vbartusevicius/weather-station/hardware/releases/v1/README.md

# AeroMet V1 Hardware Release Package (6 Boards on 1 Breakaway Panel + 13-Part Enclosure)

Generated by `python3 hardware/scripts/build.py` (`release.py`) from `hardware/layout/v1/` and `mechanical/`: per-board
KiCad DRC reports (`<board>/drc.json`), ODB++ (AISLER; also PCBWay / Eurocircuits), Gerber X2 + drills + IPC-D-356
netlist, a generic MPN BOM and placement file (PCBWay, Eurocircuits), JLCPCB BOM / CPL, hand-fit lists,
STEP models and renders; every JLCPCB SMT part verified pin-for-pin against its EasyEDA footprint. Which file goes to
which fab house: [`docs/building.md`](../../../docs/building.md#3-ordering-the-pcbs-and-assembly). Design status and open prototype checks:
[`REVIEW_CHECKLIST.md`](../../../REVIEW_CHECKLIST.md); commissioning: [`CALIBRATION.md`](../../../CALIBRATION.md).

| Board | Size | Layers | Thickness | Role in the Station | Folder |
| :--- | :---: | :---: | :---: | :--- | :---: |
| **Breakaway Panel (`panel`)** | **`140.6 × 63.2 mm`** | **4** | **`1.6 mm`** | **All six boards on one PCB (column packing, tabs clear of parts; order with "edge rails / fiducials added by JLCPCB"), double-sided assembly** | **`panel/`** |
| **1. `main`** | `32.0 × 52.0 mm` | 4 | `1.6 mm` | Right half of the base bay: 4-pole terminal `J1` (`12–32 V` + `RS-485 A/B`), `1.1 A` / `60 V` PTC, `SMAJ36A` TVS, `SS16` reverse-polarity diode, socketed `XIAO ESP32-C6` behind an `LM66100`, `SP3485EN` RS-485 (separate TX / RX / DE, `390 Ω` fail-safe bias, `PSM712` TVS, optional `120 Ω` `R26`), `LSM6DS3TR-C` IMU, `ADS1115` heater monitor, `AO3400A` reflector heater switch, crown control lines. Power nets `0.4 mm`. | `main/` |
| **2. `crown`** | `60 × 60 mm` (notched) | 4 | `1.6 mm` | `STM32G431RBT6` (I²C peripheral `0x2A`): 4× `UCC27524` H-bridge transducer drivers on `+12V_HEAT` with `BAV99` T/R isolation, `74HC4052` + `TLV9062` receive chain into the OPAMP1 PGA biased at VREF (PA3), piezo charge amplifier (22k / 1 nF anti-alias), `AS3935` + `MA5532-AE` on SPI1, `MMC5603NJ` compass, `XC6206` LDO, dome socket `J10`, spare `+12V_HEAT` `J11`, SWD footprint `J12`. | `crown/` |
| **3. `reflector`** | `24.0 × 24.0 mm` | 4 | `1.6 mm` | De-icing heater under the reflector cone: 4× `120 Ω` `2512` `2 W` in parallel on `+12V_HEAT` (`30 Ω`, `4.5 W` regulated), `10k` NTC `TH1`, 4-pin SMD male header `J1` to probe `J2`. | `reflector/` |
| **4. `dome`** | `Ø 15.6 mm` round | 4 | `1.6 mm` | UV / visible / NIR micro-PCB under the default flanged PTFE dome diffuser (lathe or CNC version; backup: the `Ø 20 × 2 mm` `JGS1` window in `crown_window`): `GUVB-C21SD` UV-B + `GUVA-C22SD` UV-A photodiodes, `TLV9062`, `ADS1115` (0x49), `TSL25911FN`, 4-pin B2B header `J1`. | `dome/` |
| `dome_legacy` | `Ø 13.6 mm` round | 4 | `1.6 mm` | Backup dome, same riser: `LTR-390UV-01` (discontinued), `TSL25911FN`, `GUVB-C31SM` (obsolete). Released separately (not on the panel, not in the order files). | `dome_legacy/` |
| **5. `probe`** | `14.0 × 56.0 mm` | 4 | `1.6 mm` | Vertical pagoda stem, bottom to top: `J1`, slot, `SHT40-AD1F-R2`, slot (no ground plane in its bridges), `SGP41-D-R4` + `BMP585`, `SCD41-D-R2` with the backside `0.42 W` heater and `LM2903` `−7.6 °C` thermostat, right-angle socket `J2` to the reflector. | `probe/` |
| **6. `power`** | `28.5 × 21.5 mm` | 4 | `1.6 mm` | Flat under `main`: 2× `TPS54360` (`743 kHz`) → `+5V` electronics and `+12V_HEAT` (heaters, transducer drive), `AP2112K-3.3` → `+3V3_PROBE`, 10-pin JST-SH `J1` to main `J5`. | `power/` |

Enclosure (`enclosure/`): assembled-position STL / STEP per part, `print/<plate>.stl` (8 print plates, the only files to
print), renders, and purchase drawings in `drawings/`: `ptfe_dome_lathe.svg` / `ptfe_dome_cnc.svg` (default UV / light cover:
flanged PTFE dome, lathe version from round rod or CNC hemisphere version; matching `ptfe_dome_<kind>.step` in the lathe frame for
the CNC quote) and `jgs1_window.svg` (backup window, `crown_window`
top).

Hand assembly: every board folder has `<board>_assembly.pdf`: one page per populated side (bottom mirrored, as seen
from below), every part with reference + value, a red dot on pin 1 (ICs, connectors, diodes), `[H]` on hand-fitted
parts, same value = same colour, large parts dashed (fit them last), and a value list with quantities and references.

Print process: the enclosure is designed for MJF / SLS PA12 (powder nylon, ~±0.3 mm), but **no part of it has been
printed yet** (no tested process). Design rules it follows (`mechanical/tests/test_print_rules.py`): snap beams ≤ 2.5 %
strain, hook undersides ≥ 0.3 mm above the board with a lead-in ramp, printed threads 0.30 mm flank clearance per side,
separate bodies on one plate ≥ 0.3 mm apart (reset button 0.40 mm), engraved marks ≥ 0.6 mm deep and ≥ 3 mm. Check on the
first print: clip snap force, thread fit (strut M12 + locknuts, probe sleeve M22, dome / window nuts M22), the three
bayonet joints locking, the reset button and umbrella moving freely, and the lock marks being readable.

## Parts orders for self-assembly (one complete station)

Generated by `hardware/scripts/order_parts.py` with every release (`release.py`); `hardware/tests/test_order_files.py`
fails when they differ from a fresh export. Live stock check: `python3 hardware/scripts/order_parts.py --check`.

| File | Upload to | Column mapping |
| :--- | :--- | :--- |
| `order_lcsc.csv` | lcsc.com → **BOM Tool** → Upload BOM | `LCSC Part Number` → *LCSC Part #*, `Quantity` → *Quantity*; optional `Manufacturer Part Number` → *MPN*, `Designators` → *Designator*, `Value` / `Footprint` → *Comment* / *Footprint*. Set the multiplier to 1 (one station); LCSC rounds each line up to its minimum order. |
| `order_elsewhere.csv` | by hand, per shop | electronics the LCSC store does not sell: `Mouser` / `Digi-Key` / `TME` columns (several numbers per shop separated by ` / `, the first preferred) + `Other sources`. General hardware (fasteners, O-rings, cable gland, thermal filler, coating, UV cover) and printed parts are only in `assembly_parts.csv` (column `Category`) |

`order_lcsc.csv` merges all boards (the legacy dome as `dome_legacy:ref`) into one line per LCSC number (designators `board:ref`) and adds the off-board
parts whose `Part` names an LCSC number. JLCPCB numbers the LCSC store does not stock are swapped for verified store
numbers in `hardware/product/lcsc_store.yaml` (the board BOMs keep the JLCPCB numbers). Parts the LCSC store does not sell (Sensirion SCD41 / SGP41 / SHT40, AS3935) are listed in
`order_elsewhere.csv` with a verified distributor (TME / Farnell / RS) from the `elsewhere:` section of that file. Run `--check` before ordering:
store stock changes daily, and the check lists every line that cannot be ordered as it stands.
