vbartusevicius/weather-station/REVIEW_CHECKLIST.md

# AeroMet V1 — Manufacturing-Readiness Fix Checklist

Source: design review of 2026-10-20 (commit `22ec981`). Phase 1 fixes applied 2026-10-21 (independent electrical / mechanical / docs items).
Status of the design: **NOT ready to order** (open: prototype checks Q1–Q4, Q6, S1–S5, N9–N10; sourcing decision B2; budget B5 re-quote; deferred N4). Review of 2026-10-23 (commit `6bfb492`) added N1–N13 (section 4c). Phase 2 (crown STM32 wind / rain / lightning, 12 V heater rail, RS-485 RX) is in source and the
release regenerates cleanly, but it is unprototyped: the bench / prototype checks listed per item are still required.
Commissioning / calibration steps for every built station: `CALIBRATION.md`.
Tick an item only when the fix is in the source (`hardware/circuits`, `hardware/circuits/variants/v1`, `mechanical/scripts`,
`station/src`), the release is regenerated (`python3 hardware/scripts/build.py`), and the listed acceptance check passes.

Severity: **B** = blocker (board/part will not work or cannot be assembled) · **H** = high (works badly / out of spec)
· **M** = medium (accuracy, robustness) · **D** = documentation/BOM.

---

## 1. Electronics (schematic)

- [x] **E1 (B) RS-485 receive path is impossible on one GPIO.** `blocks/mcu_xiao.py`, `firmware/main.cpp` (`uart_set_pin(UART_NUM_1, 18, 18, …)`).
  - **Status:** DONE in source (Phase 2): SP3485 DI / RO / DE+RE on GPIO16 / 17 / 19 (UART1 TX / RX / RTS, `UART_MODE_RS485_HALF_DUPLEX`), 390R fail-safe bias (≈ 0.25 V across a 120 R terminator), optional hand-fit 120 R terminator R26. OPEN: bench test with a USB-RS485 adapter.
  - TX push-pull fights RO (via 1 kΩ); in open-drain mode a received LOW enables DE → echo/oscillation.
  - Fix: separate TX and RX GPIOs (free a pin, e.g. move `US_SEL_A/B` to an I²C GPIO expander or use a TX-gated DE with RO on its own pin), or use a transceiver with true auto-direction.
  - Fail-safe bias 4k7/4k7 gives ≈ 41 mV with a 120 Ω terminator (needs ≥ 200 mV): use ≈ 560–680 Ω bias or document "no termination".
  - Accept: bench test with a USB-RS485 adapter (terminated) — PING/PONG + telemetry both ways at 115 200 bps.
- [x] **E2 (B) Probe heater thermostat LM393 outside common-mode range.** `blocks/probe_sensors.py` U4 on +3V3, inputs ≈ 2.27 V (CMR ≤ VCC−1.5 V = 1.8 V, ≤ 1.3 V over temp).
  - **Status:** DONE (Phase 1): U4 = LM2903 on +5V_HEAT (CMR 0..3.0 V over temp covers the 2.27 V node); hysteresis comment corrected to ~1.4 K.
  - Fix: swap NTC/resistor positions so the node sits ≈ 1.0 V (recompute setpoint + hysteresis), or power U4 from +5V_HEAT, or use a rail-to-rail comparator (e.g. TLV7031/TLV3201).
  - Accept: hand calc / SPICE shows both inputs within CMR from −40 °C to +60 °C; recompute hysteresis (current R7 gives ≈ 1.4 K, not 0.4 K).
- [x] **E3 (H) LM393DR2G is 0…+70 °C only** (crown U4, probe U4). Replace with LM2903 (−40…+125 °C) or automotive LM393.
  - **Status:** DONE (Phase 1): probe U4 is LM2903DR2G (C57474, -40..+105 C per onsemi / JLC data).
- [x] **E4 (B) 3.3 V logic into 5 V CMOS on the crown.** `blocks/crown_sensors.py`: SN74LVC2G04 U1 (VIH = 0.7·VCC = 3.5 V) and CD4052 select A/B (VIH 3.5 V) driven by 3.3 V GPIO over a 260 mm cable.
  - **Status:** DONE (Phase 2): no logic crosses the cable any more; the crown runs everything at 3.3 V (STM32, 74HC4052 at 3.3 V, UCC27524 TTL-threshold inputs).
  - Fix: 74AHCT1G04 / 74HCT-family driver, 74HCT4052 (or level shifter), or run the mux at 3.3 V.
- [x] **E5 (H) Ultrasonic TX AC-coupled below the mux VEE.** `US_TX_AC` swings ± around 0 V into CD4052 with VEE = GND → clamps into body diodes.
  - **Status:** DONE (Phase 2): TX no longer passes the mux; UCC27524 H-bridge per transducer with BAV99 T/R isolation; RX AC-coupled and biased at VREF inside the mux rails (ngspice: 0.25 mA peak mux-diode current).
  - Fix: bias the TX node at mid-supply or drive the mux with VEE negative / use a dedicated TX switch.
- [x] **E6 (H) Ultrasonic link budget unverified (likely 20+ dB short).** ≈ 3 Vpp through 1 kΩ into closed-face transducers; RX gain 529; threshold 230 mV.
  - **Status:** DONE in design (Phase 2): 21.8 Vpp H-bridge drive from +12V_HEAT (ngspice `hardware/sim/crown_us_link.py`), receive chain G 7.8 x PGA 2..32 sized for a 3..170 mV echo. OPEN: the echo amplitude is an estimate until measured on the real transducers + reflector.
  - Fix: higher-voltage TX (H-bridge/transformer, 20–100 Vpp per transducer datasheet), reconsider 1 kΩ RX load, re-derive gain.
  - Accept: breadboard with the actual transducers + printed reflector geometry shows ≥ 10× margin over threshold at −20 °C and in rain.
- [x] **E7 (H) Zero-cross + envelope comparators are wired-AND to one pin** → output is just "amp > VTH" (amplitude-dependent timing, cycle-slip = 25 µs ≈ 29 m/s).
  - **Status:** DONE (Phase 2): echoes digitised at 2 MSPS; 50 % envelope fit for the mean ToF + reciprocal cross-correlation (coarse lobe from the envelope, so no cycle slips at > 1 period); host tests on simulated echoes (`pio test -d crown -e native`).
  - Fix: envelope gate latches/enables a true zero-cross edge (separate outputs or logic), firmware measures several zero-crossings / phase.
- [x] **E8 (B) AS3935 antenna is a shielded power inductor.** `blocks/main_sensors.py` L2 SWPA6045S221MT (closed core, ±20 %, f0 = 495 kHz < 500 kHz).
  - **Status:** DONE (Phase 1): L2 = Coilcraft MA5532-AE (hand-fit) + 2x 470 pF C0G (AN04 953 pF target), 10k Q damping, In1/In2 plane keepout under the antenna. Verify tuning (TUN_CAP near 73 pF) on the prototype.
  - Fix: Coilcraft MA5532-AE (or datasheet-approved ferrite rod) + matching C0G tank cap; keep 500 kHz ± 3.5 % tunable.
- [x] **E9 (B) Both SCT2430 bucks switch at 500 kHz = AS3935 receive band**, ~10 mm away. `blocks/power_supply.py` RT = 200k.
  - **Status:** DONE (Phase 1): bucks at 743 kHz. Phase 2: move the AS3935 + MA5532 to the crown board on the STM32 SPI bus (away from the bucks / ESP32, fixes E10 too).
  - Fix: move fsw to 1.5–2.2 MHz (re-design L/C/compensation per datasheet) and/or relocate AS3935 away from the power board and ESP32.
- [x] **E10 (H) AS3935 over I²C is known-unreliable** (vendor/breakout notes). Consider SPI (needs pins — see E1) or verify on prototype.
  - **Status:** DONE (Phase 2): AS3935 on the crown STM32 SPI1 (SI = GND), automatic TUN_CAP tuning by counting LCO/16; AS3935 + MA5532 removed from main.
- [x] **E11 (B) Input surge protection cannot protect SCT2430 (40 V max).** SMAJ33A clamps at 53.3 V; PTC rated 33 V.
  - **Status:** DONE (Phase 1): 12-32 V kept; power board = 2x TPS54360 (60 V), SMAJ36A (58.1 V clamp), 2920L110/60V PTC, 100 V input MLCCs on main and power.
  - Fix: 60 V-class regulators (e.g. LMR36015/TPS54560 class) or lower the input spec (e.g. 12–24 V) with a matching TVS; consider SMBJ/SMCJ size for a roof cable.
- [x] **E12 (H) No surge/ESD protection on RS485_A/B** (outdoor cable, lightning region). Add SM712-type TVS + optional series PTC/resistors.
  - **Status:** DONE (Phase 1): D4 = PSM712 (C32677, basic part) at J1.
- [x] **E13 (H) Piezo rain AFE.** `blocks/crown_sensors.py` U5A: non-inverting input at 0 V on single supply, 100k‖18p (corner 88 kHz → not a charge amp), hail drives input below GND through only 1 kΩ.
  - **Status:** DONE (Phase 2): true charge amplifier (22 nF ‖ 4.7 MΩ at VREF), 1 k series + BAV99 clamp, digitised by STM32 ADC2 at 50 kSPS (`RainDetector`, host-tested). OPEN: rain calibration (S2).
  - Fix: bias at VREF, true charge amp (e.g. 1–10 nF ‖ 10 MΩ), ≥ 10 kΩ series + clamp diodes (BAV99) to rails; add a real peak detector if an envelope is wanted.
- [x] **E14 (M) I²C rise time.** 4k7 pull-ups on ≈ 200 pF (12 devices + 260 mm + 60 mm + 100 mm cables) → ≈ 0.8 µs > 300 ns (400 kHz).
  - **Status:** DONE (Phase 1): I2C pull-ups 2.2k (C4190, basic). 2026-10-23 (N11): ~180 pF with 2.2k still rises in ~335 ns (> 300 ns fast-mode), so every device now runs at 100 kHz.
  - Fix: 2.2 kΩ (check all sink currents) and/or 100 kHz bus; keep US_TX away from SDA/SCL in the 12-pin cable pin order.
- [x] **E15 (M) Reflector heater resistors at 93 % of rating** (4× 27 Ω 2512 1 W at 5 V) touching the plastic deck (0.08 mm). Use 2 W parts or more resistors; add firmware over-temperature cut-off on TH1.
  - **Status:** DONE (Phase 1): reflector resistors 27R 2512 2 W HP12 (C2791259) = 46 % of rating; firmware open-NTC SensorFault lockout (unit-tested).
- [x] **E16 (M) 3V3 budget from the XIAO LDO** (≈ 550 mA peaks: ESP32-C6 TX + SCD41 + sensors; Seeed rates 600–700 mA). Measure on prototype or add a dedicated 3V3 regulator.
  - **Status:** DONE: dedicated `+3V3_PROBE` rail: AP2112K-3.3 (C51118, 600 mA, -40..+85 C) on the power board from +5V, through power J1 / main J5 (now 10-pin, 3 GND contacts) straight to probe J3 pin 7. The XIAO 3V3 regulator now carries only the ESP32-C6 (354 mA TX peak) + main-board sensors / pull-ups / RS-485 bias (≈ 25 mA) ≈ 380 mA vs its 700 mA rating; the probe rail peaks ≈ 215 mA (SCD41 205 mA) vs 600 mA. OPEN: confirm on the prototype (CALIBRATION.md step 1).

## 2. PCB layout / fab

- [x] **P1 (H) Power board is auto-routed with 0.3 mm tracks** for VIN / SW / VOUT, GND plane only on In1, no pours, few vias.
  - **Status:** DONE: TPS54360 stages per SLVSBB4G; SW nodes, VIN and VOUT are F.Cu pours (SW ~14 mm2, 3.5 mm residual track + 1 via to the bottom boot cap), J1 along the top edge, board 28.5 x 21.5 mm; 0 DRC / 0 unrouted.
  - Fix: hand layout per SCT2430 datasheet (tight hot loop, pours on F.Cu, thermal vias under EP, SW node minimal area).
- [x] **P2 (M) Probe: reflector heater current (now ≈ 0.4 A at 12 V, was 0.74 A) routed past SHT40**, and the In1 GND plane connects SHT40 to J1 (which sits in the warm base bay).
  - **Status:** DONE: second milled slot (y 9.0-10.2, copper keep-out on all layers) between J1 and the SHT40, so heat from the base bay and the heater pair reaches the SHT40 only over the two 2 mm side bridges; probe re-routed 0 DRC. The heater-side coupling was still large: see N2.
  - Fix: route heater pair on the far edge, add copper keep-out / second slot between J1 and SHT40.
- [x] **P3 (M) Panel has no fiducials, tooling holes or edge rails** (5-board panel 146.6 × 52.1 mm; the crown ships as its own board). Add rails + fiducials or order "added by JLCPCB" for both orders.
  - **Status:** DONE (owner decision: no own rails): compact 140.6 x 63.2 mm panel (column packing search over rotations / orders, tabs placed >= 1 mm from part pads, every board on >= 2 tabs); order with "Edge rails / fiducials: added by JLCPCB".
- [x] **P4 (D) Double-sided assembly** on the panel (main, power, probe, dome, reflector bottom parts) and on the crown — budget for it.
  - **Status:** DONE (costed): the panel has parts on both sides (97 top / 109 bottom placements): Standard PCBA double-sided adds $25.56 setup and $8.21 stencil over single-sided (included in B5); no part forces a single side.

## 3. Mechanical (verify on released STEP, not only on the parametric model)

- [x] **M17 (B) Main J1 pin labels were mirrored** ("+V GND A+ B-" over a 180-deg rotated terminal whose pins run B-, A+, GND, +V).
  - **Status:** DONE: per-pin labels at each pad; every connector now carries a silk label with the board/port it connects to (`connector_labels`).

- [x] **M1 (B) Bayonet O-rings have zero compression.** Gland 1.70 mm (up to 1.90 mm with lug play) vs 1.5 mm CS, on base↔pagoda, pagoda↔wind_tunnel, crown_base↔crown.
  - **Status:** DONE (Phase 1): 88 x 2.0 mm O-rings; glands 1.5 mm modelled / 1.7 mm at rest (15 %) / 1.23 mm pushed (38 %, 77 % fill); `test_bayonet_o_rings_are_squeezed_15_to_40_percent`.
  - Fix: design the gland for 15–25 % squeeze of a real O-ring (e.g. depth ≈ 1.15–1.25 mm with CS 1.5 at the locked position, or CS 2.0 mm ring); make lug shelf hold the compressed state.
  - Accept: new test computing gland height at the locked lug position vs purchasable O-ring CS.
- [x] **M2 (B) Printed M12 strut nuts: thread groove (r 6.22) cuts through the 12 mm flats** — nut section splits into pieces. Pockets Ø15.2/Ø16.4 cannot take real M12 nuts (18 AF).
  - **Status:** DONE (Phase 1): printed nuts 15 mm AF (1.28 mm wall at the flats), pockets r 9.0; README no longer claims metal-nut compatibility; `test_printed_strut_nuts_keep_a_wall_at_the_flats`.
  - Fix: either real ISO M12 nuts (pocket ≥ 18.6 AF/round 21) or a non-standard printed thread with ≥ 1.5 mm wall at the flats.
- [x] **M3 (B) ISO 4762 M6 socket heads (Ø10 × 6 mm) collide with all 4 reflector board corners** (2.4 mm³ each). Tests model a 2.4 mm head.
  - **Status:** DONE (Phase 1): DIN 7984 low-head M6x55 (head 10 x 3.5) in BOM/CAD, head wells Ø 10.6; test models real head + ISO 4032 nut + bolt tip vs pagoda, wind_tunnel, struts, reflector board, base.
  - Fix: DIN 7984 low head / button head, or chamfer reflector corners, or move bolts; head wells Ø10.0 → Ø10.6.
- [x] **M4 (B) Crown cable path.** Ø4.2 mm cable vs 3.35 mm sleeve conduit (73 mm³ overlap); 4.38 mm gap under wind_tunnel deck with the NE M6 head on the radial path; 90° bend into the strut within ≈ 3 mm; plug must pass the M12 nut bore.
  - **Status:** DONE: rear conduit 4.1 mm deep with >= 0.8 mm walls (probe_sleeve_back widened/deepened inside the r 10.35 hub-bore circle), `test_crown_cable_and_probe_jumper_sweep_clear`: Ø 3.2 mm cable (+0.3) on a 10 mm bend radius from main J2 through the umbrella window, conduit, pagoda gap, NE strut and past the crown NE chamfer to crown J1 clears every part and PCB; path 202 mm + slack fits the 260 mm BOM cable. OPEN: thread-and-crimp assembly step on the first build.
  - Fix: widen conduit ≥ 5 mm, dedicated radial groove in the wind_tunnel underside clear of bolts, larger bend space, or use a flat FFC/ribbon + inline connector.
  - Accept: test sweeping a Ø(cable + 0.5) tube along the full routed path from main J2 to crown J1 with zero intersection.
- [x] **M5 (B) Transducer barrels Ø10.5 mm vs listed Ø14+ mm parts.** Pick ONE purchasable waterproof 40 kHz transceiver, then size barrel, aperture and retaining ring to its drawing.
  - **Status:** DONE: default transducer = Same Sky CUSA-TR65-065-2200-TH68 (Ø 14 x 9 mm aluminium, IP68, 150 Vp-p rated, 2200 pF, 65 deg, -40..+80 C, ~$3-6 at Digi-Key / Mouser) straight in the Ø 14.6 mm barrels (0.3 mm radial clearance), locked by the printed rings; tested in CAD (can, ring, Ø 12 mm aperture, crown PCB). Alternatives with a rated drive: PUI UTR-1440K-TT-R (Ø 14.4, 140 Vp-p), Multicomp MCUSD14A40S09RS (Ø 14, 160 Vp-p). Ø 10 mm parts (EU10AIF40H07T/R) still fit the printed sleeves but publish no drive rating. OPEN: check the can tolerance on the delivered parts.
- [x] **M6 (B) Captive printed-in-place parts.** base.stl: umbrella (0.40 mm gap) and reset button (0.30 mm) inside the base; struts.stl: nuts threaded on with 0.2 mm, rings 0.098 mm from the dome nut. MJF/SLS fuse < ~0.5 mm; FDM cannot print the floating umbrella.
  - **Status:** DONE (Phase 1): `enclosure/print/<part>_<nn>.stl` one body per file (base 3, pagoda 5, struts 21, orings 5, mast_shims 4); README/BOM point to it; `test_every_print_body_is_exported_separately_and_printable`.
  - Fix: export every separate body as its own STL (`umbrella.stl`, `reset_button.stl`, `strut_half_*.stl`, `m12_nut.stl`, …); use ≥ 0.5 mm clearance where parts must print captive.
- [x] **M7 (H) Mast clamp only clamps Ø33.5–34 mm** (split gap 0.5 mm), 19 mm pole engagement. Fix: ≥ 2–3 mm clamp travel + shims for 25–34 mm, ≥ 40 mm engagement, consider U-bolts / hose clamps.
  - **Status:** DONE: 40 mm tall clamp (owner decision; socket from y = -12, 31 mm pole engagement), 6x M6 bolts in 3 rows (13 mm pitch, ISO 7089 washers), 2.0 mm clamp travel, 4 shim sizes 31 mm tall (Ø 24-34 mm poles). Keep bolt torque moderate on PA12.
- [x] **M8 (H) Pagoda louvers ≈ 0.71 mm thick** (measured) on ≈ 24 mm spans. Fix: ≥ 1.5–2 mm normal thickness.
  - **Status:** DONE (Phase 1): louver blades 1.6 mm normal thickness (lower surface moved down).
- [x] **M9 (H) Radiation shield leaks:** 64/256 horizontal and 124/204 upward (−10°) rays reach the probe core. Fix: overlapping louvers that block lines of sight both from sky and from roof (classic double-louver Stevenson profile).
  - **Status:** DONE: labyrinth = upturned rim on each blade's inner edge (r 24.2–25.8, +7.0 mm) + down-skirt under the blade / top deck above (r 30.0–31.4, to +5.0 mm). `test_radiation_labyrinth_blocks_every_line_of_sight_to_the_probe`: 0 of 2 × 2 480 rays aimed at the shielded zone (y 76–115.5) (−75…+75°) reach the probe core (92 per section without it). Cost: the narrowest air passage drops from ≈ 9.4 mm to ≈ 3.3 mm (rim-to-skirt channel), so expect more self-heating error in still air — check against an aspirated reference (S3).
- [x] **M10 (M) Reflector deck "thermal contact" relies on a 0.08 mm gap** with stack-up tolerance ±0.3 mm. Add a compliant thermal pad or define a hard stop.
  - **Status:** DONE (BOM + README): silicone-free thermal gap filler between the heater resistors and the deck covers the 0.08 mm (+/-0.3) gap; silicone excluded because it poisons the SGP41.
- [x] **M11 (M) No U.FL antenna cradle in CAD** (claimed in README/BOM). Add it or remove the claim.
  - **Status:** DONE (Phase 1, docs): no cradle in V1; BOM/README say adhesive-mount the dipole on the inner wall.
- [x] **M12 (M) Reset-button bore is an open hole** (no O-ring in CAD, README says waterproofed). Add gland or membrane.
  - **Status:** WON'T FIX (owner decision): an O-ring's friction would stop the button's spring from returning it. The bore opens downward on the base underside (drip side, no standing water) and the README no longer claims a waterproof button.
- [x] **M13 (M) JGS1 dome stack-up.** Flange must be ≤ 1.2 mm thick (194.2 − 193.0); dome PCB clears the inner hemisphere by only ≈ 0.3 mm; no desiccant/vent → internal dew. Get a real dome drawing and add an ePTFE vent or desiccant.
  - **Status:** DONE (stock part + option; superseded by N3: the default is now the PTFE dome in `crown`, the window top is `crown_window`): two crown tops. Window top: stock uncoated Ø 20 x 2 mm JGS1 disc in a raised boss, thin 17 x 1.0 mm O-ring between the window top and the 1.2 mm lip (seal lid <-> glass, the nut thread is outside the wet side), printed nut pushes the window from below; sensors 0.5 mm under the window; drains through the lip above the seal plane. Sky view from ~19-32 deg elevation (S4 corrects). `crown_dome`: Ø 20 mm hollow JGS1 hemisphere (made to order), lid flush at y 198.0 under the sensor tops (horizon view, no raised border), 19 x 1.0 mm O-ring in the bore / lip-underside corner gland squeezed ~21 % by the sphere, shorter nut. Both nuts on the struts plate. Tests: `test_uv_window_stack_fits_the_crown_lid`, `test_uv_dome_crown_top_fits`. Drawing `enclosure/drawings/jgs1_window.svg`.
- [x] **M14 (M) Cable gland needs a hollow mast** (gland dome nut extends below the y = 19 mm pole stop). Document the required mast ID.
  - **Status:** DONE (docs): README section 4 and the gland BOM line require a hollow mast with ID >= 18 mm (e.g. 33.7 x 3.2 mm pipe) with the cable inside.
- [x] **M15 (M) Probe sleeve final angle is set by thread run-out + O-ring squeeze** (uncontrolled). Add a key/index or a non-threaded keyed bayonet.
  - **Status:** WON'T FIX (owner decision): a key would stop the thread before the bottom O-ring reaches full squeeze. The probe works at any sleeve angle (the sleeve is round; the probe board's orientation comes from its own slot).
- [x] **M16 (D) "No supports needed" FDM claim** is not true for base clips/hooks, barrels at 29°, umbrella. Re-check print orientation per part.
  - **Status:** DONE (docs): README FDM orientation / support table per print plate (MJF/SLS need none).

## 4. Firmware

- [x] **F1 (B)** UART single-pin config (see E1).
  - **Status:** DONE in source (Phase 2): separate RX pin, RS-485 half-duplex mode with RTS-driven DE (see E1).
- [x] **F2 (H)** Ultrasonic: 300 µs settle is short for ringing closed-face transducers + 48 mm cavity reverberation; first-edge capture has cycle-slip risk. Implement multi-zero-crossing / phase measurement, longer settle, and cross-check N→S vs S→N cycle index.
  - **Status:** DONE (Phase 2): crown firmware (`crown/`) with sampled-echo DSP (see E7); the station receives CRC-checked times of flight over I²C and rejects quads with any bad path.
- [x] **F3 (M)** RS-485 streams telemetry unconditionally every cycle → collides with a polling master. Respond only when polled or use a time slot.
  - **Status:** DONE in source: `task_rs485` answers `STATE?` with the latest frame (plus `PING`, `RESET_RAIN`, `HEAT_CHECK`) and never transmits unsolicited. OPEN: bench test with a polling master.
- [x] **F4 (M)** I²C at 400 kHz for every device (see E14); PMSA003I 100 kHz max.
  - **Status:** DONE: the whole bus runs at 100 kHz (`board::i2c_speed_hz`, N11); per-device speeds stay possible via `I2cBus::add(addr, hz)`.
- [x] **F5 (M)** Heater over-temperature cut-off and NTC plausibility (open/short) before enabling PWM.
  - **Status:** DONE (Phase 1): `HeaterState::SensorFault` for an open reflector NTC (> 3270 mV), unit test added. 25 C over-temperature cut-off already existed.

## 4b. Phase 2 items still open (crown v2 / 12 V rail)

- [ ] **Q1 (H)** Crown firmware HAL glue (`crown/src/main.cpp`) compiles but has never run: bring up on the first board with SWD (`J12`, Tag-Connect TC2030-NL): clock, TIM8 burst + dead time on a scope, ADC/TIM6 sample timing, I²C peripheral, AS3935 SPI + tuning.
- [ ] **Q2 (H)** STM32G431 ROM I²C bootloader address: firmware tries 0x52 and 0x56; confirm against AN2606 / the first board (CALIBRATION.md step 2). `kCmdEnterBootloader` relies on a `.noinit` RAM flag the default linker script may zero; the BOOT0 line is the primary path. BOOT0 pin: RM0440 factory option bytes (`FLASH_OPTR` = 0xFFEF F8AA: nSWBOOT0 = 1, nBOOT0 = 1) take BOOT0 from PB8, so a factory-fresh chip honours CROWN_BOOT0 — confirm on the first board.
- [ ] **Q3 (H)** Echo amplitude: ngspice uses an estimated ~50 mVpp EMF; measure with the real transducers + printed reflector, then trim the preamp gain (R21) if needed. Wind-tunnel calibration (S1) still required.
- [ ] **Q4 (M)** AS3935 vs ultrasonic bursts: log disturber / noise events with bursts on and off on the prototype (actions `crown_bursts_off` / `crown_bursts_on`, counters in `/api/config` → `crown.disturbers`; CALIBRATION.md step 9).
- [x] **Q5 (M)** Transducer adapters (M5): barrels now Ø 14.6 mm (Ø 12 mm aperture, 8.8 mm shroud clipped below the crown PCB), crown notches 16 mm wide; printed `transducer_adapters` = 4 Ø 10 mm sleeves (installed by default) + 4 rings for Ø 14 mm cans. Tested: both can sizes, rings and apertures clear barrels, sleeves and the crown PCB. OPEN: confirm against the real transducer drawings (can height, pigtail exit) before printing.
- [ ] **Q6 (M)** +12V_HEAT pass-through below ~13.5 V input: verify the TPS54360 near-100 % duty behaviour and heater power on a 12 V supply.
- [x] **Q7 (H) UCC27524 enable pull-up.** ENA/ENB are pulled up to VDD = 12 V through 200 kΩ (SLUSFA9 `RENx`, typ.); the 10k pull-down left an undriven EN at 0.57 V against a 0.8 V minimum low threshold.
  - **Status:** DONE: R13–R16 = 4.7k → 0.28 V undriven (drivers off in reset / bootloader); the STM32 drives 3.3 V (> 2.3 V max high threshold) and sinks ≤ 60 µA from the internal pull-up when low.
- [x] **Q8 (H) Rain wetness flag stuck on.** Crown impacts carried a fixed 206 mV "baseline" ≥ the 140 mV wet threshold.
  - **Status:** DONE: crown impacts carry baseline 0 (no capacitive channel); `HapticRainProcessor` then reports wet while a rain event runs and keeps rejecting only long (> 850 µs) pulses during mast shake. New `rain_impact_scale` maps charge-amp mV to the drop / hail thresholds (CALIBRATION.md step 6). Unit-tested. OPEN: the thresholds themselves need the field calibration.
- [x] **Q9 (H) Wind wrong until calibrated.** The crown times the 50 % envelope point (~58 µs after the first arrival); `us_delay_us` defaulted to 0 → speed of sound and wind magnitude off by ~35 %.
  - **Status:** DONE: default 58 µs, plus the `wind_calibrate` action (60 s still air, delay + zero-wind offsets from the SHT40 temperature, refuses moving air; unit-tested) and `wind_speed_gain` for the reference comparison (CALIBRATION.md steps 4–5).
- [x] **Q10 (M) RS-485 multi-drop.** Every station answered `STATE?`; `PONG` carried a fake `*0000` checksum.
  - **Status:** DONE: `rs485_address` (0 = single station, 1–247 = `<addr>:CMD`, talker `$AM<addr>`), real CRC-16/MODBUS on `PONG`; unit-tested. OPEN: bench test (CALIBRATION.md step 3).
- [x] **Q11 (M) Crown status read unprotected.** The 2-byte status shared the 260 mm cable with the 50 mA drive bursts without a CRC.
  - **Status:** DONE: protocol v2, `kStatus` = status + CRC-8, the station drops bad reads (crown + station tests). OPEN: measure crosstalk on the first board (scope on SDA/SCL during bursts).
- [x] **Q12 (H) Crown production programming.** PARTIAL: no SWD fixture is needed — a factory-blank STM32 enters its ROM I²C bootloader when the station raises BOOT0 (RM0440 default option bytes), so the station flashes it (`POST /api/crown/firmware`, CALIBRATION.md step 2); SWD is a Tag-Connect TC2030-NL footprint (`J12`) for debug / recovery. OPEN: release the crown image with each station release and add a station-side version check / auto-update (not implemented).
  - **Status:** DONE: the station embeds the crown image (`CrownImage.hpp`, `station/scripts/pack_crown_image.py`, crown fw 0.2.0) and at boot reflashes a crown with another version or a blank one (one attempt per boot, result in `/api/config` → `crown.auto_update`); decision host-tested. SWD via the TC2030-NL footprint `J12` for debug only. OPEN: confirm on the first board (Q2).
- [x] **Q13 (M) Transducer drive rating.** ~22 Vpp differential bursts (8 cycles, 16 / s): confirm the chosen transducer's maximum drive voltage from its datasheet before ordering (EU10AIF40H07T/R or the Ø 14 mm alternative).
  - **Status:** DONE: CUSA-TR65-065-2200-TH68 is rated 150 Vp-p; the ~22 Vp-p bursts are 15 % of that.
- [x] **Q14 (M) Power-board hot loop after the Phase 2 re-route.** Re-measure SW-node copper on the final released `power.kicad_pcb`.
  - **Status:** DONE (measured on the release): LOGIC_SW / HEAT_SW pours 13.7 mm² each on F.Cu, 3.8 / 3.4 mm of residual 0.4 mm track, 1 via each (boot cap); VIN_PROT 22.4 mm², +5V 17.6 mm², +12V_HEAT 18.2 mm² pours — same as the Phase 1 hand layout.
- [x] **Q15 (D) Crown is a separate PCBA order.** 60 × 60 mm non-rectangular 4-layer board, double-sided assembly, 0.5 mm-pitch LQFP-64 on the bottom: quote it separately (see B5).
  - **Status:** DONE: the crown is on the panel (right end, 3 rail tabs; both facing edges near the power board are too crowded for side tabs).
- [x] **Q16 (M) Config migration.** New `StationConfig` fields used to reset the whole NVS config (Wi-Fi, location) on every firmware update (`len == sizeof`).
  - **Status:** DONE: fields are only appended; a shorter stored blob fills the prefix and new fields keep their defaults.

## 4c. Review of 2026-10-23 (N-items)

- [x] **N1 (B) Crown PGA amplified the 1.65 V bias.** OPAMP1 ran in the plain PGA mode (`PGA_CONNECT_INVERTINGINPUT_NO`): Vout = G × 1.65 V pinned the ADC at the 3.3 V rail for every gain, so no echo could be measured (E6 / E7 / F2 / Q3 were blocked by it).
  - **Status:** DONE in source: U1 pin 17 (PA3 = OPAMP1_VINM0) on `US_VREF`, firmware `OPAMP_PGA_CONNECT_INVERTINGINPUT_IO0_BIAS` (Vout = G (Vin − VREF) + VREF), the gain writes keep the bias bits; ngspice + test `test_pga_is_biased_at_vref_not_ground` (preamp at its real DC level into the PGA in both modes; checks circuit + firmware). Crown fw 0.3.0. OPEN: scope check on the first board (CALIBRATION.md step 2.5).
- [x] **N2 (H) Probe heater warmed the SHT40.** 1-D model of the released probe: SHT40 +9.8 / +4.3 / +1.9 K at h = 10 / 25 / 50 W/m²K with the 0.42 W heater on (the In1 plane crossed the heater-side slot bridges); the heater ran at every temperature below +8 °C.
  - **Status:** DONE in source: SCD41 + heater moved to the top of the probe (next to J2), SGP41 / BMP585 to the middle, thermostat setpoint +8 → −7.6 °C (R5 22k → 51k, ~2.3 K hysteresis; the SCD41 is rated −10 °C), In1 ground plane removed from the heater-side slot bridges. Model: +5.6 / +1.7 / +0.5 K, and only below −8 °C. OPEN: cold-chamber check (CALIBRATION.md step 7).
- [x] **N3 (H) UV / light sensors blind below 19–34° solar elevation** (window 3.25 mm under the 1.2 mm lip; Vilnius winter noon sun 11.8°).
  - **Status:** DONE in source (revised 2026-10-23, owner decision): default top = `crown` with a low flush collar (0.9 mm lip, lid apex trimmed to y 197.8, 1.0 mm under the sensor tops) around a turned PTFE dome with a flat-faced Ø 20.4 x 1.5 mm flange (`UV_PTFE`): the 18 x 1.0 O-ring is squeezed 25 % flat between flange top and lip, the dome nut pushes the flat flange bottom. Two shapes from one profile function (`ptfe_dome_profile`): lathe version (default, Ø 17.8 cylinder + flat top, 2 mm edge radius, from round rod; `enclosure/ptfe_dome_lathe.step` + `drawings/ptfe_dome_lathe.svg`) and CNC version (Ø 17.8 hemisphere; `ptfe_dome_cnc.*`), 0.8 mm wall. Backup top = `crown_window` with the stock Ø 20 x 2 mm JGS1 disc. Test `test_uv_dome_crown_top_fits`: both shapes fit, flange faces flat, O-ring squeeze / lip backing, no lid material above −3° from the dome sensors (sunrise / sunset visible). No stock PTFE dome: PCBWay CNC turning (PTFE) / custom turning shop / lathe. Firmware `optics_transmission` default 0.11. OPEN: calibrate the transmission and the low-sun over-response (CALIBRATION.md step 8); total height 235 mm (lathe version; 238 mm with the CNC hemisphere).
- [ ] **N4 (H) No transducer de-icing.** Rime / wet snow on the Ø 14 mm transducer faces stops the wind measurement in freezing fog; only the reflector is heated.
  - **Status:** DEFERRED to crown v2.1 (owner decision): low-side MOSFET on J11 (+12V_HEAT) driven by a spare STM32 pin, 4 × ~1 W polyimide heater strips wrapped round the aluminium cans (barrel bore + ~0.3 mm radius), switched below +2 °C at high RH; +12V_HEAT budget ~9 W (reflector 4.5 + probe 0.4 + 4). V1 documents winter wind outages.
- [x] **N5 (M) Rain channel aliasing / burst pickup.** 50 kSPS behind 1k / 1 nF (160 kHz) aliases 40 kHz burst pickup to 10 kHz; no blanking.
  - **Status:** DONE in source: R24 1k → 22k (7.2 kHz with C22 1 nF, no new BOM line), crown firmware blanks the detector from each burst start to 1 ms after the capture (`RainDetector::add(..., blanked)`, host test `test_rain_detector_ignores_burst_window`). OPEN: dry-weather check (CALIBRATION.md step 9.5).
- [x] **N6 (M) TIM8 left OUTA high after the burst** (one-pulse mode rests at CNT = 0 < CCR1).
  - **Status:** DONE in source: TIM8 update IRQ (URS) clears MOE at the end of the burst; dead time 118 → 353 ns so CH1 cannot rise before MOE drops. OPEN: scope (CALIBRATION.md step 2.5).
- [x] **N7 (M) Main input power tracks 0.3 mm, partly on 0.5 oz In2** (VIN_FUSED 11 mm, up to ~0.9 A).
  - **Status:** DONE in source: main `power_track_width` 0.4 mm (fits the 1.0 mm JST-SH pitch).
- [x] **N8 (M) RS-485 fail-safe bias on every node** (4 stations → 97 Ω per rail + termination → below the driver VOD spec).
  - **Status:** DONE (docs): CALIBRATION.md step 3 — on buses with > 2 stations remove R9 / R10 on all but one station.
- [ ] **N9 (M) Bayonet O-ring squeeze tolerance.** 15 % at rest is the bottom of the face-seal range; +0.25 mm print / stack error leaves ~3 %.
  - **Status:** OPEN (prototype): measure glands + hose test (CALIBRATION.md step 10a).
- [ ] **N10 (M) AS3935 vs the reflector heater PWM** (0.4 A, 1 kHz, loop up the probe to under the crown); AS3935 VDD had 100 nF (datasheet 1 µF).
  - **Status:** C25 → 1 µF done in source. OPEN: disturber test with the heater on (CALIBRATION.md step 9.4).
- [x] **N11 (M) I²C rise time at 400 kHz** ≈ 335 ns > 300 ns.
  - **Status:** DONE: all devices at 100 kHz (bus load ~35 %: IMU 200 Hz, BMP585 FIFO 100 Hz, crown, slow sensors).
- [x] **N12 (M) Crown cable sourcing / crimping.** Pre-crimped 28 AWG SH leads (OD 0.8–1.0 mm) bundle to ~4 mm and do not fit the conduit.
  - **Status:** DONE (BOM / README): 30 AWG, insulation OD ≤ 0.6 mm (UL10064 / UL1571), SSH-003T-P0.2 contacts + SH-capable crimper.
- [x] **N13 (M) STM32 ROM bootloader pin noise** (USART1 RX PA10 / SPI2 NSS PB12 floating).
  - **Status:** DONE in source: R28 / R29 10k pull-ups on PA10 / PB12 (PA3 now carries VREF). OPEN: confirm with Q2.

## 5. Sensor accuracy (needs prototype + calibration, not just a fix)

- [ ] **S1** Wind: wind-tunnel calibration table per direction (strut wakes along 45°/135°/225°/315° cross the centre).
- [ ] **S2** Rain: calibrate drop count / energy vs a tipping-bucket gauge; remove "0.01 mm" claim until done.
- [ ] **S3** T/RH: compare with a reference aspirated sensor in sun / low wind; quantify base-bay and roof-radiation bias.
- [ ] **S4** UV/light: TSL25911 saturates ≈ 88 klx and is rated −30…+70 °C under a sealed dome; derive UVI/irradiance calibration.
- [ ] **S5** Temperature ratings below −10 °C: SGP41, PMSA003I, SCD41 (heater covers SCD41 only), JST-SH (−25 °C).

## 6. Chemistry / assembly

- [x] **C1 (B) README tells to use Molykote 111 / RTV silicone in the probe sleeve groove next to SGP41.** Siloxanes poison MOX sensors. Replace with a non-silicone sealant (e.g. PU / PTFE grease) and align README with `assembly_parts.yaml`.
  - **Status:** DONE (Phase 1): README now forbids silicone anywhere in the station; PTFE grease or PU resin in the sleeve groove; non-silicone coatings.
- [x] **C2 (D)** Conformal-coat keep-out list names `VEML7700` (part is TSL25911).
  - **Status:** DONE (Phase 1).

## 7. BOM / sourcing

- [x] **B1 (B)** Crown cable listed as 10-core + SHR-10V; main J2 / crown J1 are **12-pin** (BM12B). Fix BOM: 12-core, SHR-12V, pin-1↔pin-1, real routed length (spec says 160 mm, BOM 260 mm).
  - **Status:** DONE (Phase 1): BOM = 12-conductor, OD <= 3.2 mm, SHR-12V both ends pin 1 <-> pin 1, 260 mm (+ note about threading through the strut nut).
- [ ] **B2 (H)** LTR-390UV-01 and AS3935 show 0 stock at JLC → order from Digi-Key/Mouser and hand-fit (the AS3935 QFN-16 now sits on the crown, the MA5532-AE antenna too); plan hot-air rework for 2×2 mm / QFN-16.
  - **Status:** PARTIAL (sourcing checked): AS3935-BQFT Digi-Key 1,279 in stock, $13.61 (brokers ~$6); MA5532-AE(B) Mouser 994-MA5532-AE ~831, $1.93 (Coilcraft direct ~1.18 EUR); LTR-390UV-01 0 at LCSC/JLC, ~3,400 at brokers ~$0.9-1.6 (one Chinese distributor lists it as discontinued: confirm with Lite-On / Mouser before buying); GUVB-C31SM ~2,300 at brokers ~$10.5 (-30..+85 C). Instead of hand rework, these can be bought into JLC by Global Sourcing or consigned, so JLC places them. OPEN: choose consign / global sourcing vs hand-fit; LTR-390 lifecycle.
- [x] **B3 (H)** JGS1 Ø18 dome with Ø20.5 flange is custom — get a quote + drawing before freezing crown CAD.
  - **Status:** DONE: stock part — AliExpress "Various Sizes JGS1 UV Grade Fused Silica Window Quartz Glass Polished Disk" in 20 x 2 mm (~€6-10), uncoated (do not use 1064 nm AR-coated laser protective windows: the coating cuts UV-B). OPEN: check the delivered diameter (19.8-20.1) and thickness (1.8-2.2) on arrival.
- [x] **B4 (M)** PMSA003I needs a custom 6-pin ZH → 2×5 1.27 mm harness; transducers need JST-SH pigtails. Define both with drawings.
  - **Status:** DONE (docs): README section 4 harness table with pin-by-pin conductors for the crown cable, probe and power jumpers, PM harness, transducer and piezo pigtails.
- [ ] **B5 (M)** Budget: one JLC PCBA panel + hand-fit parts + prints — re-quote at order time.
  - **Status:** ESTIMATE (JLC price list Oct 2026 + supplier snapshot; re-quote at order time), 5 panels = 5 stations, Standard PCBA double-sided: parts ≈ $302 (minimum order quantities included), extended-part feeder loading 65 x $1.53 ≈ $99, setup $51.12 + stencil $16.42 + fixtures ≈ $16 + handling ≈ $15, joints (695 SMD + 42 THT per panel) ≈ $13 -> ≈ $510 assembly + parts (≈ $102 / station), + 4-layer ENIG 140.6 x 63.2 mm PCB fab (online quote). Hand / off-board parts per station ≈ $105-125: PMSA003I $40, 4x CUSA transducers ≈ $24, AS3935 ≈ $6-14, GUVB-C31SM ≈ $10.5, XIAO ESP32-C6 ≈ $5, dome ≈ $6-27, MA5532 ≈ $2, LTR-390 ≈ $1-2, cables / O-rings / fasteners / gland / gap filler ≈ $25; + MJF prints (8 plates, quote at JLC3DP).

## 8. Documentation consistency (single source = `hardware/product/spec.yaml`)

- [x] **D1** AGENTS.md: main 41×56 → 32×52; BMP581 on main → BMP585 on probe; SCT2400 → 2× SCT2430 on `power`; reflector 4×100 Ω → 4×27 Ω; 5 boards / 126×56.1 → 6 boards / 124.5×55.7.
  - **Status:** DONE (rewritten for Phase 2: 12 V heater rail, crown v2, 5-board panel + separate crown). Re-check at each release.
- [x] **D2** README (PARTIAL: Phase 2 hardware, panel and ordering text updated; re-check the mechanical claims below): bolts r = 23 vs 20.5; strut bore Ø6.4 vs Ø6.0; O-ring count 6 vs 5 in `orings.stl`; antenna cradle; waterproof button; "M12 standard nut compatible"; "Ø25–34 mm poles"; "5-Board Breakaway Panel".
  - **Status:** DONE: no antenna-cradle / waterproof-button / 5-board-panel claims left; O-ring count 5, mast clamp 6x M6 in 3 rows, strut bore Ø 5.8-6.0 mm, pagoda bolts M6 DIN 7984 at r 20.5 (build docstring), poles Ø 24-34 mm.
- [x] **D3** `assembly_parts.yaml`: dome retainer M22×1.0 vs M22×1.5; mast bolts M6×25 vs M6×35; transducer options.
  - **Status:** DONE: dome retainer M22x1.5 everywhere, M6x35 clamp bolts, transducer options (Ø 10 / Ø 14 mm) in the BOM.
- [x] **D4** `spec.yaml` stale comments/fields: M3/M4 fasteners, `terminals.power_in` (KF142R 2-pole), crown cable 160 mm.
  - **Status:** DONE: M6 clamp bolts, `terminals.power_in` = KF250-3.5-4P (4 poles incl. RS-485), crown cable 260 mm.
- [x] **D5** Circuit docstrings: "SHT45" vs SHT40-AD1F, "LIS2MDL" vs MMC5603NJ, "10-pin crown", "41×56 crown/reflector".
  - **Status:** DONE: SHT40-AD1F (shares the SHT45 DFN-4 footprint), MMC5603NJ, 12-pin crown cable, current board sizes; library symbol / footprint names kept as identifiers.

## 9. Test-suite gaps to close (so these cannot regress)

- [x] **T1** Fasteners modelled at real ISO sizes (M6 head Ø10×6, nut 10 AF×5.2, M12 nut 18 AF) against all parts and boards.
  - **Status:** DONE (Phase 1): DIN 7984 head + ISO 4032 nut + bolt tip in `test_boards_clear_enclosure_and_threads_truly_mesh`; printed M12 nut walls tested separately.
- [x] **T2** O-ring gland squeeze check at the locked bayonet position for every seal.
  - **Status:** DONE (Phase 1): `test_bayonet_o_rings_are_squeezed_15_to_40_percent`.
- [x] **T3** Swept-cable clearance test for every harness (diameter + bend radius).
  - **Status:** DONE: `test_crown_cable_and_probe_jumper_sweep_clear` (see M4).
- [x] **T4** Released STEP/STL body count + min inter-body gap ≥ 0.5 mm (or split into separate files).
  - **Status:** DONE: print plates with every body ≥ 6 mm apart, `test_every_print_body_is_exported_separately_and_printable`.
- [x] **T5** Min wall thickness check (louvers, nuts, shelves) ≥ process minimum.
  - **Status:** DONE: `test_printed_walls_are_at_least_the_process_minimum` (ray-cast median thickness of every planar / cylindrical / conical face on every print plate >= 0.75 mm). Fixed on the way: grille bars 0.4 -> 0.8 mm (base, crown_base), strut tongue / groove walls 0.48 -> 0.8 mm (mid tube r 5.65), louver inner knife edge trimmed, piezo locating rims 0.8 mm, probe-sleeve conduit / PCB-seat film wall and 0.54 mm tongue, M22 bore lead-in chamfer.
- [x] **T6** Electrical rule checks: comparator CMR, logic VIH/VIL across supply domains, part temperature ratings vs −40…+60 °C.
  - **Status:** DONE: `hardware/tests/test_electrical_rules.py`: every part rated to -40 C (JLC data, MLCC class, datasheet table) or justified in `ACCEPTED_COLD` (JST SH/ZH -25 C, B3U -25 C, TSL25911 -30 C, SCD41 heated, SGP41, XIAO and GUVB ratings to confirm); cross-domain logic levels and comparator / op-amp input ranges with >= 0.2 V margin.
