vbartusevicius/weather-station/hardware/releases/v1/enclosure/renders/base_floor.png

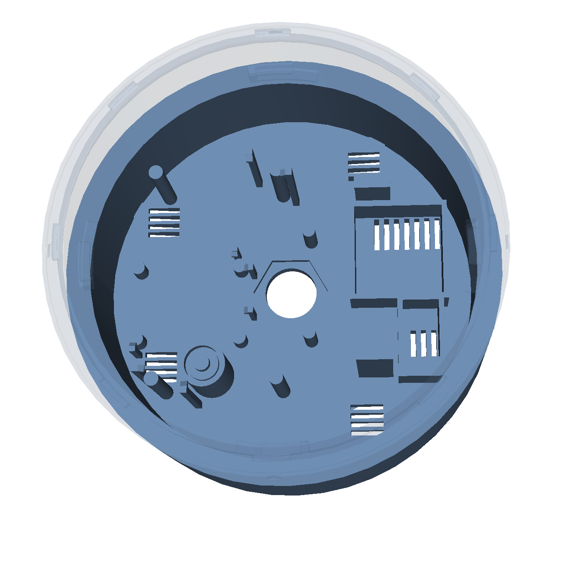
hardware/releases/v1/enclosure/renders/base_floor.png
