vbartusevicius/weather-station/hardware/releases/v1/enclosure/renders/base_underside.png

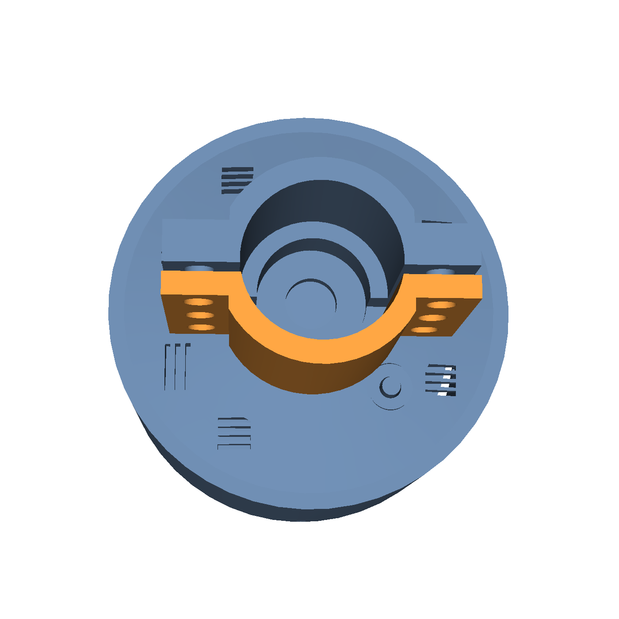
hardware/releases/v1/enclosure/renders/base_underside.png
