vbartusevicius/weather-station/hardware/releases/v1/enclosure/renders/crown_dome_cnc.png

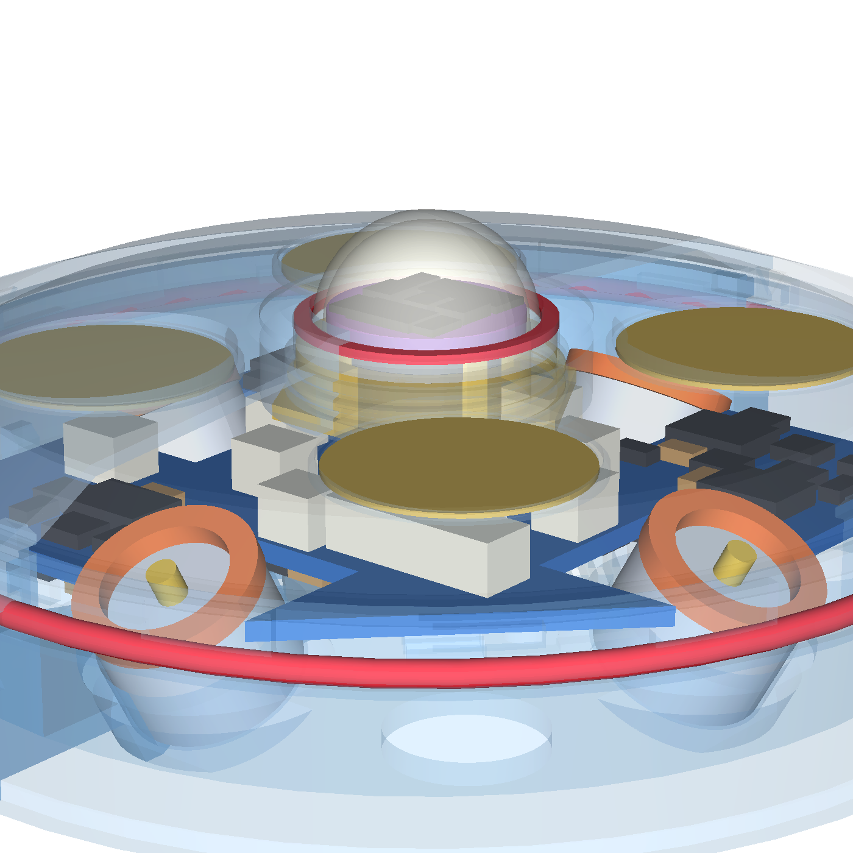
hardware/releases/v1/enclosure/renders/crown_dome_cnc.png
