vbartusevicius/weather-station/hardware/releases/v1/enclosure/renders/crown_window.png

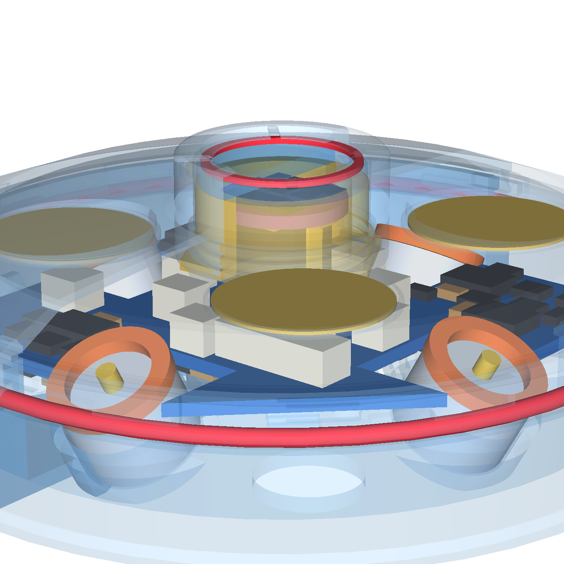
hardware/releases/v1/enclosure/renders/crown_window.png
