vbartusevicius/weather-station/hardware/releases/v1/order_lcsc.csv

LCSC Part Number | Quantity | Manufacturer Part Number | Value | Footprint | Designators
C1021612 | 5 | FS31X225K101EPG | 2u2 100V | C_1206_3216Metric | main:C1 power:C1 power:C10 power:C11 power:C2
C106243 | 2 | CC0805KKX7R0BB104 | 100n 100V | C_0805_2012Metric | power:C12 power:C3
C106809 | 1 | X49SM8MSD2SI | 8MHz | Crystal_SMD_HC49-SD | crown:Y1
C107112 | 1 | CC0805JRNPO9BN221 | 220p C0G 50V | C_0805_2012Metric | crown:C20
C107115 | 2 | CC0805JRNPO9BN330 | 33p C0G 50V | C_0805_2012Metric | crown:C11 crown:C12
C107120 | 2 | CC0805JRNPO9BN680 | 68p C0G 50V | C_0805_2012Metric | power:C18 power:C9
C107147 | 2 | CC0805KRX7R9BB223 | 22n 50V | C_0805_2012Metric | crown:C21 dome:C5
C107150 | 1 | CC0805KRX7R9BB333 | 33n 50V | C_0805_2012Metric | power:C8
C11350 | 1 | 74HC4052D,653 | 74HC4052D | TI_CD4052BM96_SOIC-16 | crown:U7
C113967 | 1 | SMAJ36A | SMAJ36A | D_SMA | main:D1
C12891 | 3 | CL31A226KAHNNNE | 22u 25V | C_1206_3216Metric | crown:C13 power:C14 power:C15
C149504 | 3 | 0805W8F1003T5E | 100k | R_0805_2012Metric | dome:R3 main:R1 main:R4
C152350 | 1 | Molex 1461530100 |  |  | off-board:2.4 GHz U.FL (IPEX-1) Flexible PCB Dipole Antenna (dual-band parts also fit; the ESP32-C6 uses 2.4 GHz only)
C160231 | 60 | JST SSH-003T-P0.2 |  |  | off-board:JST SH crimp contacts, 28-32 AWG (24 crown cable + 20 probe jumper + 16 pigtails)
C160379 | 1 | JST ZHR-6 |  |  | off-board:JST ZH 6-pin housing (PMSA003I harness, main J4 end)
C160388 | 9 | BM02B-SRSS-TB(LF)(SN) | AUX 12V_HEAT | JST_SH_BM02B-SRSS-TB_1x02-1MP_P1.00mm_Vertical | crown:J11 crown:J2 crown:J3 crown:J4 crown:J5 crown:J6 crown:J7 crown:J8 crown:J9
C160396 | 4 | BM10B-SRSS-TB(LF)(SN) | Probe board | JST_SH_BM10B-SRSS-TB_1x10-1MP_P1.00mm_Vertical | main:J3 main:J5 power:J1 probe:J1
C160398 | 2 | BM12B-SRSS-TB(LF)(SN) | Main board | JST_SH_BM12B-SRSS-TB_1x12-1MP_P1.00mm_Vertical | crown:J1 main:J2
C17024 | 7 | CL21A106KPFNNNE | 10u 10V | C_0805_2012Metric | crown:C2 crown:C34 crown:C7 main:C13 main:C4 power:C20 probe:C1
C17402 | 1 | 0805W8F1022T5E | 10k2 | R_0805_2012Metric | power:R4
C17414 | 17 | 0805W8F1002T5E | 10k | R_0805_2012Metric | crown:R18 crown:R19 crown:R25 crown:R26 crown:R28 crown:R29 dome:R4 main:R2 main:R21 main:R24 main:R25 main:R7 main:R8 power:R10 probe:R3 probe:R4 probe:R6
C17415 | 2 | 0805W8F100JT5E | 10R | R_0805_2012Metric | crown:R17 crown:R27
C17437 | 1 | 0805W8F1200T5E | 120R | R_0805_2012Metric | main:R26
C17450 | 2 | 0805W8F1303T5E | 130k | R_0805_2012Metric | power:R11 power:R5
C17460 | 1 | 0805W8F1403T5E | 140k | R_0805_2012Metric | power:R9
C17513 | 4 | 0805W8F1001T5E | 1k | R_0805_2012Metric | crown:R20 crown:R22 main:R18 main:R19
C17514 | 4 | 0805W8F1004T5E | 1M | R_0805_2012Metric | crown:R10 crown:R11 crown:R12 crown:R9
C17520 | 2 | 0805W8F2201T5E | 2k2 | R_0805_2012Metric | main:R5 main:R6
C17560 | 1 | 0805W8F2202T5E | 22k | R_0805_2012Metric | crown:R24
C17621 | 1 | 0805W8F3002T5E | 30k | R_0805_2012Metric | main:R20
C17630 | 5 | 0805W8F3300T5E | 330R | R_0805_2012Metric | crown:R1 crown:R2 crown:R3 crown:R4 main:R3
C17655 | 2 | 0805W8F3900T5E | 390R | R_0805_2012Metric | main:R10 main:R9
C17673 | 4 | 0805W8F4701T5E | 4k7 | R_0805_2012Metric | crown:R13 crown:R14 crown:R15 crown:R16
C17674 | 2 | 0805W8F4704T5E | 4M7 | R_0805_2012Metric | crown:R23 dome:R2
C17709 | 1 | 0805W8F4703T5E | 470k | R_0805_2012Metric | probe:R7
C17713 | 4 | 0805W8F4702T5E | 47k | R_0805_2012Metric | crown:R5 crown:R6 crown:R7 crown:R8
C17735 | 2 | 0805W8F5113T5E | 511k | R_0805_2012Metric | power:R1 power:R7
C17737 | 1 | 0805W8F5102T5E | 51k | R_0805_2012Metric | probe:R5
C17769 | 2 | 0805W8F6491T5E | 6k49 | R_0805_2012Metric | power:R12 power:R6
C17772 | 1 | 0805W8F6801T5E | 6k8 | R_0805_2012Metric | crown:R21
C18184976 | 1 | BMP585 | BMP585 | Bosch_BMP585_LGA-9 | probe:U5
C185857 | 4 | UCC27524ADR | UCC27524ADR | SOIC-8_3.9x4.9mm_P1.27mm | crown:U2 crown:U3 crown:U4 crown:U5
C2044314 | 1 | SRN6045TA-220M | 22uH | L_Sunlord_SWPA6045S | power:L2
C20917 | 2 | AO3400A | AO3400A | AOS_AO3400A_SOT-23 | main:Q1 probe:Q1
C21398 | 1 | 0805W8F5362T5E | 53k6 | R_0805_2012Metric | power:R3
C22459879 | 2 | TSL25911FN | TSL25911FN | AMS_TSL25911FN | dome:U2 dome_legacy:U2
C231329 | 1 | B3U-1000P | SERVICE | SW_SPST_B3U-1000P | main:SW1
C246754 | 8 | JST SHR-02V-S-B |  |  | off-board:JST SH 2-pin housing (4 transducer + 4 piezo pigtails)
C2480 | 1 | SS14 | SS14 | D_SMA | main:D5
C2481 | 2 | SS16 | SS16 | D_SMA | main:D2 main:D3
C25271 | 1 | 0805W8F100KT5E | 1R | R_0805_2012Metric | main:R17
C25334 | 1 | 1206W4F100LT5E | 0R1 | R_1206_3216Metric | main:R16
C263766 | 4 | JST SZH-003T-P0.5 |  |  | off-board:JST ZH crimp contacts, 28-32 AWG (PMSA003I harness, 30 AWG ribbon wires)
C265336 | 2 | JST SHR-12V-S-B(LF)(SN) |  |  | off-board:JST SH 12-pin housing (crown cable, both ends)
C276314 | 2 | RC0805FR-0782K5L | 82k5 | R_0805_2012Metric | power:R2 power:R8
C2778934 | 1 | HV05W8F1005T5E | 10M | R_0805_2012Metric | dome:R1
C28323 | 14 | CL21B105KBFNNNE | 1u 50V | C_0805_2012Metric | crown:C1 crown:C14 crown:C15 crown:C16 crown:C17 crown:C18 crown:C25 crown:C26 crown:C8 dome:C6 dome_legacy:C3 main:C19 main:C20 power:C19
C32677 | 1 | PSM712-LF-T7 | PSM712 | SOT-23 | main:D4
C37593 | 2 | ADS1115IDGSR | ADS1115IDGSR | TI_ADS1115_VSSOP-10 | dome:U3 main:U4
C394370 | 2 | JST SHR-10V-S-B |  |  | off-board:JST SH 10-pin housing (probe jumper, both ends)
C398355 | 1 | TLV9062IDR | TLV9062IDR | TI_TLV9062IDR_SOIC-8 | crown:U8
C398356 | 1 | TLV9062IDGKR | TLV9062IDGKR | TI_TLV9062_VSSOP-8 | dome:U1
C404329 | 1 | MMC5983MA | MMC5983MA | MEMSIC_MMC5983MA_LGA-16 | crown:U6
C41417361 | 3 | HX PZ2.54-1x4P TP-YQ | CROWN_RISER | HX_PZ2.54-1x4P-SMD | dome:J1 dome_legacy:J1 reflector:J1
C42379197 | 1 | HX PM2.54-1x4P TP-YQ | DOME_SOCKET | HX_PZ2.54-1x4P-SMD | crown:J10
C431633 | 1 | STM32G431RBT6 | STM32G431RBT6 | LQFP-64_10x10mm_P0.5mm | crown:U1
C44377 | 2 | TPS54360DDAR | TPS54360DDAR | TI_SO-PowerPAD-8_ThermalVias | power:U1 power:U2
C46061768 | 1 | HX PM2.54-1x4P WT | Reflector T-Socket SMD | HX_PM2.54-1x4P-RA-SMD | probe:J2
C471473 | 1 | B6B-ZR-SM4-TF(LF)(SN) | PMSA003I PM | JST_B6B-ZR-SM4-TF | main:J4
C475156 | 1 | KF250-3.5-4P-1 | 12-32V + RS485 | TerminalBlock_Kefa_KF250-3.5-4P | main:J1
C48533685 | 2 | FRP1206F6800TS | 680R | R_1206_3216Metric | probe:R1 probe:R2
C492374 | 1 | LTR-390UV-01 | LTR-390UV-01 | LiteOn_LTR-390UV-01 | dome_legacy:U1
C49247662 | 2 | HNTC0805-103F3950FB | 10k NTC | R_0805_2012Metric | probe:TH1 reflector:TH1
C49318488 | 1 | 2920L110/60V | 1.1A | Fuse_2920_7451Metric | main:F1
C49678 | 31 | CC0805KRX7R9BB104 | 100n 50V | C_0805_2012Metric | crown:C10 crown:C19 crown:C23 crown:C24 crown:C29 crown:C3 crown:C4 crown:C5 crown:C6 crown:C9 dome:C1 dome:C2 dome:C3 dome_legacy:C1 dome_legacy:C2 main:C21 main:C3 main:C5 main:C7 main:C8 main:C9 power:C13 power:C16 power:C4 power:C7 probe:C2 probe:C3 probe:C4 probe:C5 probe:C6 reflector:C1
C51118 | 1 | AP2112K-3.3TRG1 | AP2112K-3.3 | SOT-23-5 | power:U3
C520032 | 1 | CC0805JRX7R9BB183 | 18n 50V | C_0805_2012Metric | power:C17
C5446 | 1 | XC6206P332MR-G | XC6206P332MR | SOT-23 | crown:U10
C57474 | 1 | LM2903DR2G | LM2903DR2G | ON_LM393DR2G_SOIC-8 | probe:U4
C62771 | 2 | CC0805JRNPO9BN471 | 470p C0G 50V | C_0805_2012Metric | crown:C27 crown:C28
C7276687 | 4 | RC2512FK-7W120RL | 120R | R_2512_6332Metric | reflector:R1 reflector:R2 reflector:R3 reflector:R4
C7427168 | 1 | ANR6045T8R2M | 8.2uH | L_Sunlord_SWPA6045S | power:L1
C81174 | 9 | PMBD7000,215 | BAV99 | SOT-23 | crown:D1 crown:D2 crown:D3 crown:D4 crown:D5 crown:D6 crown:D7 crown:D8 crown:D9
C83170 | 5 | CC0805KRX7R9BB103 | 10n 50V | C_0805_2012Metric | crown:C30 crown:C31 crown:C32 crown:C33 dome:C4
C8963 | 1 | SP3485EN-L/TR | SP3485EN-L/TR | ON_LM393DR2G_SOIC-8 | main:U7
C94121 | 1 | CC0805KRX7R9BB102 | 1n 50V | C_0805_2012Metric | crown:C22
C94193 | 2 | B360A-13-F | B360A | D_SMA | power:D1 power:D2
C96123 | 2 | CL31A476MPHNNNE | 47u 10V | C_1206_3216Metric | power:C5 power:C6
C967633 | 1 | LSM6DS3TR-C | LSM6DS3TR-C | ST_LSM6DS3TR-C_LGA-14 | main:U5
