vbartusevicius/weather-station/hardware/releases/v1/assembly_parts.csv

Item | Qty | Category | Part | Description | Source
MCU module (hand-fitted into sockets) | 1 | electronics | Seeed Studio XIAO ESP32C6 Pre-Soldered (SKU 102010636) | ESP32-C6 module with pre-soldered 2x7 pin headers; plugs into two 5.0 mm female sockets (main U3) | Digi-Key 1597-102010636-ND (17 in stock, checked 2026-10-29) / Seeed Studio
XIAO sockets (hand-soldered) | 2 | electronics | Samtec CES-107-02-G-S (1x7 2.54 mm closed-entry low-profile socket, 5.08 mm tall, gold) | 1x7 female header, 2.54 mm, 5.0 mm tall, soldered into main U3; XIAO stays detachable | Mouser 200-CES10702GS (95 in stock, checked 2026-10-29)
UV-B photodiode (hand-reflowed) | 1 | electronics | Genicom GUVB-C21SD (COB2418 1.8 x 2.4 x 1.0 mm, pad 1 = anode) | AlGaN, 240-320 nm, 0.11 A/W at 300 nm Schottky photodiode, zero-bias into the TLV9062 transimpedance stage (dome D1); not stocked at LCSC / JLCPCB | Digi-Key 2096-GUVB-C21SDCT-ND (5863 in stock, checked 2026-10-29)
UV-A photodiode (hand-reflowed) | 1 | electronics | Genicom GUVA-C22SD (COB2418 1.8 x 2.4 x 1.0 mm, pad 1 = anode) | GaN, 240-370 nm, 0.14 A/W at 350 nm Schottky photodiode, zero-bias into the TLV9062 transimpedance stage (dome D2); not stocked at LCSC / JLCPCB | Digi-Key 2096-GUVA-C22SDCT-ND (2717 in stock, checked 2026-10-29)
Franklin Lightning Sensor IC (hand-reflowed) | 1 | electronics | ScioSense AS3935-BQFT (LCSC C3178344) | 4x4 mm MLPQ-16 lightning strike distance & energy detector (crown U9) | Digi-Key / Mouser / LCSC
AS3935 lightning antenna (hand-soldered) | 1 | electronics | Coilcraft MA5532-AED (100 uH +/-2 %, 11.7 x 3.5 mm open ferrite rod) or Premo SDTR1103-HF1-0100J (100 uH, 11.8 x 3.6 mm, same pads; then R26 = 6.8k) | ScioSense AS3935-AN04 recommended antenna (crown L1); tuned with 2x 470 pF C0G + the AS3935 internal 0..120 pF array | Coilcraft direct (coilcraft.com, MA5532-AEB cut tape / MA5532-AED reel: 1738 in stock, 1.18 EUR, checked 2026-10-30) / Mouser 994-MA5532-AE (restricted: not sold to the EU / LT region); not at Digi-Key or LCSC. alternative on the same pads: Premo SDTR1103-HF1-0100J (grupopremo.com; not at Digi-Key)
Waterproof 40 kHz Ultrasonic Transceivers (IP68) + 2-Pin JST-SH Pigtails | 4 | electronics | Same Sky CUSA-TR65-065-2200-TH68 (Ø 14 x 9 mm aluminium, IP68, transceiver, 40 kHz, 150 Vp-p, -40..+80 C, 2200 pF, beam 120 x 65 deg at -6 dB: mount all four with the same pin orientation so the narrow 65 deg axis lies the same way) straight in the Ø 14.6 mm barrels + 4x 2-pin JST-SH pigtails (pin 1 = A, pin 2 = B; driven differentially). Not suitable: PUI UTR-1440K-TT-R (IP65 only); 10 mm EU10AIF40H07T/R (split transmitter / receiver pair, no drive or temperature rating) | 4 inward-angled (29.0 deg V-beam) transceivers seated in the N/E/S/W covered barrels of crown_base.stl, locked from the back by the 4 slotted press-fit rings in transducer_adapters.stl, plugged into crown J2..J5 (BM02B-SRSS-TB, LCSC C160388). Drive is ~22 Vp-p H-bridge bursts from +12V_HEAT (15 % of the 150 Vp-p rating). All four must be the same type; re-run the still-air calibration (us_delay_us) after changing it | Digi-Key 2223-CUSA-TR65-065-2200-TH68-ND (350 in stock, checked 2026-10-29)
20 mm Piezoelectric Haptic Rain Discs (4-Quadrant Symmetric Array) | 4 | electronics | Same Sky CEB-20D64 (Ø 20 x 0.43 mm brass/ceramic piezo diaphragm, 6.5 kHz, 13 nF, wire leads; replaces the Murata 7BB-20-6L0, whose 7BB series Murata discontinued: last order 31 Mar 2026) | 4 discs bonded (brass face only, using thin rigid cyanoacrylate Loctite 401) to the 4 coplanar Ø 20.4 mm ceiling pockets of crown.stl (NE, NW, SW, SE at r=26.8 mm) and plugged into crown J6..J9 | Digi-Key 102-1126-ND / Farnell 4893404 (Same Sky)
Flanged PTFE dome diffuser (default UV / light cover, turned part) | 1 | utility | Turned virgin (unfilled, non-porous) white PTFE dome with a Ø 20.4 x 1.5 mm flange, flat on both faces, 0.8 mm wall, in one of two shapes: LATHE version (default: Ø 17.8 mm cylinder, flat top, 2 mm edge radius, 7.5 mm tall; plain turning + boring from Ø 22-25 mm rod; enclosure/ptfe_dome_lathe.step + drawings/ptfe_dome_lathe.svg) or CNC version (Ø 17.8 mm hemisphere on the flange; enclosure/ptfe_dome_cnc.step + drawings/ptfe_dome_cnc.svg). No stock part: order from PCBWay CNC turning (material PTFE, white), an AliExpress custom-PTFE turning shop, or a lathe | Default cover over the dome board sensors in the `crown` top: low flush collar (lid trimmed 1.0 mm under the sensor tops), so the sensors see the sky down to slightly below the horizon. An 18 x 1.0 mm O-ring is squeezed 25 % flat between the flange top and the collar lip; the printed M22x1.5 dome nut (struts.stl) pushes the flat flange bottom, hand-tight. ~10-12 % diffuse transmission, spectrally flat 250-2500 nm (UV-B passes like visible light): firmware optics_transmission 0.11, calibrate per CALIBRATION.md step 8. Keep the PTFE white and matte: it is a diffuser, not a window (PTFE cannot be made transparent; polishing only changes the surface). Re-tighten the nut after the first week (PTFE creep) | PCBWay CNC (PTFE) / AliExpress custom turning / local lathe (~$2-10 per part)
JGS1 Fused Silica UV Window Ø 20 x 2 mm (uncoated, backup cover) | 0 | utility | Stock JGS1 UV-grade fused-silica round window Ø 20 x 2 mm, both faces polished, uncoated (AliExpress "Various Sizes JGS1 UV Grade Fused Silica Window Quartz Glass Polished Disk", 20 x 2 mm; a fiber-laser protective window 20x2 only if it is uncoated - 1064 nm AR coatings cut UV-B). See enclosure/drawings/jgs1_window.svg | Backup cover for the `crown_window` top (same print plate as `crown`): fitted from below, a thin 17 x 1.0 mm O-ring between its top face and the 1.2 mm lid lip (seal lid <-> glass), pushed up hand-tight by the printed window nut (struts.stl). Fits diameter 19.8-20.1 mm, thickness 1.8-2.2 mm. More signal than PTFE (optics_transmission ~0.92) but the lip hides the sky below ~19-34 deg solar elevation | AliExpress / Taobao (JGS1 UV fused silica window 20 x 2 mm, ~$6-10)
Particulate Matter Sensor Module (PM1.0/2.5/10) | 1 | electronics | Plantower PMSA003I (I2C 0x12, 38.0x35.0x11.8 mm, inlet and fan exhaust on the same face, e.g. Adafruit 4505) | Lies face-down on the left half of the base.stl bay beside main, openings edge outward (fan toward the rear): the inlet/fan face seals onto two duct chambers whose floor slits draw and exhaust outside air only; held by two snap hooks | Mouser 485-4505 (Adafruit 4505 = bare Plantower PMSA003I; 4 in stock, checked 2026-10-29; the 4632 breakout does not fit the duct bed)
PMSA003I harness + duct gasket | 1 | electronics | Samtec FFSD-05-D-05.91-01-N (2x5 1.27 mm Tiger Eye IDC ribbon, 150 mm, 30 AWG; cut off one end) + JST ZHR-6 at the main J4 end; 1.5 mm closed-cell EPDM foam strip (1.2 mm wide, on the duct chamber wall tops) | Harness: keep the IDC socket on the module, cut the other end and crimp four ribbon wires into the ZHR-6 (JST SZH-003T-P0.5, 28-32 AWG): J4 pin 1 +5V -> wire 1 (VCC), pin 2 GND -> wire 3 (GND), pin 3 SDA -> wire 9, pin 4 SCL -> wire 7; cut wires 2, 4, 5, 6, 8, 10 back (module pins 1/2 and 3/4 are the same supply pins; 5/10 RESET/SET and 6/8 stay open: internal pull-ups) | Mouser 200-FFSD05D059101N (127 in stock, checked 2026-10-29) / LCSC (ZHR-6, crimps) / foam: local hardware
Crown cable (12-pin JST-SH) + probe jumper (10-pin JST-SH) | 2 | utility | 260 mm 12-conductor 30 AWG cable, OD <= 3.2 mm (or 12 loose 30 AWG wires with insulation OD <= 0.6 mm, UL10064 / UL1571, in a thin PTFE sleeve; common pre-crimped 28 AWG SH leads are 0.8-1.0 mm OD and bundle to ~4 mm, which does NOT fit), SHR-12V-S-B plug on both ends wired pin 1 <-> pin 1 (main J2 <-> crown J1, ~202 mm routed path + service loop) + 60 mm 10-wire SHR-10V-S-B jumper, pin 1 <-> pin 1 (main J3 <-> probe J1). Crimping the crown end after threading needs SSH-003T-P0.2 contacts and an SH-capable crimper (JST WC-240, or an Engineer PA-09 / IWISS SN-01BM class tool) | main J2 and crown J1 are 12-pin BM12B-SRSS-TB. The crown cable passes the 13x11 mm umbrella cutout, the 4.1 mm deep rear conduit of probe_sleeve_back (tested with a Ø 3.2 mm cable on a 10 mm bend radius; a Ø 4.2 mm cable does NOT fit) and the 45-deg NE split-C strut; crimp one end after threading it through the strut nut | Digi-Key / Mouser / LCSC / AliExpress
JST SH 12-pin housing (crown cable, both ends) | 2 | electronics | JST SHR-12V-S-B(LF)(SN) (LCSC C265336) | Connector parts for the harnesses above (crimp with an SH / ZH-capable tool) | LCSC
JST SH 10-pin housing (probe jumper, both ends) | 2 | electronics | JST SHR-10V-S-B (LCSC C394370) | Connector parts for the harnesses above (crimp with an SH / ZH-capable tool) | LCSC
JST SH 2-pin housing (4 transducer + 4 piezo pigtails) | 8 | electronics | JST SHR-02V-S-B (LCSC C246754) | Connector parts for the harnesses above (crimp with an SH / ZH-capable tool) | LCSC
JST SH crimp contacts, 28-32 AWG (24 crown cable + 20 probe jumper + 16 pigtails) | 60 | electronics | JST SSH-003T-P0.2 (LCSC C160231) | Connector parts for the harnesses above (crimp with an SH / ZH-capable tool) | LCSC
JST ZH 6-pin housing (PMSA003I harness, main J4 end) | 1 | electronics | JST ZHR-6 (LCSC C160379) | Connector parts for the harnesses above (crimp with an SH / ZH-capable tool) | LCSC
JST ZH crimp contacts, 28-32 AWG (PMSA003I harness, 30 AWG ribbon wires) | 4 | electronics | JST SZH-003T-P0.5 (LCSC C263766) | Connector parts for the harnesses above (crimp with an SH / ZH-capable tool) | LCSC
Stainless Steel M6 Fastener Set (Pagoda Through-Bolts & Mast Clamp Bolts) | 1 | utility | 4x M6x55 DIN 7984 LOW-HEAD socket cap screws (head 10 x 3.5 mm; a standard ISO 4762 head hits the reflector board) + 4x ISO 4032 M6 nuts (pagoda stack) + 6x M6x35 hex bolts + 12x M6 washers (ISO 7089, Ø 12 mm: the 3 bolt rows are only 13 mm apart) + 6x M6 locknuts (40 mm tall mast clamp, 31 mm pole engagement) | A4-70 / 316 stainless steel fasteners clamping the 5-plate pagoda stack (through the Ø 6.2 mm column bores) and clamping the mast saddle: direct grip on Ø 32-34 mm poles, Ø 24-32 mm poles with the printed mast_shims (4 sizes, 31 mm tall) | Local hardware / McMaster-Carr / Mouser
Elastomeric O-Ring Seal Set (5 Rings) | 1 | utility | 3x 88 x 2.0 mm EPDM/NBR 70A O-rings (base<->pagoda, pagoda<->wind_tunnel, crown_base<->crown: glands sized for 2.0 mm, a 1.5 mm ring does not seal) + 1x 21 x 1.5 mm O-ring (probe_sleeve bottom) + 1x 18 x 1.0 mm O-ring (PTFE dome flange, default crown top) or 1x 17 x 1.0 mm O-ring (UV window, backup crown_window top) | Standard metric EPDM/nitrile O-rings (or 3D-printed in TPU 95A from orings.stl) sealing all 3 bayonet joints, the bottom pagoda bulkhead, and the UV cover (PTFE dome flange or JGS1 window) | Local hardware / McMaster-Carr / TPU 95A print
Silicone-free thermal gap filler (reflector heater -> wind_tunnel deck) | 1 | utility | Silicone-free (acrylic / non-silicone) thermal gap putty or 0.25-0.5 mm soft thermal pad, >= 1 W/mK, 24 x 24 mm | Fills the nominal 0.08 mm (stack-up +/-0.3 mm) gap between the 4 reflector heater resistors and the underside of the wind_tunnel deck so the de-icing heat reaches the cone regardless of print tolerance. Must be silicone-free: siloxane vapour permanently poisons the SGP41 gas sensor | Mouser / Digi-Key / Farnell (non-silicone gap filler)
IP68 Waterproof Compression Cable Gland (M12x1.5 / PG7) | 1 | utility | LAPP SKINTOP SLR-M 12x1.5 BK with locknut (S2607; IP68, cable Ø 3.5-7 mm, black) | Mounts in the single center Ø 12.2 mm bulkhead hole of base.stl (locknut seats in the 15.4 mm internal hex recess; knurled compression dome sits inside the Ø 26 mm protected upper mast chamber above the pole stop). The dome nut reaches below the pole stop into the mast: the mast must be a hollow tube with >= 18 mm inside diameter (e.g. 33.7 x 3.2 mm steel pipe, ID 27.3 mm) and the supply / RS-485 cable runs down inside it | Mouser 58-S2607 (100 in stock, checked 2026-10-29)
2.4 GHz U.FL (IPEX-1) Flexible PCB Dipole Antenna (dual-band parts also fit; the ESP32-C6 uses 2.4 GHz only) | 1 | electronics | Molex 1461530100 (LCSC C152350; 2.4 / 5 GHz flexible dipole, 100 mm U.FL coax; alternative Taoglas FXP830) | Plugs into XIAO ESP32-C6 U.FL jack (activated via GPIO3=LOW, GPIO14=HIGH); stick it (its own adhesive) horizontally on the inner bay wall above the umbrella, away from the main board (V1 has no printed cradle) | Mouser / Digi-Key / LCSC
3D-printed roof enclosure parts (13 parts on 8 print plates) | 8 | printed | enclosure/print/<plate>.stl: base, orings, pagoda, wind_tunnel, probe_sleeve (front + back), mast_clamp (+ mast_shims), struts (+ transducer_adapters), crown (+ crown_window + crown_base) — assembled-position references in enclosure/{base,mast_clamp,orings,probe_sleeve_back,probe_sleeve_front,pagoda,wind_tunnel,struts,crown_base,crown,crown_window,mast_shims,transducer_adapters}.stl | Order/print the 8 enclosure/print/<plate>.stl files: all bodies laid out >= 6 mm apart, so captive and stacked bodies (umbrella, reset button, louver plates, strut halves, nuts, shims) are never printed fused. MJF PA12 or UV-stabilised ASA (TPU 95A only if printing orings); clamped to the mast with 6x M6x35 bolts | printed
Non-siloxane polyurethane conformal coating & potting resin | 1 | utility | Electrolube URC / Humiseal 1A33 polyurethane coating (-65..+130 C) + 2-part polyurethane resin | Mask the silkscreened NO-COAT sensor windows (SHT40, SCD41, SGP41, BMP585, dome optics) with Kapton tape; coat both sides of main/crown/probe and pot the probe J1 connector cofferdam cup (NEVER use RTV silicone near the SGP41: its vapours poison the MOx gas sensor) | Mouser / Digi-Key / TME
