vbartusevicius/weather-station/hardware/releases/v1/order_elsewhere.csv

Item | Quantity | Part | Mouser | Digi-Key | TME | Other sources
MCU module (hand-fitted into sockets) | 1 | Seeed Studio XIAO ESP32C6 Pre-Soldered (SKU 102010636) |  | 1597-102010636-ND |  | Digi-Key 1597-102010636-ND (17 in stock, checked 2026-10-29) / Seeed Studio
XIAO sockets (hand-soldered) | 2 | Samtec CES-107-02-G-S (1x7 2.54 mm closed-entry low-profile socket, 5.08 mm tall, gold) | 200-CES10702GS |  |  | Mouser 200-CES10702GS (95 in stock, checked 2026-10-29)
UV-B photodiode (hand-reflowed) | 1 | Genicom GUVB-C21SD (COB2418 1.8 x 2.4 x 1.0 mm, pad 1 = anode) |  | 2096-GUVB-C21SDCT-ND |  | Digi-Key 2096-GUVB-C21SDCT-ND (5863 in stock, checked 2026-10-29)
UV-A photodiode (hand-reflowed) | 1 | Genicom GUVA-C22SD (COB2418 1.8 x 2.4 x 1.0 mm, pad 1 = anode) |  | 2096-GUVA-C22SDCT-ND |  | Digi-Key 2096-GUVA-C22SDCT-ND (2717 in stock, checked 2026-10-29)
AS3935 lightning antenna (hand-soldered) | 1 | Coilcraft MA5532-AED (100 uH +/-2 %, 11.7 x 3.5 mm open ferrite rod) or Premo SDTR1103-HF1-0100J (100 uH, 11.8 x 3.6 mm, same pads; then R26 = 6.8k) | 994-MA5532-AE |  |  | Coilcraft direct (coilcraft.com, MA5532-AEB cut tape / MA5532-AED reel: 1738 in stock, 1.18 EUR, checked 2026-10-30) / Mouser 994-MA5532-AE (restricted: not sold to the EU / LT region); not at Digi-Key or LCSC. alternative on the same pads: Premo SDTR1103-HF1-0100J (grupopremo.com; not at Digi-Key)
Waterproof 40 kHz Ultrasonic Transceivers (IP68) + 2-Pin JST-SH Pigtails | 4 | Same Sky CUSA-TR65-065-2200-TH68 (Ø 14 x 9 mm aluminium, IP68, transceiver, 40 kHz, 150 Vp-p, -40..+80 C, 2200 pF, beam 120 x 65 deg at -6 dB: mount all four with the same pin orientation so the narrow 65 deg axis lies the same way) straight in the Ø 14.6 mm barrels + 4x 2-pin JST-SH pigtails (pin 1 = A, pin 2 = B; driven differentially). Not suitable: PUI UTR-1440K-TT-R (IP65 only); 10 mm EU10AIF40H07T/R (split transmitter / receiver pair, no drive or temperature rating) |  | 2223-CUSA-TR65-065-2200-TH68-ND |  | Digi-Key 2223-CUSA-TR65-065-2200-TH68-ND (350 in stock, checked 2026-10-29)
20 mm Piezoelectric Haptic Rain Discs (4-Quadrant Symmetric Array) | 4 | Same Sky CEB-20D64 (Ø 20 x 0.43 mm brass/ceramic piezo diaphragm, 6.5 kHz, 13 nF, wire leads; replaces the Murata 7BB-20-6L0, whose 7BB series Murata discontinued: last order 31 Mar 2026) |  | 102-1126-ND |  | Digi-Key 102-1126-ND / Farnell 4893404 (Same Sky)
Particulate Matter Sensor Module (PM1.0/2.5/10) | 1 | Plantower PMSA003I (I2C 0x12, 38.0x35.0x11.8 mm, inlet and fan exhaust on the same face, e.g. Adafruit 4505) | 485-4505 |  |  | Mouser 485-4505 (Adafruit 4505 = bare Plantower PMSA003I; 4 in stock, checked 2026-10-29; the 4632 breakout does not fit the duct bed)
PMSA003I harness + duct gasket | 1 | Samtec FFSD-05-D-05.91-01-N (2x5 1.27 mm Tiger Eye IDC ribbon, 150 mm, 30 AWG; cut off one end) + JST ZHR-6 at the main J4 end; 1.5 mm closed-cell EPDM foam strip (1.2 mm wide, on the duct chamber wall tops) | 200-FFSD05D059101N |  |  | Mouser 200-FFSD05D059101N (127 in stock, checked 2026-10-29) / LCSC (ZHR-6, crimps) / foam: local hardware
dome_legacy:U3 UV-B digital sensor (I2C 0x39) (legacy board only) | 1 | Genicom GUVB-C31SM | 932-MIKROE-4145 |  |  | Genicom GUVB-C31SM is obsolete (Digi-Key: not available): MikroE UVB Click carries it, desolder it (Mouser 932-MIKROE-4145, 3 in stock, checked 2026-10-30) / brokers
off-board:Franklin Lightning Sensor IC (hand-reflowed) | 1 | ScioSense AS3935-BQFT |  | AS3935-BQFTCT-ND |  | Digi-Key (product 3182213, ~1200 in stock, checked 2026-10-29)
probe:U1 | 1 | Sensirion SCD41-D-R1 (the same sensor on a 60-piece reel; Sensirion product number 3.000.960) |  |  | SCD41-D-R1 | TME SCD41-D-R1 (79 in stock) / Farnell 3677906 (58) / RS 2151860 (42)
probe:U2 | 1 | Sensirion SGP41-D-R4 |  |  | SGP41-D-R4 | TME SGP41-D-R4 (21 in stock) / Rutronik ICENVI1397 (75, Germany)
probe:U3 | 1 | Sensirion SHT40-AD1F-R2 |  |  |  | Farnell 4134535 (6917 in stock)
