vbartusevicius/weather-station/hardware/releases/v1/dome/dome_bom.csv

Line | Qty | Designators | Value | Package | Type | Manufacturer | MPN | LCSC | Assembly
1 | 3 | C1,C2,C3 | 100n 50V | C_0805_2012Metric | SMD | YAGEO | CC0805KRX7R9BB104 | C49678 | machine
2 | 1 | C4 | 10n 50V | C_0805_2012Metric | SMD | YAGEO | CC0805KRX7R9BB103 | C83170 | machine
3 | 1 | C5 | 22n 50V | C_0805_2012Metric | SMD | YAGEO | CC0805KRX7R9BB223 | C107147 | machine
4 | 1 | C6 | 1u 50V | C_0805_2012Metric | SMD | Samsung | CL21B105KBFNNNE | C28323 | machine
5 | 1 | D1 | GUVB-C21SD | Genicom_COB2418 | SMD | Genicom | GUVB-C21SD |  | hand-fit (not stocked by JLCPCB)
6 | 1 | D2 | GUVA-C22SD | Genicom_COB2418 | SMD | Genicom | GUVA-C22SD |  | hand-fit (not stocked by JLCPCB)
7 | 1 | J1 | CROWN_RISER | HX_PZ2.54-1x4P-SMD | SMD | HCTL | HX PZ2.54-1x4P TP-YQ | C41417361 | machine
8 | 1 | R1 | 10M | R_0805_2012Metric | SMD | UNI-ROYAL | 0805W8F1005T5E | C26108 | machine
9 | 1 | R2 | 4M7 | R_0805_2012Metric | SMD | UNI-ROYAL | 0805W8F4704T5E | C17674 | machine
10 | 1 | R3 | 100k | R_0805_2012Metric | SMD | UNI-ROYAL | 0805W8F1003T5E | C149504 | machine
11 | 1 | R4 | 10k | R_0805_2012Metric | SMD | UNI-ROYAL | 0805W8F1002T5E | C17414 | machine
12 | 1 | U1 | TLV9062IDGKR | TI_TLV9062_VSSOP-8 | SMD | Texas Instruments | TLV9062IDGKR | C398356 | machine
13 | 1 | U2 | TSL25911FN | AMS_TSL25911FN | SMD | ams OSRAM | TSL25911FN | C176812 | machine
14 | 1 | U3 | ADS1115IDGSR | TI_ADS1115_VSSOP-10 | SMD | Texas Instruments | ADS1115IDGSR | C37593 | machine
