vbartusevicius/weather-station/hardware/releases/v1/probe/probe_bom.csv

Line | Qty | Designators | Value | Package | Type | Manufacturer | MPN | LCSC | Assembly
1 | 1 | C1 | 10u 10V | C_0805_2012Metric | SMD | Samsung | CL21A106KPFNNNE | C17024 | machine
2 | 5 | C2,C3,C4,C5,C6 | 100n 50V | C_0805_2012Metric | SMD | YAGEO | CC0805KRX7R9BB104 | C49678 | machine
3 | 1 | J1 | Main board | JST_SH_BM10B-SRSS-TB_1x10-1MP_P1.00mm_Vertical | SMD | JST | BM10B-SRSS-TB(LF)(SN) | C160396 | machine
4 | 1 | J2 | Reflector T-Socket SMD | HX_PM2.54-1x4P-RA-SMD | SMD | HANBO | HX PM2.54-1x4P WT | C46061768 | machine
5 | 1 | Q1 | AO3400A | AOS_AO3400A_SOT-23 | SMD | Alpha & Omega Semicon | AO3400A | C20917 | machine
6 | 2 | R1,R2 | 680R | R_1206_3216Metric | SMD | FOJAN | FRP1206F6800TS | C48533685 | machine
7 | 3 | R3,R4,R6 | 10k | R_0805_2012Metric | SMD | UNI-ROYAL | 0805W8F1002T5E | C17414 | machine
8 | 1 | R5 | 51k | R_0805_2012Metric | SMD | UNI-ROYAL | 0805W8F5102T5E | C17737 | machine
9 | 1 | R7 | 470k | R_0805_2012Metric | SMD | UNI-ROYAL | 0805W8F4703T5E | C17709 | machine
10 | 1 | TH1 | 10k NTC | R_0805_2012Metric | SMD | R+O | HNTC0805-103F3950FB | C49247662 | machine
11 | 1 | U1 | SCD41-D-R2 | Sensirion_SCD41_LGA-20 | SMD | Sensirion | SCD41-D-R2 | C3659294 | machine
12 | 1 | U2 | SGP41-D-R4 | Sensirion_SGP41_DFN-6 | SMD | Sensirion | SGP41-D-R4 | C3659325 | machine
13 | 1 | U3 | SHT40-AD1F-R2 | Sensirion_SHT45_DFN-4 | SMD | Sensirion | SHT40-AD1F-R2 | C7461846 | machine
14 | 1 | U4 | LM2903DR2G | ON_LM393DR2G_SOIC-8 | SMD | onsemi | LM2903DR2G | C57474 | machine
15 | 1 | U5 | BMP585 | Bosch_BMP585_LGA-9 | SMD | Bosch Sensortec | BMP585 | C18184976 | machine
