vbartusevicius/weather-station/hardware/releases/v1/reflector/reflector_bom.csv

Line | Qty | Designators | Value | Package | Type | Manufacturer | MPN | LCSC | Assembly
1 | 1 | C1 | 100n 50V | C_0805_2012Metric | SMD | YAGEO | CC0805KRX7R9BB104 | C49678 | machine
2 | 1 | J1 | Probe T-Header SMD | HX_PZ2.54-1x4P-SMD | SMD | HANBO | HX PZ2.54-1x4P TP-YQ | C41417361 | machine
3 | 4 | R1,R2,R3,R4 | 120R | R_2512_6332Metric | SMD | YAGEO | RC2512FK-7W120RL | C7276687 | machine
4 | 1 | TH1 | 10k NTC | R_0805_2012Metric | SMD | R+O | HNTC0805-103F3950FB | C49247662 | machine
