vbartusevicius/weather-station/hardware/releases/v1/reflector/reflector_bom_jlc.csv

Comment | Designator | Footprint | LCSC Part #
100n 50V | C1 | C_0805_2012Metric | C49678
10k NTC | TH1 | R_0805_2012Metric | C49247662
120R | R1,R2,R3,R4 | R_2512_6332Metric | C7276687
Probe T-Header SMD | J1 | HX_PZ2.54-1x4P-SMD | C41417361
