vbartusevicius/weather-station/hardware/releases/v1/main/main.step

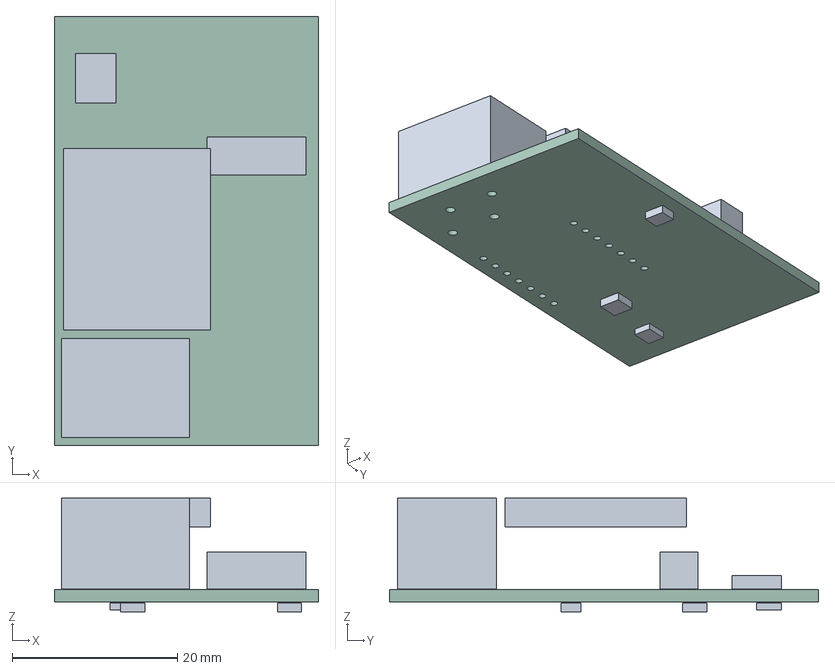
[picture p24: CAD file, 2026-11-11]
hardware/releases/v1/main/main.step
32.0 x 52.0 x 13.8 mm
main_PCB
