vbartusevicius/weather-station/hardware/releases/v1/enclosure/assembly.step

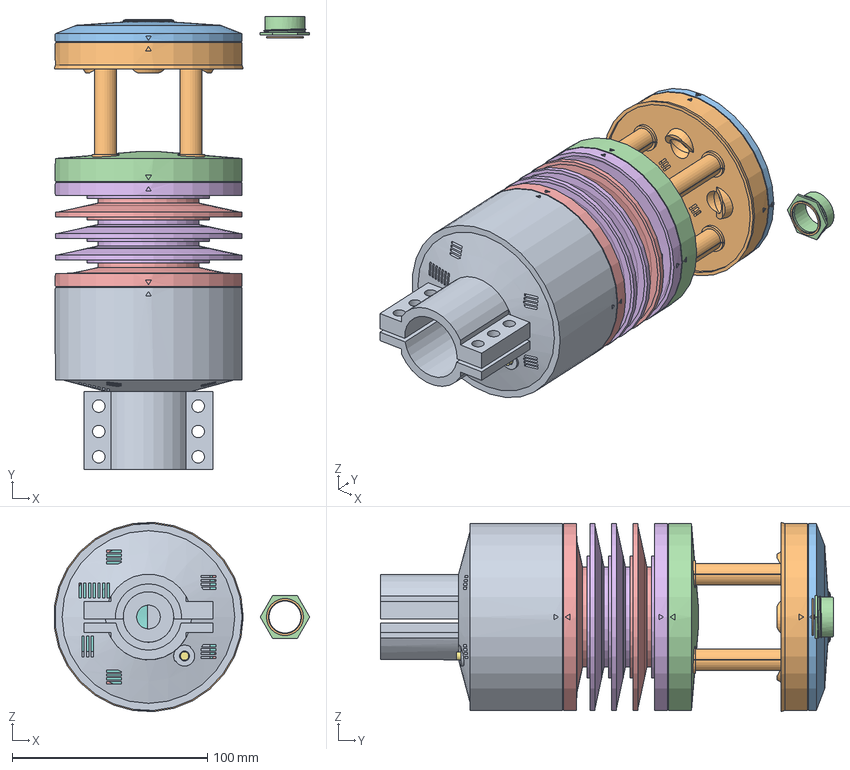
[picture p25: CAD file, 2026-11-11]
hardware/releases/v1/enclosure/assembly.step
131.0 x 232.3 x 97.1 mm
