vbartusevicius/weather-station/hardware/releases/v1/crown/crown.step

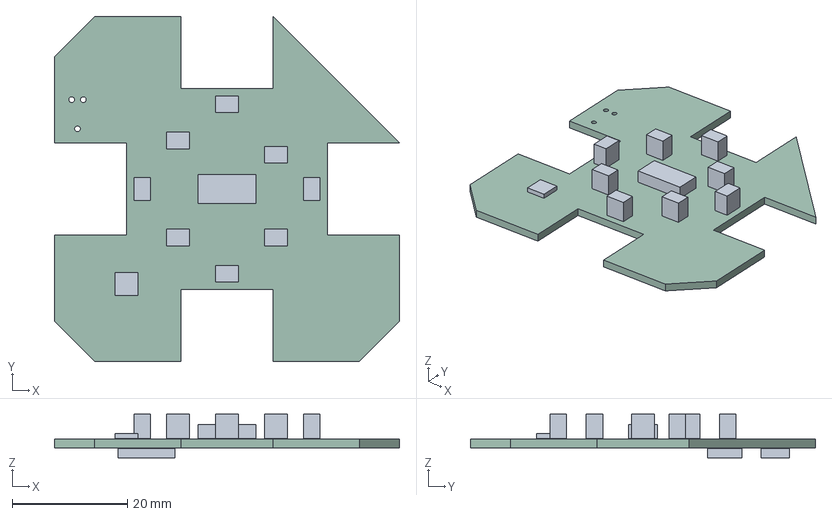
[picture p26: CAD file, 2026-11-11]
hardware/releases/v1/crown/crown.step
60.0 x 60.0 x 7.58 mm
crown_PCB
