vbartusevicius/weather-station/hardware/releases/v1/dome/dome.step

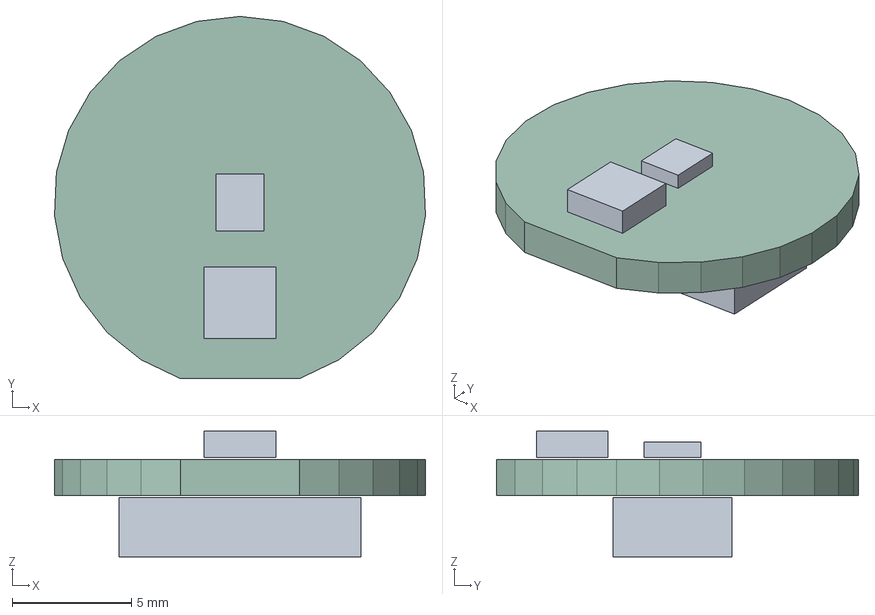
[picture p27: CAD file, 2026-11-11]
hardware/releases/v1/dome/dome.step
15.6 x 15.2 x 5.28 mm
dome_PCB
