vbartusevicius/weather-station/hardware/releases/v1/enclosure/mast_clamp.step

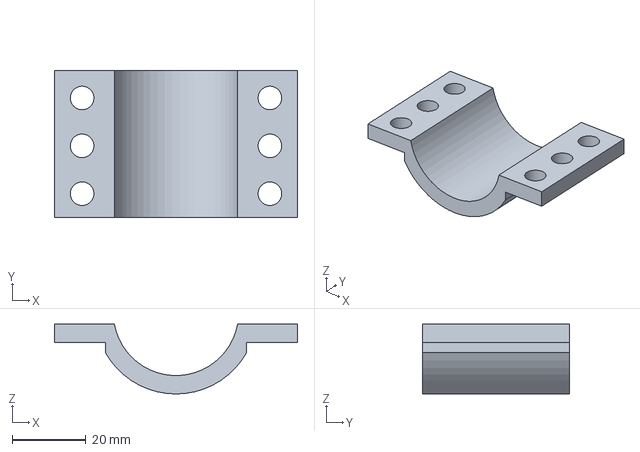
[picture p28: CAD file, 2026-11-11]
hardware/releases/v1/enclosure/mast_clamp.step
66.0 x 40.0 x 19.0 mm
