vbartusevicius/weather-station/hardware/releases/v1/enclosure/print/probe_sleeve.stl

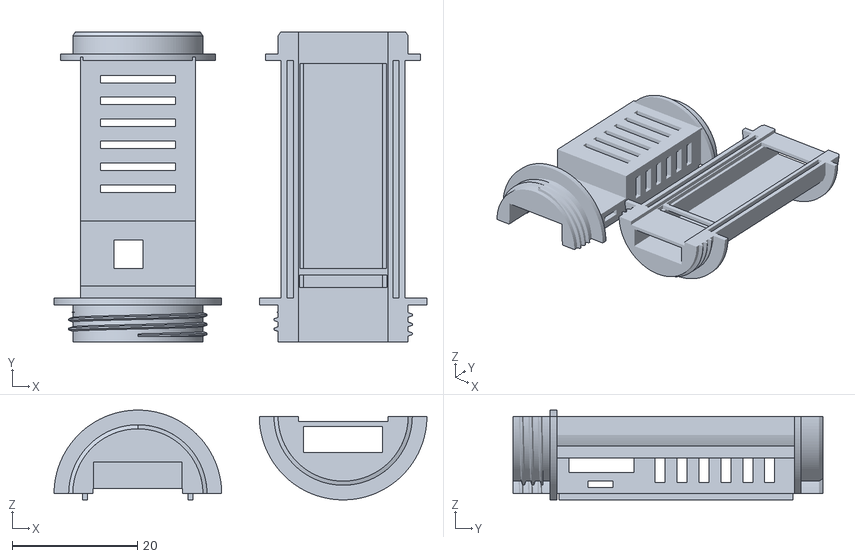
[picture p29: CAD file, 2026-10-23]
hardware/releases/v1/enclosure/print/probe_sleeve.stl
59.6 x 49.5 x 14.3
