vbartusevicius/weather-station/hardware/releases/v1/power/power.step

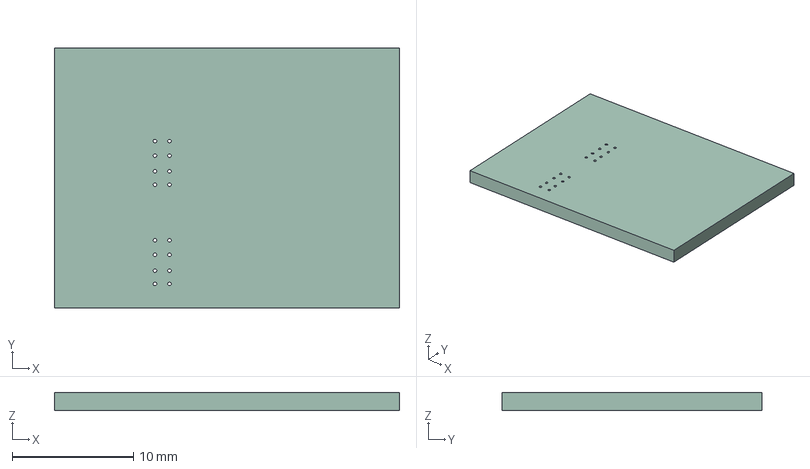
[picture p30: CAD file, 2026-11-11]
hardware/releases/v1/power/power.step
28.5 x 21.5 x 1.51 mm
