vbartusevicius/weather-station/hardware/releases/v1/probe/probe.step

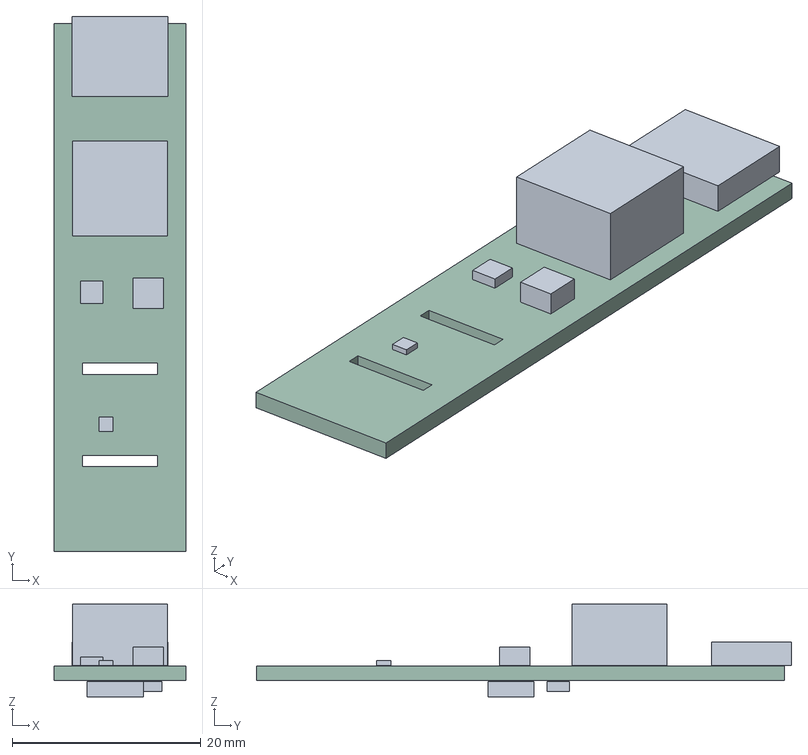
[picture p31: CAD file, 2026-11-11]
hardware/releases/v1/probe/probe.step
14.0 x 56.8 x 9.83 mm
probe_PCB
