vbartusevicius/weather-station/hardware/releases/v1/reflector/reflector.step

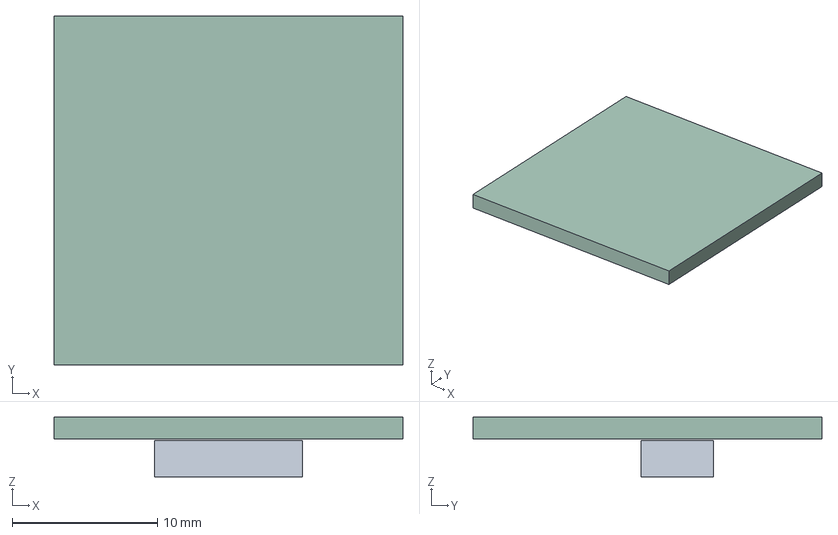
[picture p32: CAD file, 2026-11-11]
hardware/releases/v1/reflector/reflector.step
24.0 x 24.0 x 4.10 mm
reflector_PCB
