vbartusevicius/weather-station/hardware/releases/v1/enclosure/crown_window.step

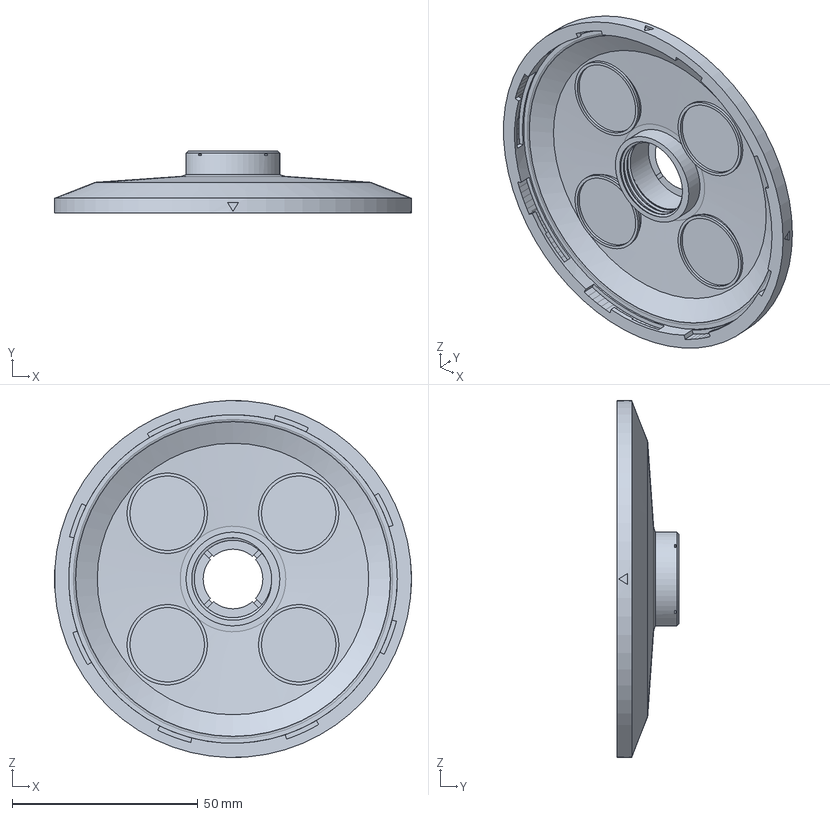
[picture p33: CAD file, 2026-11-11]
hardware/releases/v1/enclosure/crown_window.step
96.0 x 16.8 x 96.0 mm
