vbartusevicius/weather-station/hardware/releases/v1/enclosure/struts.step

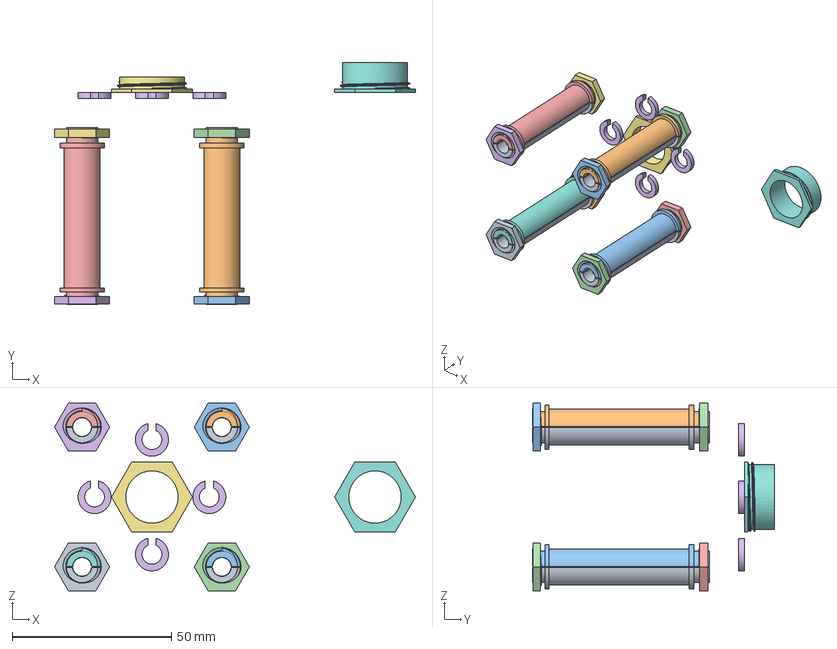
[picture p34: CAD file, 2026-11-11]
hardware/releases/v1/enclosure/struts.step
113.3 x 76.0 x 58.8 mm
