vbartusevicius/weather-station/hardware/releases/v1/enclosure/wind_tunnel.step

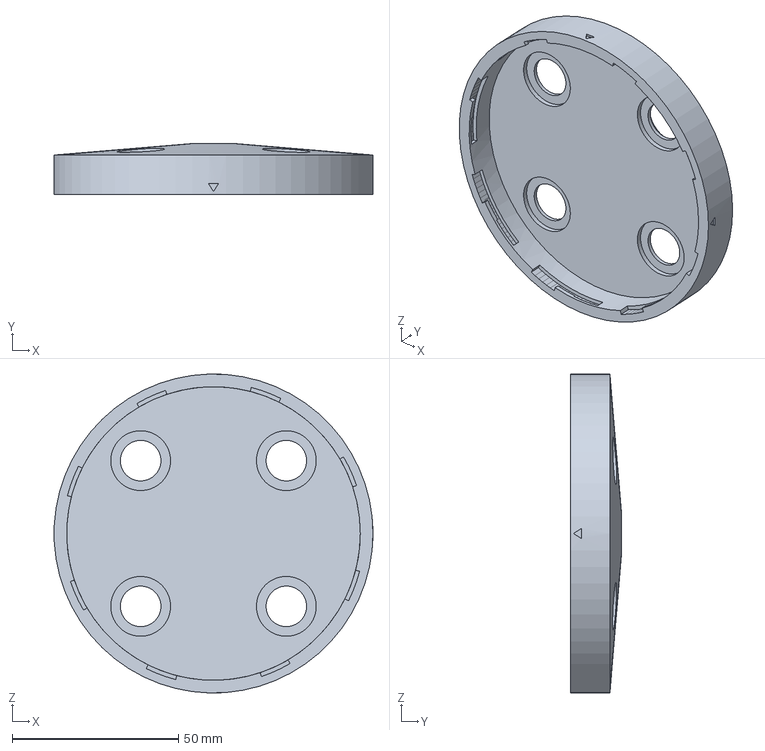
[picture p35: CAD file, 2026-11-11]
hardware/releases/v1/enclosure/wind_tunnel.step
96.0 x 15.4 x 96.0 mm
