vbartusevicius/weather-station/hardware/releases/v1/enclosure/probe_sleeve_back.step

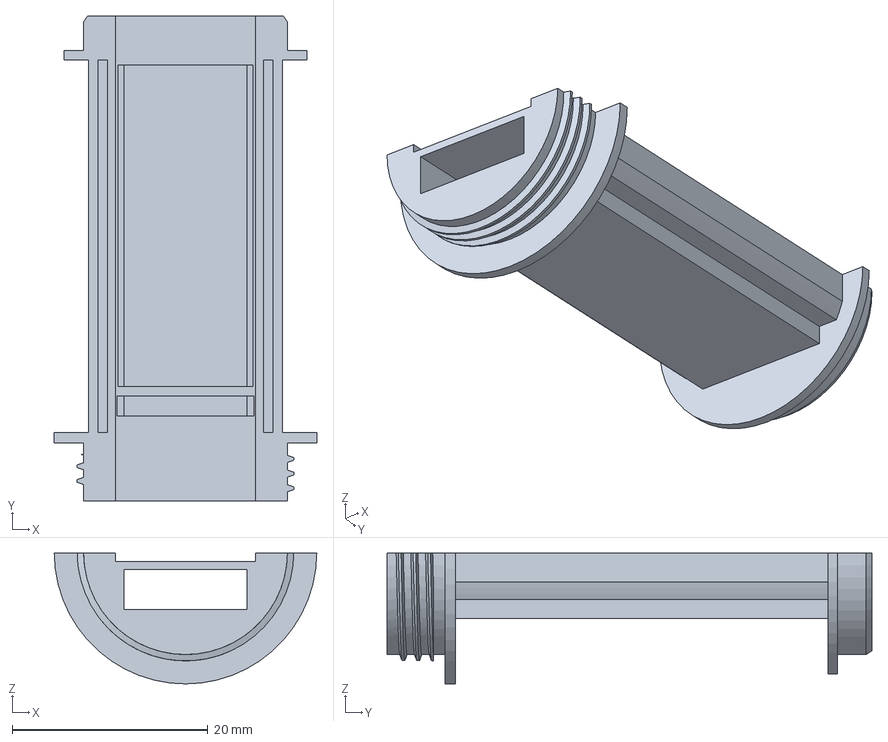
[picture p36: CAD file, 2026-11-11]
hardware/releases/v1/enclosure/probe_sleeve_back.step
26.8 x 49.5 x 13.4 mm
