vbartusevicius/weather-station/hardware/releases/v1/enclosure/orings.step

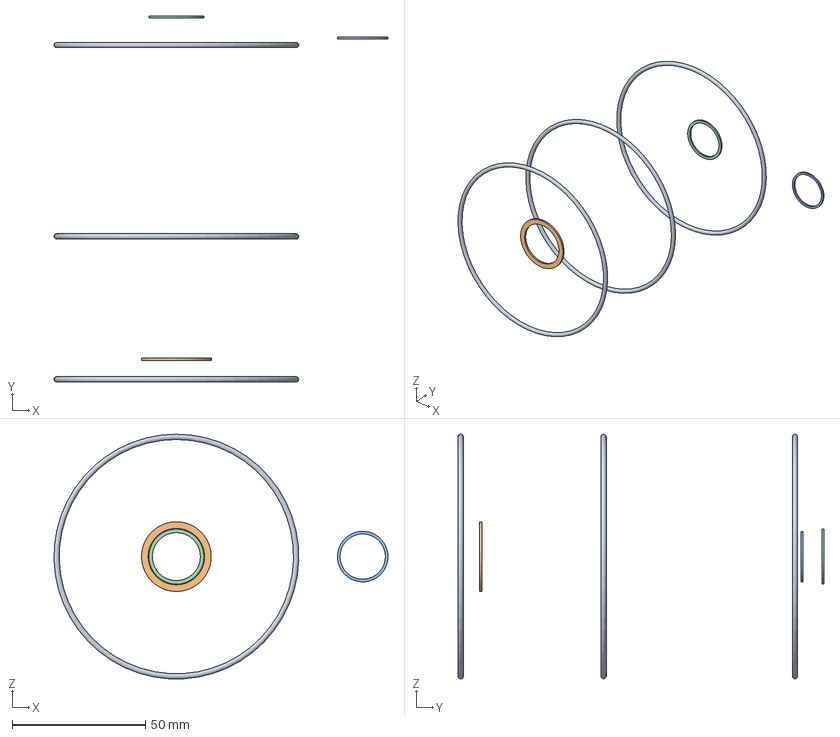
[picture p37: CAD file, 2026-11-11]
hardware/releases/v1/enclosure/orings.step
125.5 x 137.5 x 91.9 mm
