vbartusevicius/weather-station/hardware/releases/v1/enclosure/crown_base.step

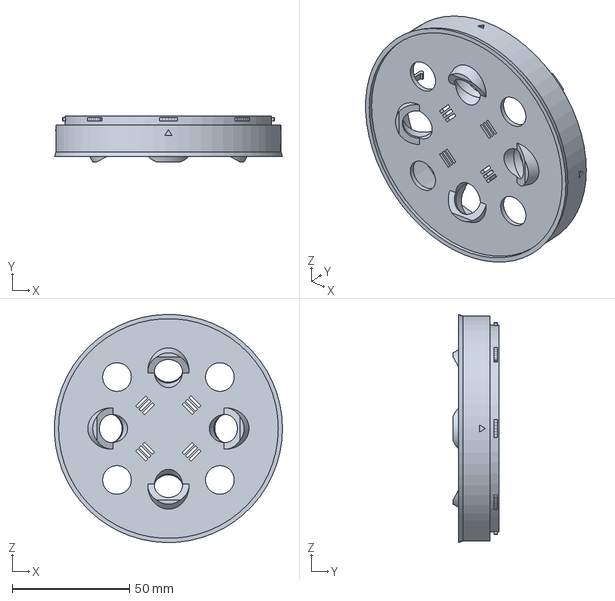
[picture p38: CAD file, 2026-11-11]
hardware/releases/v1/enclosure/crown_base.step
97.1 x 19.6 x 97.2 mm
