vbartusevicius/weather-station/hardware/releases/v1/enclosure/mast_shims.step

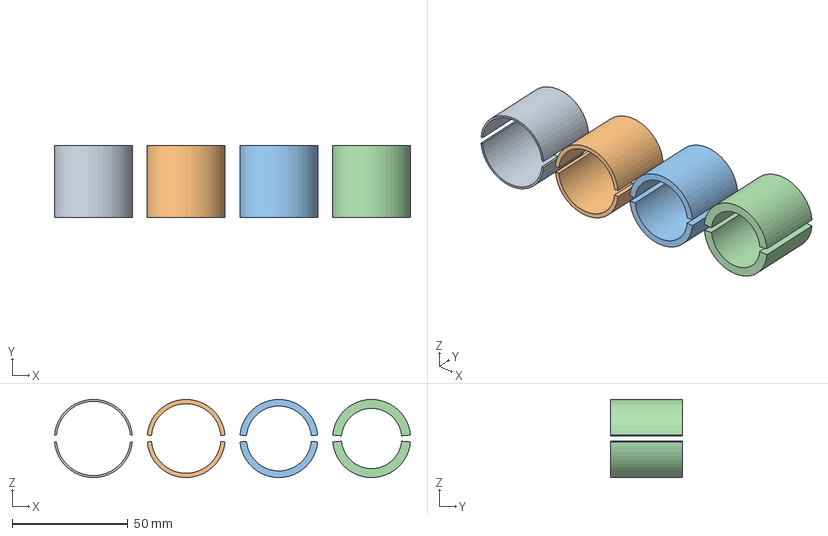
[picture p39: CAD file, 2026-11-11]
hardware/releases/v1/enclosure/mast_shims.step
153.6 x 31.0 x 33.7 mm
