vbartusevicius/weather-station/hardware/releases/v1/enclosure/probe_sleeve_front.step

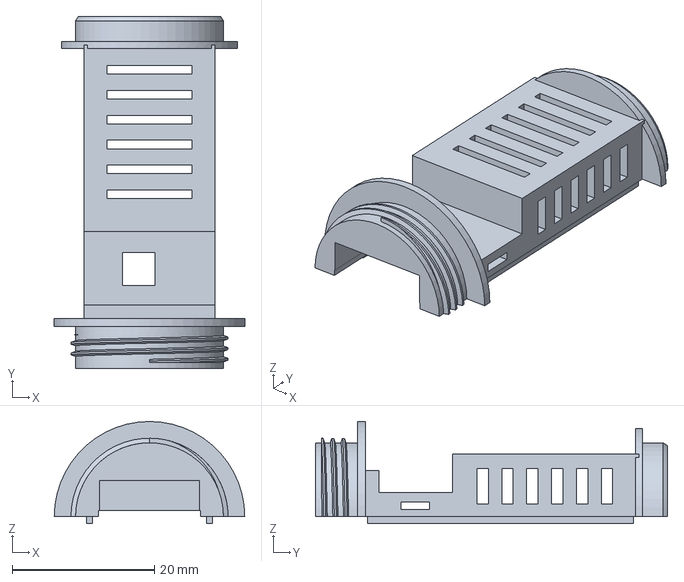
[picture p40: CAD file, 2026-11-11]
hardware/releases/v1/enclosure/probe_sleeve_front.step
26.8 x 49.5 x 14.3 mm
