vbartusevicius/weather-station/hardware/releases/v1/enclosure/ptfe_dome_lathe.step

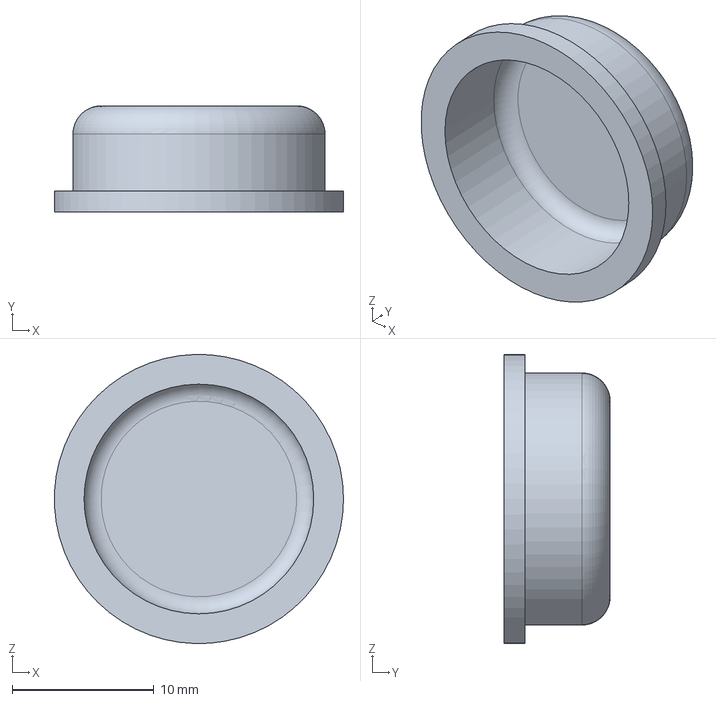
[picture p41: CAD file, 2026-11-11]
hardware/releases/v1/enclosure/ptfe_dome_lathe.step
20.4 x 7.50 x 20.4 mm
