vbartusevicius/weather-station/hardware/releases/v1/enclosure/crown.step

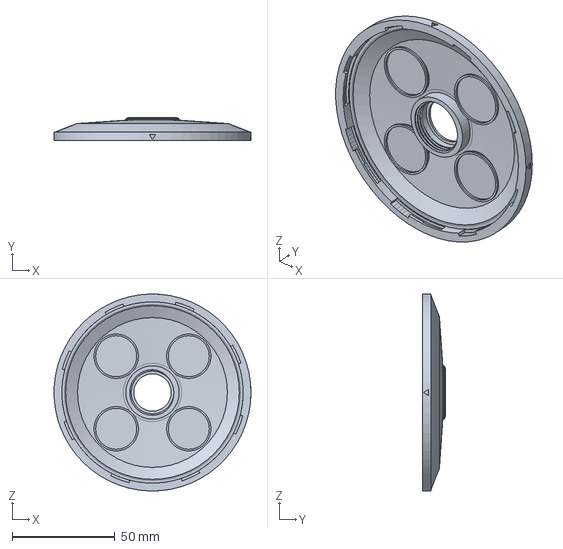
[picture p42: CAD file, 2026-11-11]
hardware/releases/v1/enclosure/crown.step
96.0 x 11.3 x 96.0 mm
