vbartusevicius/weather-station/hardware/releases/v1/enclosure/ptfe_dome_cnc.step

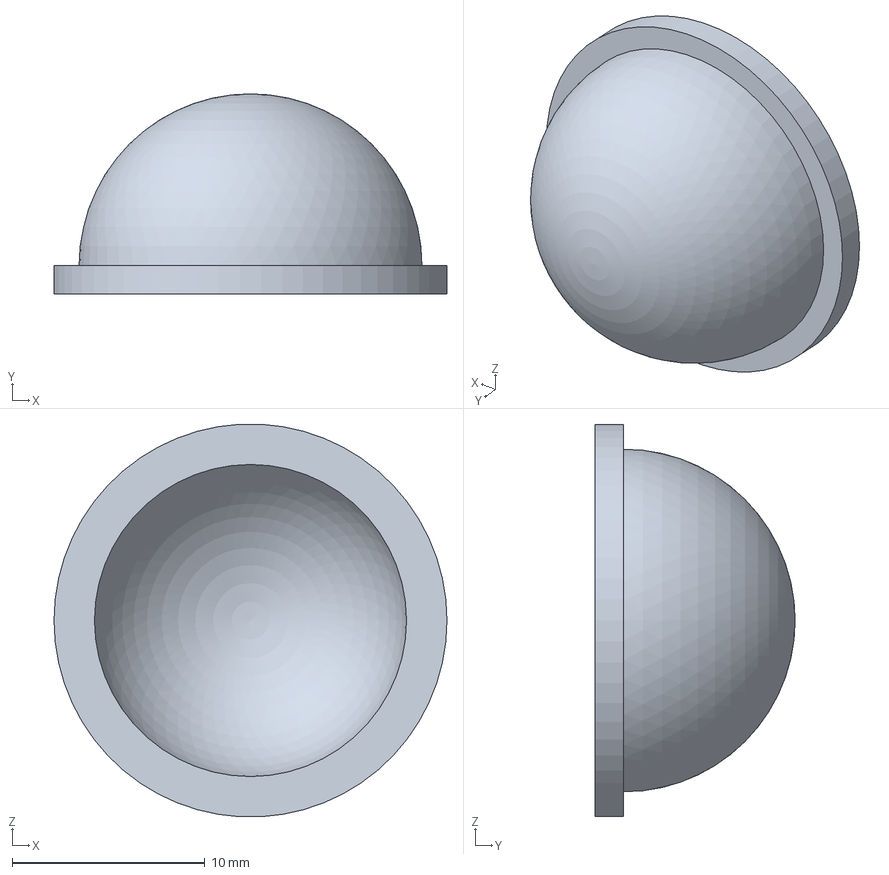
[picture p43: CAD file, 2026-11-11]
hardware/releases/v1/enclosure/ptfe_dome_cnc.step
20.4 x 10.4 x 20.4 mm
