vbartusevicius/weather-station/hardware/releases/v1/enclosure/transducer_adapters.step

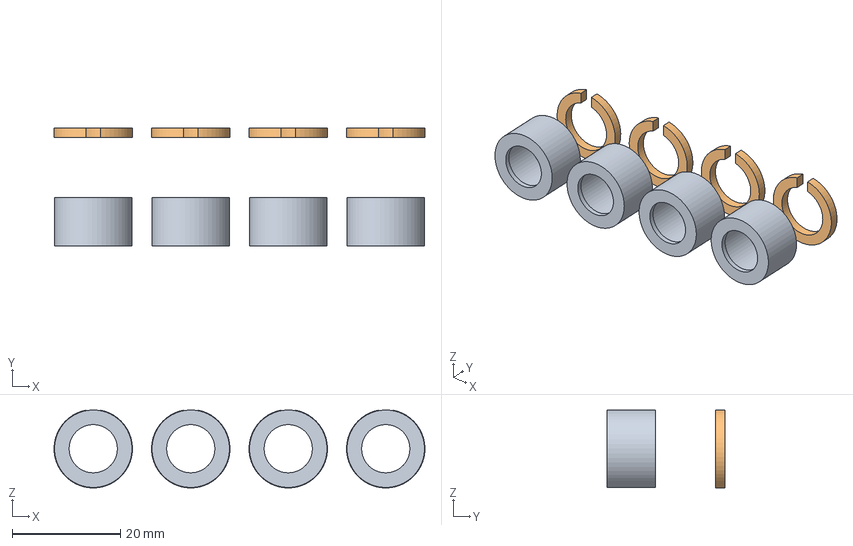
[picture p44: CAD file, 2026-11-11]
hardware/releases/v1/enclosure/transducer_adapters.step
68.5 x 21.8 x 14.4 mm
