vbartusevicius/weather-station/hardware/releases/v1/enclosure/base.step

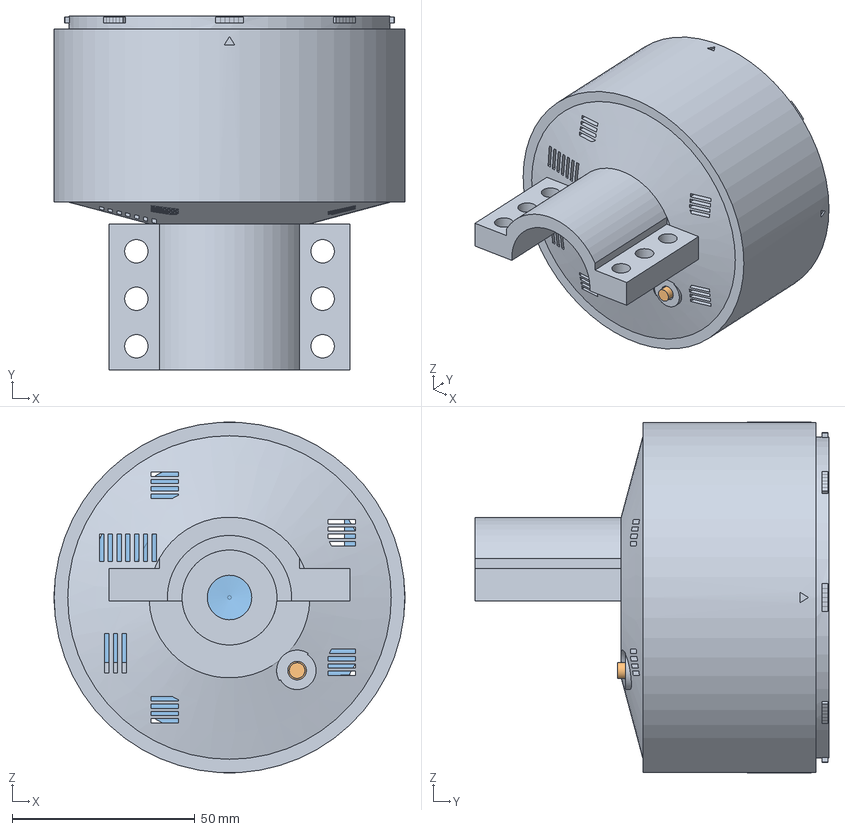
[picture p45: CAD file, 2026-11-11]
hardware/releases/v1/enclosure/base.step
96.0 x 96.9 x 96.0 mm
