vbartusevicius/weather-station/hardware/releases/v1/enclosure/pagoda.step

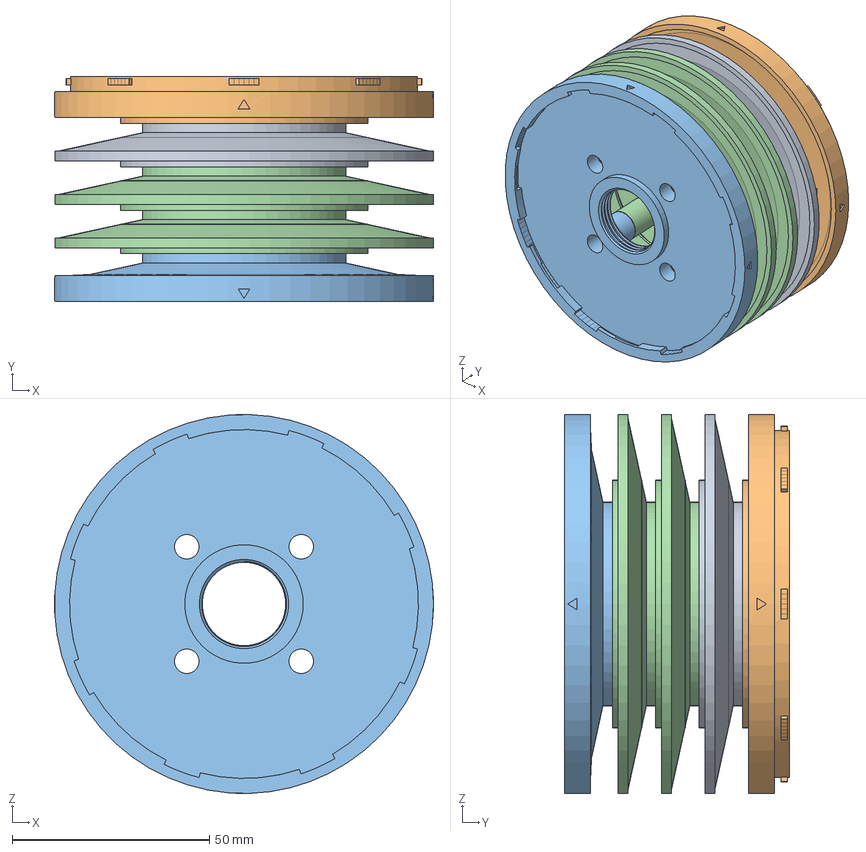
[picture p46: CAD file, 2026-11-11]
hardware/releases/v1/enclosure/pagoda.step
96.0 x 57.0 x 96.0 mm
