vbartusevicius/weather-station/hardware/releases/v1/enclosure/crown_dome.step

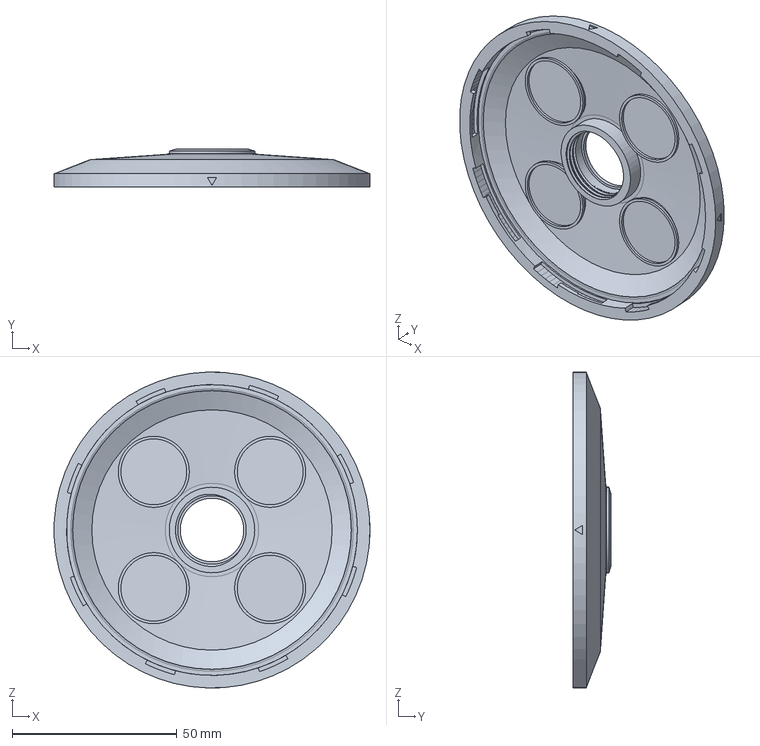
[picture p47: CAD file, 2026-10-23]
hardware/releases/v1/enclosure/crown_dome.step
96.0 x 11.5 x 96.0 mm
