vbartusevicius/weather-station/(list of files, cad)

Other CAD files:
hardware/releases/v1/dome_legacy/dome_legacy.step
hardware/releases/v1/enclosure/base.stl
hardware/releases/v1/enclosure/crown.stl
hardware/releases/v1/enclosure/crown_base.stl
hardware/releases/v1/enclosure/crown_window.stl
hardware/releases/v1/enclosure/mast_clamp.stl
hardware/releases/v1/enclosure/mast_shims.stl
hardware/releases/v1/enclosure/orings.stl
hardware/releases/v1/enclosure/pagoda.stl
hardware/releases/v1/enclosure/print/base.stl
hardware/releases/v1/enclosure/print/crown.stl
hardware/releases/v1/enclosure/print/mast_clamp.stl
hardware/releases/v1/enclosure/print/orings.stl
hardware/releases/v1/enclosure/print/pagoda.stl
hardware/releases/v1/enclosure/print/struts.stl
hardware/releases/v1/enclosure/print/wind_tunnel.stl
hardware/releases/v1/enclosure/probe_sleeve_back.stl
hardware/releases/v1/enclosure/probe_sleeve_front.stl
hardware/releases/v1/enclosure/ptfe_dome_cnc.stl
hardware/releases/v1/enclosure/ptfe_dome_lathe.stl
hardware/releases/v1/enclosure/struts.stl
hardware/releases/v1/enclosure/transducer_adapters.stl
hardware/releases/v1/enclosure/wind_tunnel.stl
