vbartusevicius/weather-station/hardware/releases/v1/dome/dome_assembly.pdf

# dome - TOP

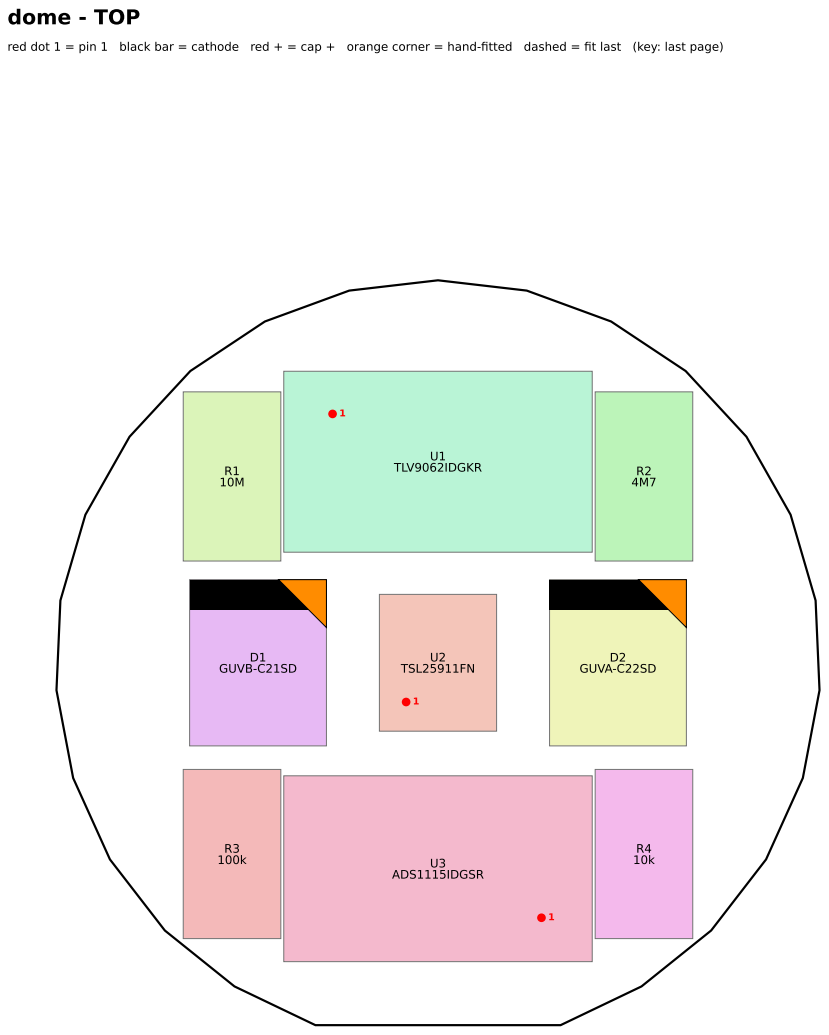
[picture p50: page 1]

red dot 1 = pin 1 black bar = cathode red + = cap + orange corner = hand-fitted dashed = fit last (key: last page)

# dome - BOTTOM (seen from below, mirrored)

red dot 1 = pin 1 black bar = cathode red + = cap + orange corner = hand-fitted dashed = fit last (key: last page)

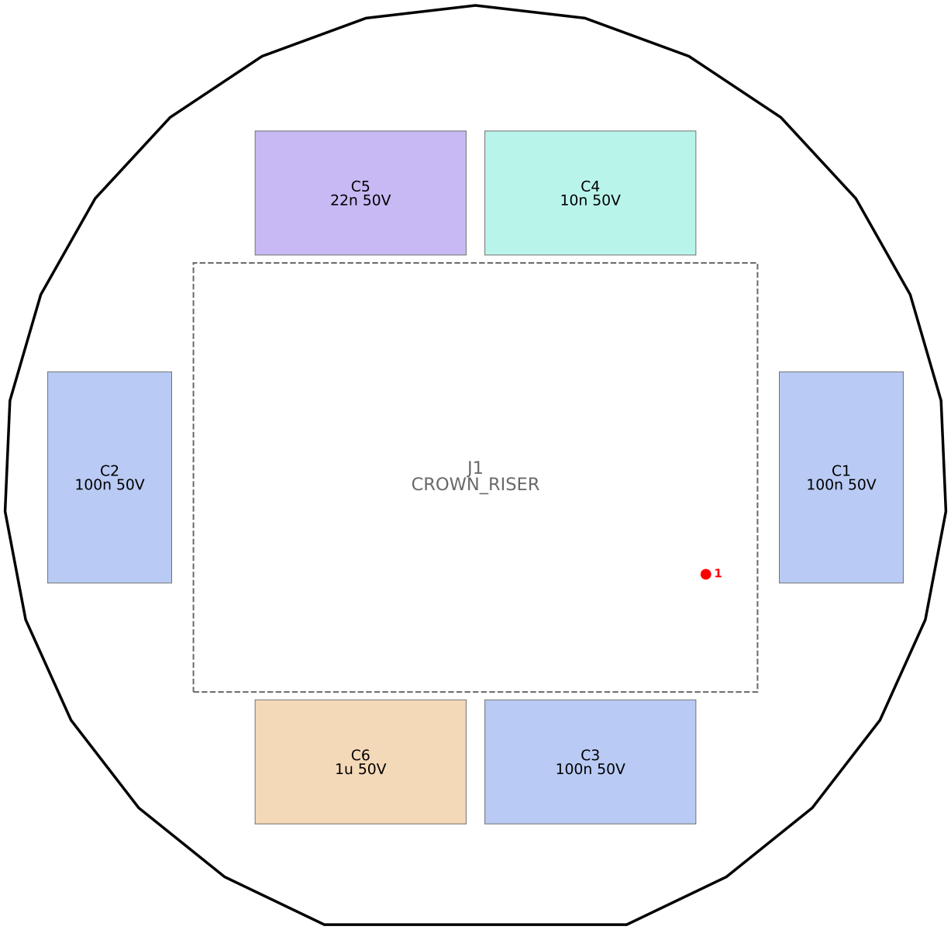
[picture p51: figure]
J1 CROWN_RISER

# dome - values

100k | x1 | top: R3
100n 50V | x3 | bottom: C1, C2, C3
10M | x1 | top: R1
10k | x1 | top: R4
10n 50V | x1 | bottom: C4
1u 50V | x1 | bottom: C6
22n 50V | x1 | bottom: C5
4M7 | x1 | top: R2
ADS1115IDGSR | x1 | top: U3
CROWN_RISER | x1 | bottom: J1
GUVA-C22SD | x1 | top: D2
GUVB-C21SD | x1 | top: D1
TLV9062IDGKR | x1 | top: U1
TSL25911FN | x1 | top: U2

# dome - key

# Marks on the board pages

red dot + 1 : pin 1 of ICs, transistors, LEDs, optocouplers, connectors and modules

black bar | : diode cathode, matching the band printed on the diode body
red + | : + pad of electrolytic / tantalum capacitors
no mark | : resistors, ceramic capacitors, inductors, fuses, crystals, pin strips, bidirectional TVS (...CA)

orange corner: part fitted by hand (not placed by JLCPCB); dashed outline: large part, fit it last

the BOTTOM page is mirrored: it shows the board as you see it from below

# Finding pin 1 on the real part

SOT-23 (3 legs): the single leg on its own side is pin 3; pin 1 is left of it on the two-leg side

SOT-23-5 / SC-70 / SOIC / VSSOP / QFN / LGA: a dot, dimple or bevelled edge marks pin 1

Addressable LEDs: a marked (cut / green) corner - check the datasheet, it is easy to misread

Diodes: the band is the cathode (K)

Electrolytic capacitors: the stripe marks the - side (the other pad is +)

# Tools

0805 / SOT-23: a 3-5x magnifier or a 10x loupe

QFN / LGA / DFN / SC-70: a USB microscope (check the pads under the part after reflow)
