vbartusevicius/weather-station/hardware/releases/v1/dome_legacy/dome_legacy_assembly.pdf

# dome_legacy - TOP

red dot 1 = pin 1 black bar = cathode red + = cap + orange corner = hand-fitted dashed = fit last (key: last page)

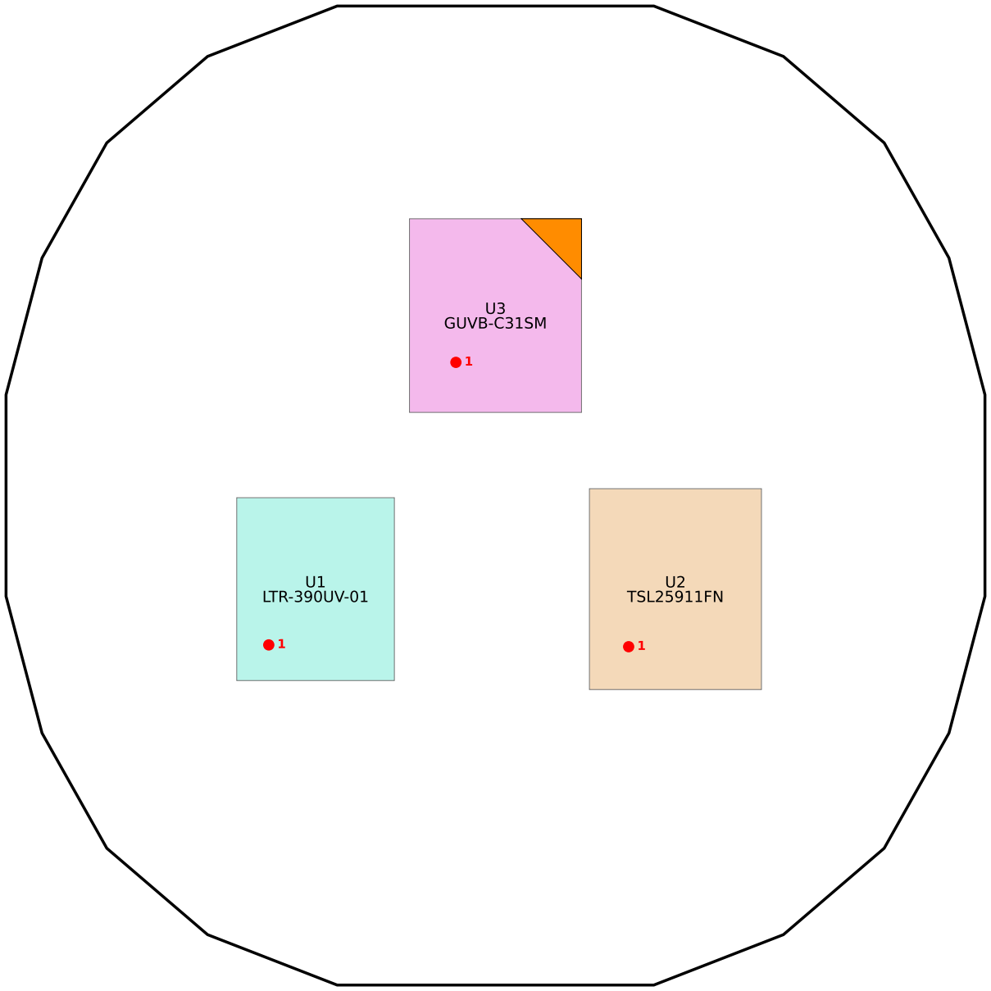
[picture p54: figure]
U2 TSL25911FN; U3 GUVB-C31SM; U1 LTR-390UV-01

# dome_legacy - BOTTOM (seen from below, mirrored)

red dot 1 = pin 1 black bar = cathode red + = cap + orange corner = hand-fitted dashed = fit last (key: last page)

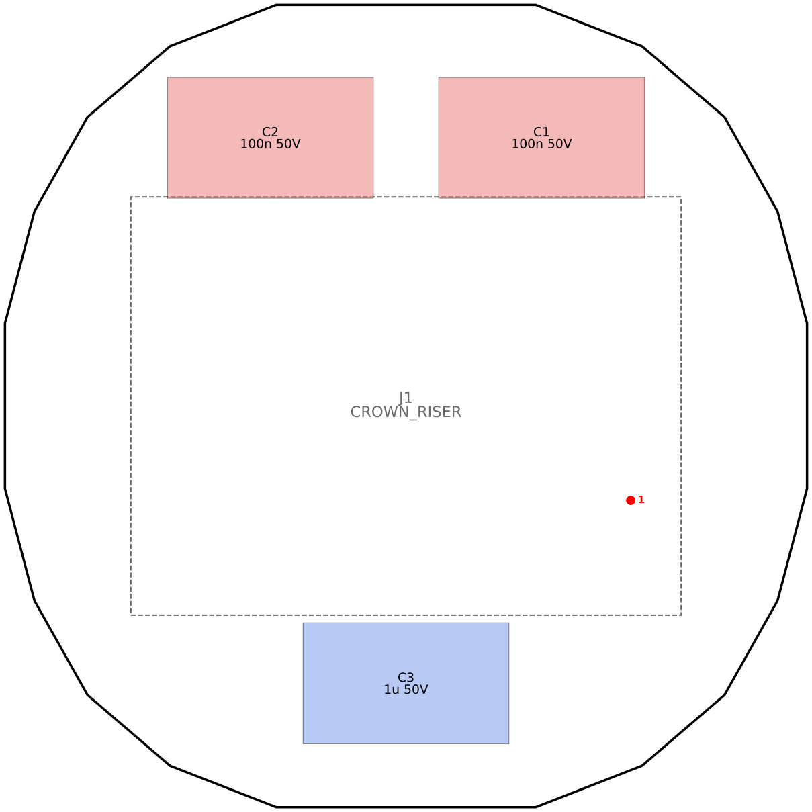
[picture p55: figure]
J1 CROWN_RISER

# dome_legacy - values

## 100n 50V x2 bottom: C1, C2 1u 50V x1 bottom: C3 CROWN_RISER x1 bottom: J1 GUVB-C31SM x1 top: U3 LTR-390UV-01 x1 top: U1 TSL25911FN x1 top: U2

# dome_legacy - key

# Marks on the board pages

red dot + 1 : pin 1 of ICs, transistors, LEDs, optocouplers, connectors and modules

black bar | : diode cathode, matching the band printed on the diode body
red + | : + pad of electrolytic / tantalum capacitors
no mark | : resistors, ceramic capacitors, inductors, fuses, crystals, pin strips, bidirectional TVS (...CA)

orange corner: part fitted by hand (not placed by JLCPCB); dashed outline: large part, fit it last

the BOTTOM page is mirrored: it shows the board as you see it from below

# Finding pin 1 on the real part

SOT-23 (3 legs): the single leg on its own side is pin 3; pin 1 is left of it on the two-leg side

SOT-23-5 / SC-70 / SOIC / VSSOP / QFN / LGA: a dot, dimple or bevelled edge marks pin 1

Addressable LEDs: a marked (cut / green) corner - check the datasheet, it is easy to misread

Diodes: the band is the cathode (K)

Electrolytic capacitors: the stripe marks the - side (the other pad is +)

# Tools

0805 / SOT-23: a 3-5x magnifier or a 10x loupe

QFN / LGA / DFN / SC-70: a USB microscope (check the pads under the part after reflow)
