vbartusevicius/weather-station/hardware/releases/v1/panel/panel.kicad_pcb

## KiCad design hardware/releases/v1/panel/panel.kicad_pcb (2026-11-11)

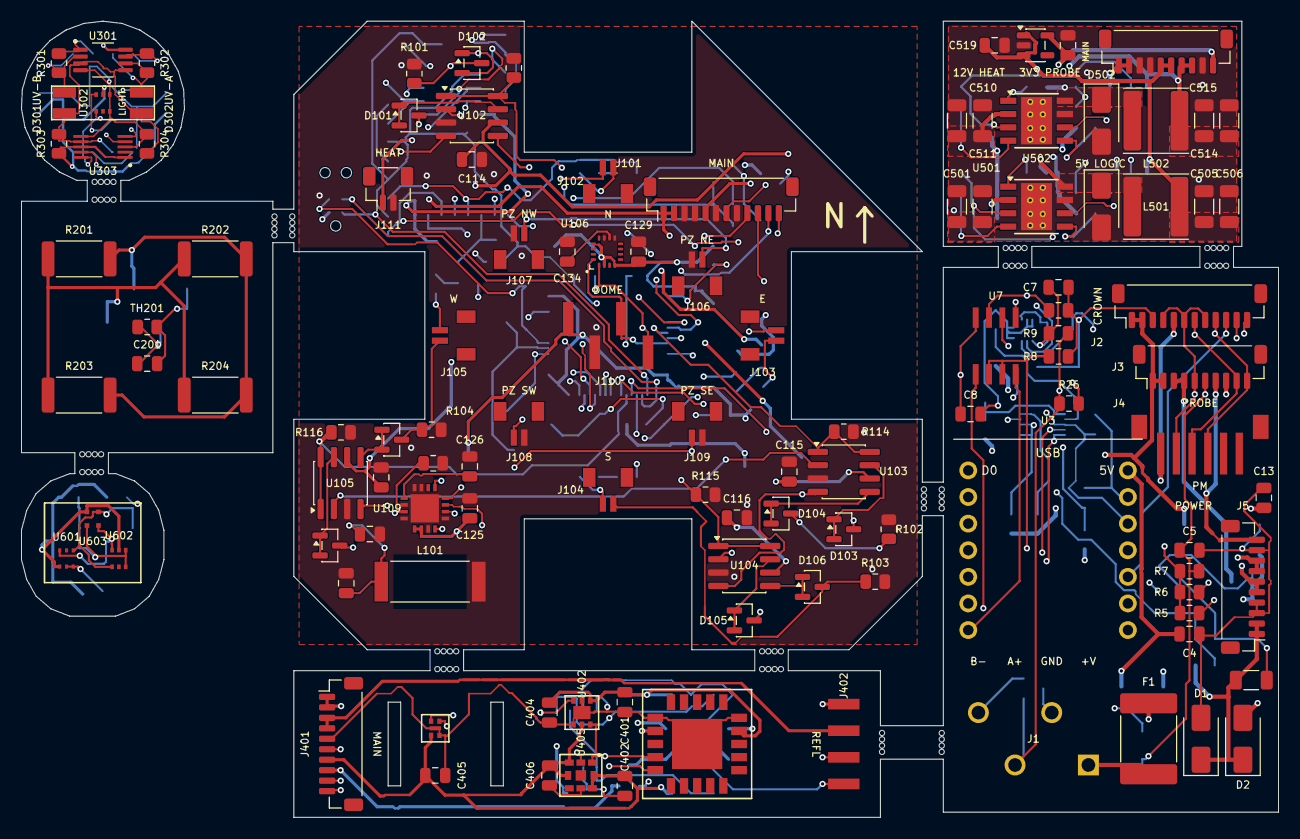
[picture p60: board panel.kicad_pcb from above]

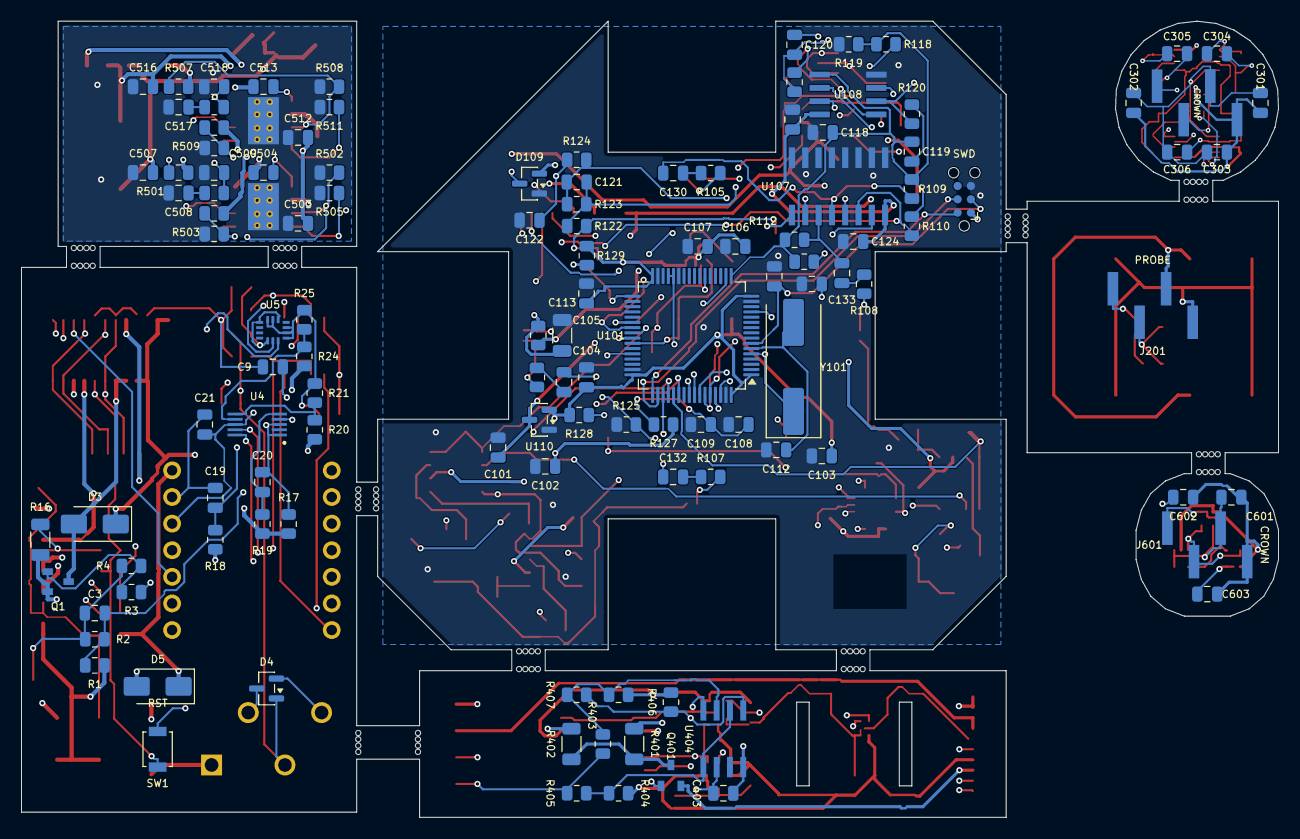
[picture p61: board panel.kicad_pcb from below]

Board: 4 copper layers, 120.0 x 76.0 mm, 236 parts (120 on the bottom side), 144 nets.

Parts:
C1, C501, C502, C510, C511: 2u2 100V; C_1206_3216Metric
C3, C5, C7, C8, C9, C21, C103, C104, C105, C106, C109, C110, C119, C123, C124, C129, C201, C301, C302, C303, C402, C403, C404, C405, C406, C504, C507, C513, C516, C601, C602: 100n 50V; C_0805_2012Metric
C4, C13, C102, C107, C134, C401, C520: 10u 10V; C_0805_2012Metric
C19, C20, C101, C108, C114, C115, C116, C117, C118, C125, C126, C306, C519, C603: 1u 50V; C_0805_2012Metric
C111, C112: 33p C0G 50V; C_0805_2012Metric
C113, C514, C515: 22u 25V; C_1206_3216Metric
C120: 220p C0G 50V; C_0805_2012Metric
C121, C305: 22n 50V; C_0805_2012Metric
C122: 1n 50V; C_0805_2012Metric
C127, C128: 470p C0G 50V; C_0805_2012Metric
C130, C131, C132, C133, C304: 10n 50V; C_0805_2012Metric
C503, C512: 100n 100V; C_0805_2012Metric
C505, C506: 47u 10V; C_1206_3216Metric
C508: 33n 50V; C_0805_2012Metric
C509, C518: 68p C0G 50V; C_0805_2012Metric
C517: 18n 50V; C_0805_2012Metric
D1: SMAJ36A; D_SMA
D2, D3: SS16; D_SMA
D4: PSM712; SOT-23
D5: SS14; D_SMA
D101, D102, D103, D104, D105, D106, D107, D108, D109: BAV99; SOT-23
D301: GUVB-C21SD; Genicom_COB2418
D302: GUVA-C22SD; Genicom_COB2418
D501, D502: B360A; D_SMA
F1: 1.1A; Fuse_2920_7451Metric
J1: 12-32V + RS485; TerminalBlock_Kefa_KF250-3.5-4P
J2: Crown board; JST_SH_BM12B-SRSS-TB_1x12-1MP_P1.00mm_Vertical
J3: Probe board; JST_SH_BM10B-SRSS-TB_1x10-1MP_P1.00mm_Vertical
J4: PMSA003I PM; JST_B6B-ZR-SM4-TF
J5: Power board; JST_SH_BM10B-SRSS-TB_1x10-1MP_P1.00mm_Vertical
J101: Main board; JST_SH_BM12B-SRSS-TB_1x12-1MP_P1.00mm_Vertical
J102: XD_N; JST_BM02B-SRSS-TB
J103: XD_E; JST_BM02B-SRSS-TB
J104: XD_S; JST_BM02B-SRSS-TB
J105: XD_W; JST_BM02B-SRSS-TB
J106: PIEZO_NE; JST_BM02B-SRSS-TB
J107: PIEZO_NW; JST_BM02B-SRSS-TB
J108: PIEZO_SW; JST_BM02B-SRSS-TB
J109: PIEZO_SE; JST_BM02B-SRSS-TB
J110: DOME_SOCKET; HX_PZ2.54-1x4P-SMD
J111: AUX 12V_HEAT; JST_SH_BM02B-SRSS-TB_1x02-1MP_P1.00mm_Vertical
J112: SWD; Tag-Connect_TC2030-IDC-NL_2x03_P1.27mm_Vertical
J201: Probe T-Header SMD; HX_PZ2.54-1x4P-SMD
J301, J601: CROWN_RISER; HX_PZ2.54-1x4P-SMD
J401, J501: Main board; JST_SH_BM10B-SRSS-TB_1x10-1MP_P1.00mm_Vertical
J402: Reflector T-Socket SMD; HX_PM2.54-1x4P-RA-SMD
L101: 100uH; AS3935_Antenna_MA5532_SDTR1103
L501: 8.2uH; L_Sunlord_SWPA6045S
L502: 22uH; L_Sunlord_SWPA6045S
MOUSE_BITES: DNP
Q1, Q401: AO3400A; AOS_AO3400A_SOT-23
R1, R4, R303: 100k; R_0805_2012Metric
R2, R7, R8, R21, R24, R25, R118, R119, R125, R126, R128, R129, R304, R403, R404, R406, R510: 10k; R_0805_2012Metric
R3, R101, R102, R103, R104: 330R; R_0805_2012Metric
R5, R6: 2k2; R_0805_2012Metric
R9, R10: 390R; R_0805_2012Metric
R16: 0R1; R_1206_3216Metric
R17: 1R; R_0805_2012Metric
R18, R19, R120, R122: 1k; R_0805_2012Metric
R20: 30k; R_0805_2012Metric
R26: 120R; R_0805_2012Metric
R105, R106, R107, R108: 47k; R_0805_2012Metric
R109, R110, R111, R112: 1M; R_0805_2012Metric
R113, R114, R115, R116: 4k7; R_0805_2012Metric
R117, R127: 10R; R_0805_2012Metric
R121: 6k8; R_0805_2012Metric
R123, R302: 4M7; R_0805_2012Metric
R124: 22k; R_0805_2012Metric
R201, R202, R203, R204: 120R; R_2512_6332Metric
R301: 10M; R_0805_2012Metric
R401, R402: 680R; R_1206_3216Metric
R405: 51k; R_0805_2012Metric
R407: 470k; R_0805_2012Metric
R501, R507: 511k; R_0805_2012Metric
R502, R508: 82k5; R_0805_2012Metric
R503: 53k6; R_0805_2012Metric
R504: 10k2; R_0805_2012Metric
R505, R511: 130k; R_0805_2012Metric
R506, R512: 6k49; R_0805_2012Metric
R509: 140k; R_0805_2012Metric
SW1: SERVICE; SW_SPST_B3U-1000P
TH201, TH401: 10k NTC; R_0805_2012Metric
U3: XIAO ESP32C6; XIAO_ESP32C6_Header
U4, U303: ADS1115IDGSR; TI_ADS1115_VSSOP-10
U5: LSM6DS3TR-C; ST_LSM6DS3TR-C_LGA-14
U7: SP3485EN-L/TR; ON_LM393DR2G_SOIC-8
U101: STM32G431RBT6; LQFP-64_10x10mm_P0.5mm
U102, U103, U104, U105: UCC27524ADR; SOIC-8_3.9x4.9mm_P1.27mm
U106: MMC5983MA; MEMSIC_MMC5983MA_LGA-16
U107: 74HC4052D; TI_CD4052BM96_SOIC-16
U108: TLV9062IDR; TI_TLV9062IDR_SOIC-8
U109: AS3935-BQFT; ScioSense_AS3935_QFN-16
U110: XC6206P332MR; SOT-23
U301: TLV9062IDGKR; TI_TLV9062_VSSOP-8
U302, U602: TSL25911FN; AMS_TSL25911FN
U401: SCD41-D-R2; Sensirion_SCD41_LGA-20
U402: SGP41-D-R4; Sensirion_SGP41_DFN-6
U403: SHT40-AD1F-R2; Sensirion_SHT45_DFN-4
U404: LM2903DR2G; ON_LM393DR2G_SOIC-8
U405: BMP585; Bosch_BMP585_LGA-9
U501, U502: TPS54360DDAR; TI_SO-PowerPAD-8_ThermalVias
U503: AP2112K-3.3; SOT-23-5
U601: LTR-390UV-01; LiteOn_LTR-390UV-01
U603: GUVB-C31SM; GenUV_GUVB-C31SM
Y101: 8MHz; Crystal_SMD_HC49-SD

Connections:
+3V3: C7.1, C8.1, C9.1, C21.1, R5.1, R6.1, R7.1, R9.1, U3.12, U4.8, U5.5, U5.8, U5.12, U7.8
+3V3_PROBE: J3.7, J5.10
+5V: C13.1, D5.2, J2.5, J4.1, J5.5, J5.6, R24.1
+5V_XIAO: C4.1, D5.1, U3.14
+12V_HEAT: D3.1, J2.1, J2.2, J3.1, J3.2, J5.7, J5.8, R20.1
CO2_HEAT_RTN: J3.8, R17.1, R19.1
CROWN_+3V3: C102.1, C103.1, C104.1, C105.1, C106.1, C107.1, C123.1, C124.1, C125.1, C129.1, D109.2, J110.1, J112.1, R127.1, R128.2, R129.2, U101.1, U101.16, U101.32, U101.48, U101.64, U106.2, U106.4, U106.13, U107.16, U108.8, U109.5, U109.6, U110.2
CROWN_+3V3A: C108.1, C109.1, R118.1, R127.2, U101.28, U101.29
CROWN_+5V: C101.1, J101.5, U110.3
CROWN_+12V_HEAT: J101.1, J101.2, J111.1, R117.1
CROWN_AS_ACG: C126.1, U109.1
CROWN_AS_CS: U101.51, U109.8
CROWN_AS_INP: C127.1, C128.1, L101.1, R126.1, U109.3
CROWN_AS_IRQ: U101.62, U109.10
CROWN_AS_MISO: U101.57, U109.12
CROWN_AS_MOSI: U101.58, U109.13
CROWN_AS_SCK: U101.56, U109.11
CROWN_BL_PA10: R128.1, U101.44
CROWN_BL_PB12: R129.1, U101.33
CROWN_BOOT0: J2.12, U3.3
CROWN_CROWN_BOOT0: J101.12, R125.1, U101.61
CROWN_CROWN_IRQ: J101.10, U101.54
CROWN_CROWN_NRST: C110.1, J101.11, J112.3, U101.7
CROWN_GND: C101.2, C102.2, C103.2, C104.2, C105.2, C106.2, C107.2, C108.2, C109.2, C110.2, C111.2, C112.2, C113.2, C114.2, C115.2, C116.2, C117.2, C118.2, C122.2, C123.2, C124.2, C125.2, C126.2, C127.2, C128.2, C129.2, C134.2, D109.1, J101.3, J101.4, J101.6, J101.8, J106.2, J107.2, J108.2, J109.2, J110.2, J111.2, J112.5, L101.2, R101.2, R102.2, R103.2, R104.2, R113.2, R114.2, R115.2, R116.2, R119.2, R125.2, R126.2, U101.15, U101.27, U101.31, U101.47, U101.63, U102.3, U103.3, U104.3, U105.3, U106.9, U106.11, U107.1, U107.2, U107.3, U107.4, U107.5, U107.6, U107.7, U107.8, U108.4, U109.2, U109.4, U109.7, U109.9, U109.15, U109.16, U109.17, U110.1
CROWN_I2C_SCL: J101.9, J110.4, U101.22, U106.1
CROWN_I2C_SDA: J101.7, J110.3, U101.42, U106.16
CROWN_IRQ: J2.10, U3.10
CROWN_MAG_CAP: C134.1, U106.10
CROWN_MUX_S0: U101.59, U107.10
CROWN_MUX_S1: U101.60, U107.9
CROWN_NRST: J2.11, U3.11
CROWN_PIEZO_IN: D109.3, J106.1, J107.1, J108.1, J109.1, R122.1
CROWN_PIEZO_INV: C121.1, R122.2, R123.1, U108.6
CROWN_PIEZO_OUT: C121.2, R123.2, R124.1, U108.7
CROWN_RAIN_ADC: C122.1, R124.2, U101.18
CROWN_SWCLK: J112.4, U101.50
CROWN_SWDIO: J112.2, U101.49
CROWN_TX_N: U101.52, U102.4, U103.4, U104.4, U105.4
CROWN_TX_P: U101.38, U102.2, U103.2, U104.2, U105.2
CROWN_US_AMP_FB: C120.1, R120.1, R121.1, U108.2
CROWN_US_AMP_G: C119.1, R120.2
CROWN_US_AMP_OUT: C120.2, R121.2, U101.13, U108.1
CROWN_US_RX_MUX: U107.13, U108.3
CROWN_US_VREF: C118.1, C119.2, R109.2, R110.2, R111.2, R112.2, R118.2, R119.1, U101.17, U108.5
CROWN_VDRV: C113.1, C114.1, C115.1, C116.1, C117.1, R117.2, U102.6, U103.6, U104.6, U105.6
CROWN_XD_EN_E: R114.1, U101.40, U103.1, U103.8
CROWN_XD_EN_N: R113.1, U101.39, U102.1, U102.8
CROWN_XD_EN_S: R115.1, U101.41, U104.1, U104.8
CROWN_XD_EN_W: R116.1, U101.53, U105.1, U105.8
CROWN_XD_E_A: D103.3, J103.1, R106.1
CROWN_XD_E_B: D104.3, J103.2, R102.1
CROWN_XD_E_OUT_A: D103.1, D103.2, U103.7
CROWN_XD_E_OUT_B: D104.1, D104.2, U103.5
CROWN_XD_E_RX: C131.2, R110.1, U107.14
CROWN_XD_E_RXC: C131.1, R106.2
CROWN_XD_N_A: D101.3, J102.1, R105.1
CROWN_XD_N_B: D102.3, J102.2, R101.1
CROWN_XD_N_OUT_A: D101.1, D101.2, U102.7
CROWN_XD_N_OUT_B: D102.1, D102.2, U102.5
CROWN_XD_N_RX: C130.2, R109.1, U107.12
CROWN_XD_N_RXC: C130.1, R105.2
CROWN_XD_S_A: D105.3, J104.1, R107.1
CROWN_XD_S_B: D106.3, J104.2, R103.1
CROWN_XD_S_OUT_A: D105.1, D105.2, U104.7
CROWN_XD_S_OUT_B: D106.1, D106.2, U104.5
CROWN_XD_S_RX: C132.2, R111.1, U107.15
CROWN_XD_S_RXC: C132.1, R107.2
CROWN_XD_W_A: D107.3, J105.1, R108.1
CROWN_XD_W_B: D108.3, J105.2, R104.1
CROWN_XD_W_OUT_A: D107.1, D107.2, U105.7
CROWN_XD_W_OUT_B: D108.1, D108.2, U105.5
CROWN_XD_W_RX: C133.2, R112.1, U107.11
CROWN_XD_W_RXC: C133.1, R108.2
CROWN_XTAL_IN: C111.1, U101.5, Y101.1
CROWN_XTAL_OUT: C112.1, U101.6, Y101.2
DOME_+3V3: C301.1, C302.1, C303.1, J301.1, R303.1, U301.8, U302.5, U303.1, U303.8
DOME_GND: C301.2, C302.2, C303.2, C306.2, J301.2, R304.2, U301.4, U302.3, U302.4, U303.3, U303.6
DOME_I2C_SCL: J301.4, U302.1, U303.10
DOME_I2C_SDA: J301.3, U302.6, U303.9
DOME_LEGACY_+3V3: C601.1, C602.1, C603.1, J601.1, U601.1, U602.5, U603.4
DOME_LEGACY_GND: C601.2, C602.2, C603.2, J601.2, U601.2, U601.3, U602.3, U602.4, U603.1
DOME_LEGACY_I2C_SCL: J601.4, U601.4, U602.1, U603.3
DOME_LEGACY_I2C_SDA: J601.3, U601.6, U602.6, U603.2
DOME_UVA_IN: C305.1, D302.2, R302.1, U301.6
DOME_UVA_OUT: C305.2, R302.2, U301.7, U303.5
DOME_UVB_IN: C304.1, D301.2, R301.1, U301.2
DOME_UVB_OUT: C304.2, R301.2, U301.1, U303.4
DOME_UV_VB: C306.1, D301.1, D302.1, R303.2, R304.1, U301.3, U301.5, U303.7
GND: C1.2, C3.2, C4.2, C5.2, C7.2, C8.2, C9.2, C13.2, C19.2, C20.2, C21.2, D1.2, D4.3, J1.2, J2.3, J2.4, J2.6, J2.8, J3.5, J4.2, J5.3, J5.4, J5.9, R2.2, R4.2, R8.2, R10.2, R16.2, R17.2, R21.2, R25.2, SW1.2, U3.13, U4.1, U4.3, U5.1, U5.2, U5.3, U5.6, U5.7, U7.5
HEAT_GATE: Q1.1, R3.2, R4.1
HEAT_PWM: R3.1, U3.4
HEAT_SENSE: Q1.2, R16.1, R18.1
HEAT_SW: D3.2, J3.3, J3.4, Q1.3
I2C_SCL: J2.9, J3.10, J4.4, R6.2, U3.6, U4.10, U5.13
I2C_SDA: J2.7, J3.9, J4.3, R5.2, U3.5, U4.9, U5.14
MON_5V: R20.2, R21.1, U4.6
MON_5V_LOGIC: R24.2, R25.1, U4.7
MON_PROBE: C20.1, R19.2, U4.5
MON_REFL: C19.1, R18.2, U4.4
NTC_SENSE: C5.1, J3.6, R7.2, SW1.1, U3.2
POWER_+3V3_PROBE: C520.1, J501.10, U503.5
POWER_+5V: C505.1, C506.1, C507.1, C519.1, J501.5, J501.6, L501.2, R503.1, U503.1, U503.3
POWER_+12V_HEAT: C514.1, C515.1, C516.1, J501.7, J501.8, L502.2, R509.1
POWER_GND: C501.2, C502.2, C503.2, C505.2, C506.2, C507.2, C508.2, C509.2, C510.2, C511.2, C512.2, C514.2, C515.2, C516.2, C517.2, C518.2, C519.2, C520.2, D501.2, D502.2, J501.3, J501.4, J501.9, R502.2, R504.2, R505.2, R508.2, R510.2, R511.2, U501.7, U501.9, U502.7, U502.9, U503.2
POWER_HEAT_BST: C513.1, U502.1
POWER_HEAT_CC: C517.1, R512.2
POWER_HEAT_COMP: C518.1, R512.1, U502.6
POWER_HEAT_EN: R507.2, R508.1, U502.3
POWER_HEAT_FB: R509.2, R510.1, U502.5
POWER_HEAT_RT: R511.1, U502.4
POWER_HEAT_SW: C513.2, D502.1, L502.1, U502.8
POWER_LOGIC_BST: C504.1, U501.1
POWER_LOGIC_CC: C508.1, R506.2
POWER_LOGIC_COMP: C509.1, R506.1, U501.6
POWER_LOGIC_EN: R501.2, R502.1, U501.3
POWER_LOGIC_FB: R503.2, R504.1, U501.5
POWER_LOGIC_RT: R505.1, U501.4
POWER_LOGIC_SW: C504.2, D501.1, L501.1, U501.8
POWER_VIN_PROT: C501.1, C502.1, C503.1, C510.1, C511.1, C512.1, J501.1, J501.2, R501.1, R507.1, U501.2, U502.2
PROBE_+3V3_PROBE: C401.1, C402.1, C404.1, C405.1, C406.1, J401.7, R403.1, R404.1, R406.1, U401.7, U401.19, U402.1, U402.5, U403.3, U405.3, U405.4, U405.7, U405.8
PROBE_+12V_HEAT: C403.1, J401.1, J401.2, J402.1, R401.1, R402.1, U404.8
PROBE_CO2_GATE: Q401.1, R406.2, R407.1, U404.1
PROBE_CO2_HEAT_RTN: J401.8, Q401.2
PROBE_CO2_HEAT_SW: Q401.3, R401.2, R402.2
PROBE_CO2_NTC: R403.2, R407.2, TH401.1, U404.3
PROBE_CO2_VSET: R404.2, R405.1, U404.2, U404.5
PROBE_GND: C401.2, C402.2, C403.2, C404.2, C405.2, C406.2, J401.5, J402.4, R405.2, TH401.2, U401.6, U401.20, U401.21, U402.2, U402.4, U402.7, U403.4, U403.5, U404.4, U404.6, U405.6
PROBE_HEAT_SW: J401.3, J401.4, J402.2
PROBE_I2C_SCL: J401.10, U401.9, U402.6, U403.2, U405.1
PROBE_I2C_SDA: J401.9, U401.10, U402.3, U403.1, U405.2
PROBE_NTC_SENSE: J401.6, J402.3
REFLECTOR_+12V_HEAT: J201.1, R201.1, R202.1, R203.1, R204.1
REFLECTOR_GND: C201.2, J201.4, TH201.2
REFLECTOR_HEAT_SW: J201.2, R201.2, R202.2, R203.2, R204.2
REFLECTOR_NTC_SENSE: C201.1, J201.3, TH201.1
RS485_A: D4.1, J1.3, R9.2, R26.1, U7.6
RS485_B: D4.2, J1.4, R10.1, R26.2, U7.7
RS485_DE: R8.1, U3.9, U7.2, U7.3
RS485_RX: U3.8, U7.1
RS485_TX: U3.7, U7.4
VIN_ADC: C3.1, R1.2, R2.1, U3.1
VIN_FUSED: D2.2, F1.2
VIN_PROT: C1.1, D1.1, D2.1, J5.1, J5.2, R1.1
VIN_RAW: F1.1, J1.1
