vbartusevicius/weather-station/hardware/layout/v1/crown/crown.kicad_pcb

## KiCad design hardware/layout/v1/crown/crown.kicad_pcb (2026-11-11)

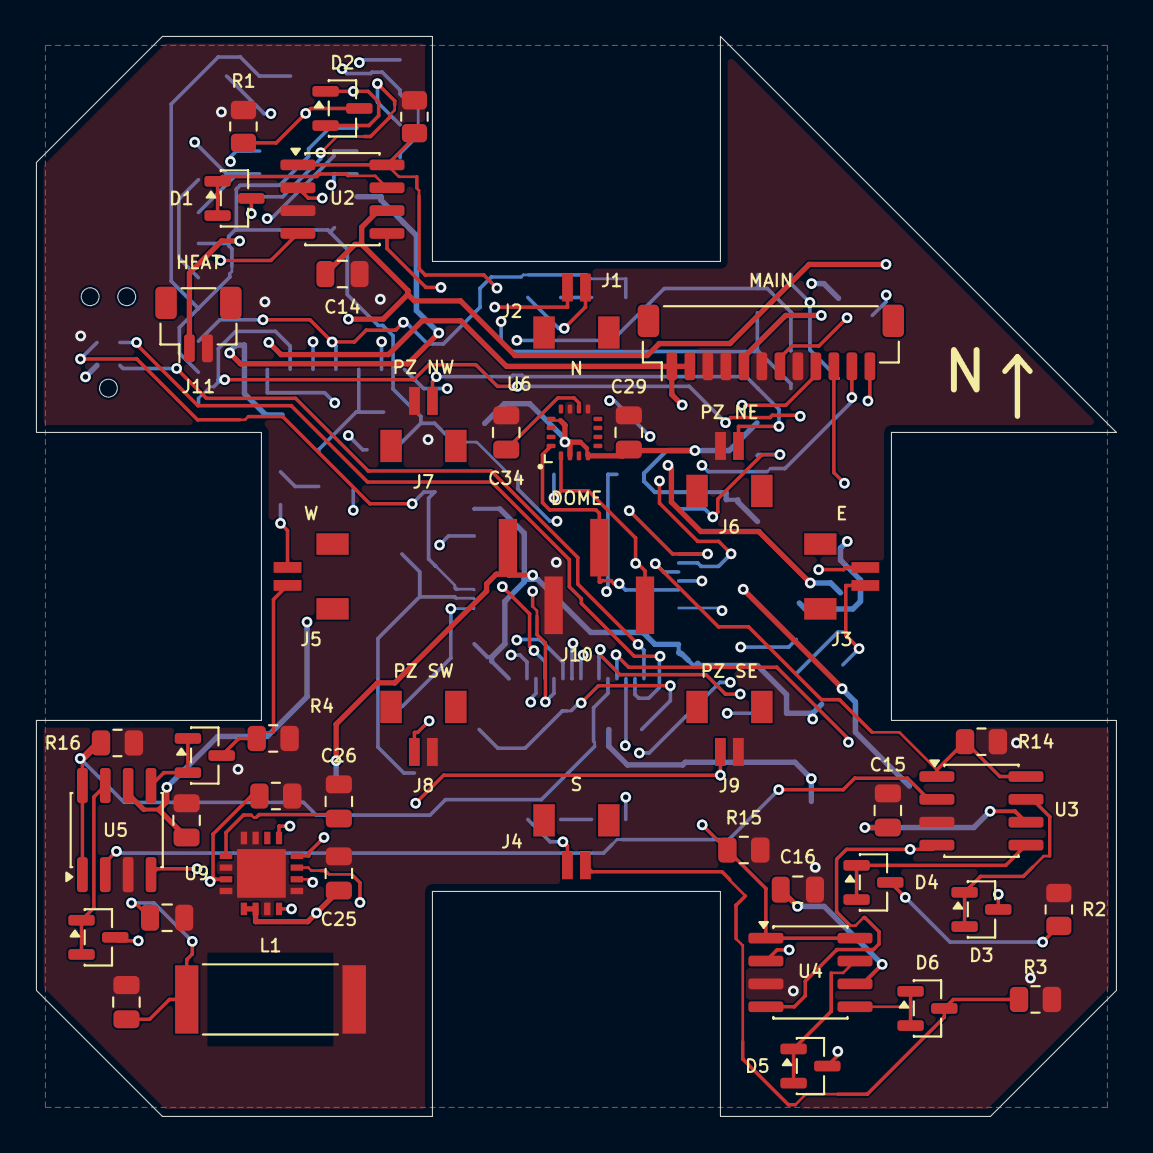
[picture p62: board crown.kicad_pcb from above]

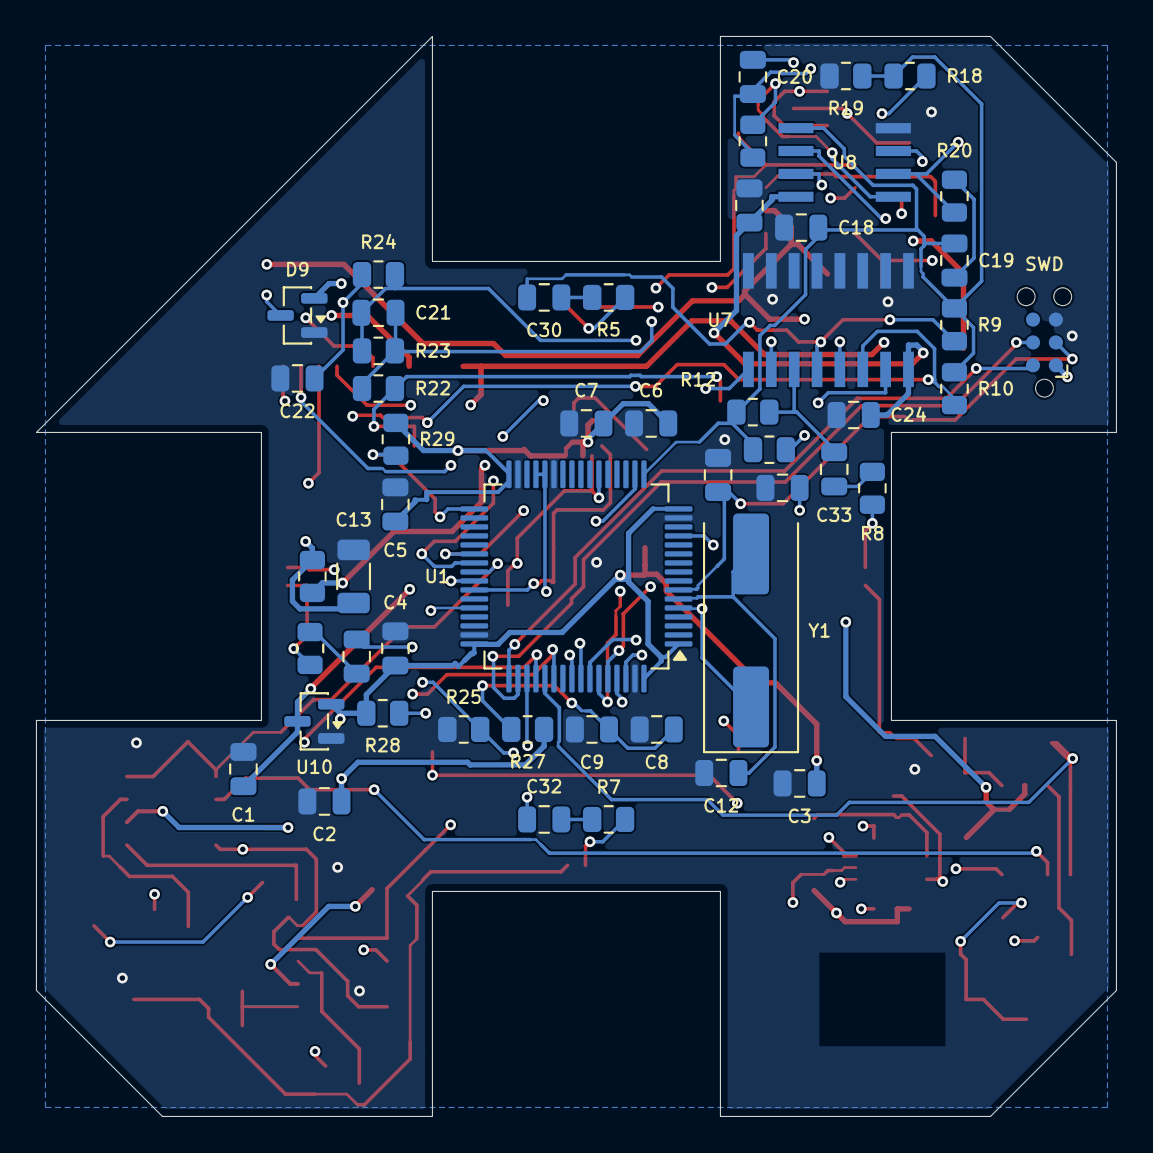
[picture p63: board crown.kicad_pcb from below]

Board: 4 copper layers, 60.0 x 60.0 mm, 96 parts (51 on the bottom side), 66 nets.

Parts:
C1, C8, C14, C15, C16, C17, C18, C25, C26: 1u 50V; C_0805_2012Metric
C2, C7, C34: 10u 10V; C_0805_2012Metric
C3, C4, C5, C6, C9, C10, C19, C23, C24, C29: 100n 50V; C_0805_2012Metric
C11, C12: 33p C0G 50V; C_0805_2012Metric
C13: 22u 25V; C_1206_3216Metric
C20: 220p C0G 50V; C_0805_2012Metric
C21: 22n 50V; C_0805_2012Metric
C22: 1n 50V; C_0805_2012Metric
C27, C28: 470p C0G 50V; C_0805_2012Metric
C30, C31, C32, C33: 10n 50V; C_0805_2012Metric
D1, D2, D3, D4, D5, D6, D7, D8, D9: BAV99; SOT-23
J1: Main board; JST_SH_BM12B-SRSS-TB_1x12-1MP_P1.00mm_Vertical
J2: XD_N; JST_BM02B-SRSS-TB
J3: XD_E; JST_BM02B-SRSS-TB
J4: XD_S; JST_BM02B-SRSS-TB
J5: XD_W; JST_BM02B-SRSS-TB
J6: PIEZO_NE; JST_BM02B-SRSS-TB
J7: PIEZO_NW; JST_BM02B-SRSS-TB
J8: PIEZO_SW; JST_BM02B-SRSS-TB
J9: PIEZO_SE; JST_BM02B-SRSS-TB
J10: DOME_SOCKET; HX_PZ2.54-1x4P-SMD
J11: AUX 12V_HEAT; JST_SH_BM02B-SRSS-TB_1x02-1MP_P1.00mm_Vertical
J12: SWD; Tag-Connect_TC2030-IDC-NL_2x03_P1.27mm_Vertical
L1: 100uH; AS3935_Antenna_MA5532_SDTR1103
R1, R2, R3, R4: 330R; R_0805_2012Metric
R5, R6, R7, R8: 47k; R_0805_2012Metric
R9, R10, R11, R12: 1M; R_0805_2012Metric
R13, R14, R15, R16: 4k7; R_0805_2012Metric
R17, R27: 10R; R_0805_2012Metric
R18, R19, R25, R26, R28, R29: 10k; R_0805_2012Metric
R20, R22: 1k; R_0805_2012Metric
R21: 6k8; R_0805_2012Metric
R23: 4M7; R_0805_2012Metric
R24: 22k; R_0805_2012Metric
U1: STM32G431RBT6; LQFP-64_10x10mm_P0.5mm
U2, U3, U4, U5: UCC27524ADR; SOIC-8_3.9x4.9mm_P1.27mm
U6: MMC5983MA; MEMSIC_MMC5983MA_LGA-16
U7: 74HC4052D; TI_CD4052BM96_SOIC-16
U8: TLV9062IDR; TI_TLV9062IDR_SOIC-8
U9: AS3935-BQFT; ScioSense_AS3935_QFN-16
U10: XC6206P332MR; SOT-23
Y1: 8MHz; Crystal_SMD_HC49-SD

Connections:
+3V3: C2.1, C3.1, C4.1, C5.1, C6.1, C7.1, C23.1, C24.1, C25.1, C29.1, D9.2, J10.1, J12.1, R27.1, R28.2, R29.2, U1.1, U1.16, U1.32, U1.48, U1.64, U6.2, U6.4, U6.13, U7.16, U8.8, U9.5, U9.6, U10.2
+3V3A: C8.1, C9.1, R18.1, R27.2, U1.28, U1.29
+5V: C1.1, J1.5, U10.3
+12V_HEAT: J1.1, J1.2, J11.1, R17.1
AS_ACG: C26.1, U9.1
AS_CS: U1.51, U9.8
AS_INP: C27.1, C28.1, L1.1, R26.1, U9.3
AS_IRQ: U1.62, U9.10
AS_MISO: U1.57, U9.12
AS_MOSI: U1.58, U9.13
AS_SCK: U1.56, U9.11
BL_PA10: R28.1, U1.44
BL_PB12: R29.1, U1.33
CROWN_BOOT0: J1.12, R25.1, U1.61
CROWN_IRQ: J1.10, U1.54
CROWN_NRST: C10.1, J1.11, J12.3, U1.7
GND: C1.2, C2.2, C3.2, C4.2, C5.2, C6.2, C7.2, C8.2, C9.2, C10.2, C11.2, C12.2, C13.2, C14.2, C15.2, C16.2, C17.2, C18.2, C22.2, C23.2, C24.2, C25.2, C26.2, C27.2, C28.2, C29.2, C34.2, D9.1, J1.3, J1.4, J1.6, J1.8, J6.2, J7.2, J8.2, J9.2, J10.2, J11.2, J12.5, L1.2, R1.2, R2.2, R3.2, R4.2, R13.2, R14.2, R15.2, R16.2, R19.2, R25.2, R26.2, U1.15, U1.27, U1.31, U1.47, U1.63, U2.3, U3.3, U4.3, U5.3, U6.9, U6.11, U7.1, U7.2, U7.3, U7.4, U7.5, U7.6, U7.7, U7.8, U8.4, U9.2, U9.4, U9.7, U9.9, U9.15, U9.16, U9.17, U10.1
I2C_SCL: J1.9, J10.4, U1.22, U6.1
I2C_SDA: J1.7, J10.3, U1.42, U6.16
MAG_CAP: C34.1, U6.10
MUX_S0: U1.59, U7.10
MUX_S1: U1.60, U7.9
PIEZO_IN: D9.3, J6.1, J7.1, J8.1, J9.1, R22.1
PIEZO_INV: C21.1, R22.2, R23.1, U8.6
PIEZO_OUT: C21.2, R23.2, R24.1, U8.7
RAIN_ADC: C22.1, R24.2, U1.18
SWCLK: J12.4, U1.50
SWDIO: J12.2, U1.49
TX_N: U1.52, U2.4, U3.4, U4.4, U5.4
TX_P: U1.38, U2.2, U3.2, U4.2, U5.2
US_AMP_FB: C20.1, R20.1, R21.1, U8.2
US_AMP_G: C19.1, R20.2
US_AMP_OUT: C20.2, R21.2, U1.13, U8.1
US_RX_MUX: U7.13, U8.3
US_VREF: C18.1, C19.2, R9.2, R10.2, R11.2, R12.2, R18.2, R19.1, U1.17, U8.5
VDRV: C13.1, C14.1, C15.1, C16.1, C17.1, R17.2, U2.6, U3.6, U4.6, U5.6
XD_EN_E: R14.1, U1.40, U3.1, U3.8
XD_EN_N: R13.1, U1.39, U2.1, U2.8
XD_EN_S: R15.1, U1.41, U4.1, U4.8
XD_EN_W: R16.1, U1.53, U5.1, U5.8
XD_E_A: D3.3, J3.1, R6.1
XD_E_B: D4.3, J3.2, R2.1
XD_E_OUT_A: D3.1, D3.2, U3.7
XD_E_OUT_B: D4.1, D4.2, U3.5
XD_E_RX: C31.2, R10.1, U7.14
XD_E_RXC: C31.1, R6.2
XD_N_A: D1.3, J2.1, R5.1
XD_N_B: D2.3, J2.2, R1.1
XD_N_OUT_A: D1.1, D1.2, U2.7
XD_N_OUT_B: D2.1, D2.2, U2.5
XD_N_RX: C30.2, R9.1, U7.12
XD_N_RXC: C30.1, R5.2
XD_S_A: D5.3, J4.1, R7.1
XD_S_B: D6.3, J4.2, R3.1
XD_S_OUT_A: D5.1, D5.2, U4.7
XD_S_OUT_B: D6.1, D6.2, U4.5
XD_S_RX: C32.2, R11.1, U7.15
XD_S_RXC: C32.1, R7.2
XD_W_A: D7.3, J5.1, R8.1
XD_W_B: D8.3, J5.2, R4.1
XD_W_OUT_A: D7.1, D7.2, U5.7
XD_W_OUT_B: D8.1, D8.2, U5.5
XD_W_RX: C33.2, R12.1, U7.11
XD_W_RXC: C33.1, R8.2
XTAL_IN: C11.1, U1.5, Y1.1
XTAL_OUT: C12.1, U1.6, Y1.2
