vbartusevicius/weather-station/hardware/layout/v1/probe/probe.kicad_pcb

## KiCad design hardware/layout/v1/probe/probe.kicad_pcb (2026-11-11)

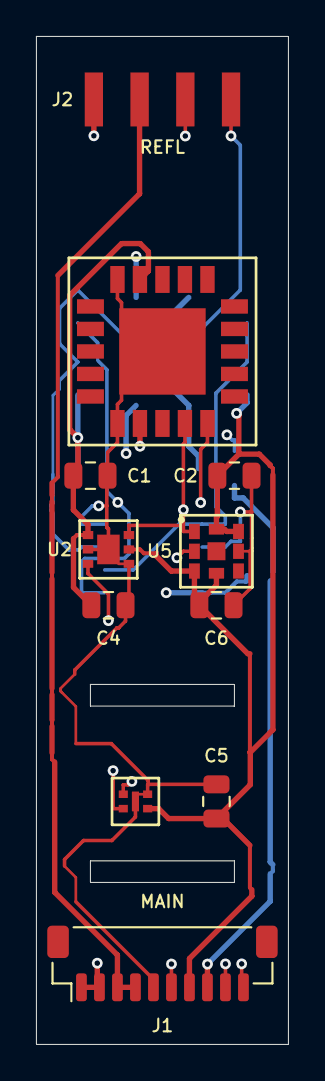
[picture p64: board probe.kicad_pcb from above]

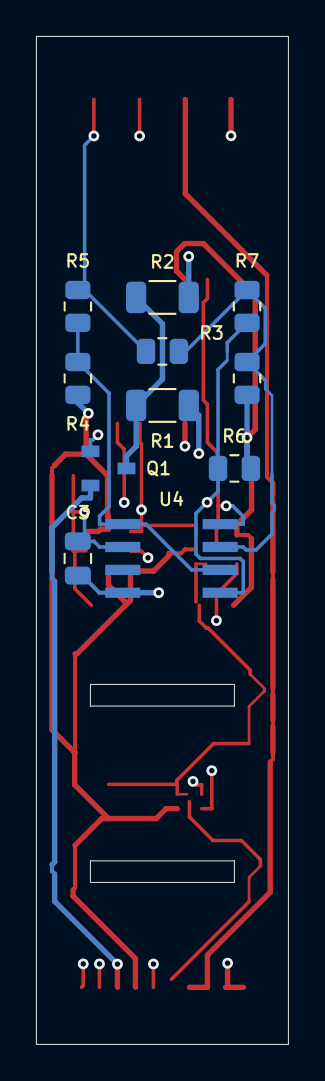
[picture p65: board probe.kicad_pcb from below]

Board: 4 copper layers, 14.0 x 56.0 mm, 22 parts (11 on the bottom side), 12 nets.

Parts:
C1: 10u 10V; C_0805_2012Metric
C2, C3, C4, C5, C6: 100n 50V; C_0805_2012Metric
J1: Main board; JST_SH_BM10B-SRSS-TB_1x10-1MP_P1.00mm_Vertical
J2: Reflector T-Socket SMD; HX_PM2.54-1x4P-RA-SMD
Q1: AO3400A; AOS_AO3400A_SOT-23
R1, R2: 680R; R_1206_3216Metric
R3, R4, R6: 10k; R_0805_2012Metric
R5: 51k; R_0805_2012Metric
R7: 470k; R_0805_2012Metric
TH1: 10k NTC; R_0805_2012Metric
U1: SCD41-D-R2; Sensirion_SCD41_LGA-20
U2: SGP41-D-R4; Sensirion_SGP41_DFN-6
U3: SHT40-AD1F-R2; Sensirion_SHT45_DFN-4
U4: LM2903DR2G; ON_LM393DR2G_SOIC-8
U5: BMP585; Bosch_BMP585_LGA-9

Connections:
+3V3_PROBE: C1.1, C2.1, C4.1, C5.1, C6.1, J1.7, R3.1, R4.1, R6.1, U1.7, U1.19, U2.1, U2.5, U3.3, U5.3, U5.4, U5.7, U5.8
+12V_HEAT: C3.1, J1.1, J1.2, J2.1, R1.1, R2.1, U4.8
CO2_GATE: Q1.1, R6.2, R7.1, U4.1
CO2_HEAT_RTN: J1.8, Q1.2
CO2_HEAT_SW: Q1.3, R1.2, R2.2
CO2_NTC: R3.2, R7.2, TH1.1, U4.3
CO2_VSET: R4.2, R5.1, U4.2, U4.5
GND: C1.2, C2.2, C3.2, C4.2, C5.2, C6.2, J1.5, J2.4, R5.2, TH1.2, U1.6, U1.20, U1.21, U2.2, U2.4, U2.7, U3.4, U3.5, U4.4, U4.6, U5.6
HEAT_SW: J1.3, J1.4, J2.2
I2C_SCL: J1.10, U1.9, U2.6, U3.2, U5.1
I2C_SDA: J1.9, U1.10, U2.3, U3.1, U5.2
NTC_SENSE: J1.6, J2.3
