vbartusevicius/weather-station/hardware/layout/v1/reflector/reflector.kicad_pcb

## KiCad design hardware/layout/v1/reflector/reflector.kicad_pcb (2026-11-11)

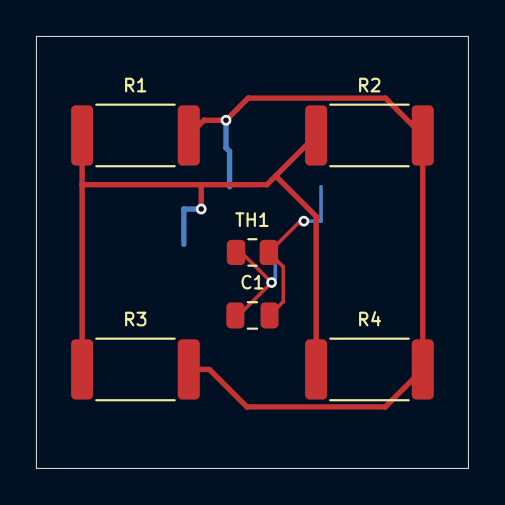
[picture p66: board reflector.kicad_pcb from above]

Board: 4 copper layers, 24.0 x 24.0 mm, 7 parts (1 on the bottom side), 4 nets.

Parts:
C1: 100n 50V; C_0805_2012Metric
J1: Probe T-Header SMD; HX_PZ2.54-1x4P-SMD
R1, R2, R3, R4: 120R; R_2512_6332Metric
TH1: 10k NTC; R_0805_2012Metric

Connections:
+12V_HEAT: J1.1, R1.1, R2.1, R3.1, R4.1
GND: C1.2, J1.4, TH1.2
HEAT_SW: J1.2, R1.2, R2.2, R3.2, R4.2
NTC_SENSE: C1.1, J1.3, TH1.1
