vbartusevicius/weather-station/hardware/layout/v1/dome_legacy/dome_legacy.kicad_pcb

## KiCad design hardware/layout/v1/dome_legacy/dome_legacy.kicad_pcb (2026-11-11, an earlier design)

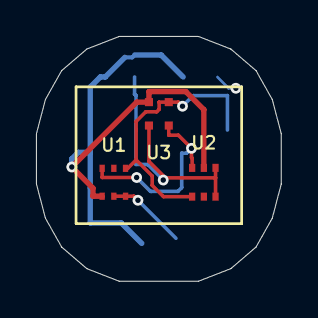
[picture p67: board dome_legacy.kicad_pcb from above]

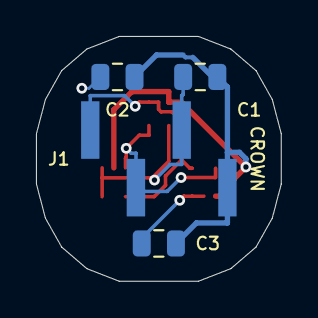
[picture p68: board dome_legacy.kicad_pcb from below]

Board: 4 copper layers, 13.6 x 13.6 mm, 7 parts (4 on the bottom side), 4 nets.

Parts:
C1, C2: 100n 50V; C_0805_2012Metric
C3: 1u 50V; C_0805_2012Metric
J1: CROWN_RISER; HX_PZ2.54-1x4P-SMD
U1: LTR-390UV-01; LiteOn_LTR-390UV-01
U2: TSL25911FN; AMS_TSL25911FN
U3: GUVB-C31SM; GenUV_GUVB-C31SM

Connections:
+3V3: C1.1, C2.1, C3.1, J1.1, U1.1, U2.5, U3.4
GND: C1.2, C2.2, C3.2, J1.2, U1.2, U1.3, U2.3, U2.4, U3.1
I2C_SCL: J1.4, U1.4, U2.1, U3.3
I2C_SDA: J1.3, U1.6, U2.6, U3.2
