vbartusevicius/weather-station/hardware/layout/v1/power/power.kicad_pcb

## KiCad design hardware/layout/v1/power/power.kicad_pcb (2026-11-11)

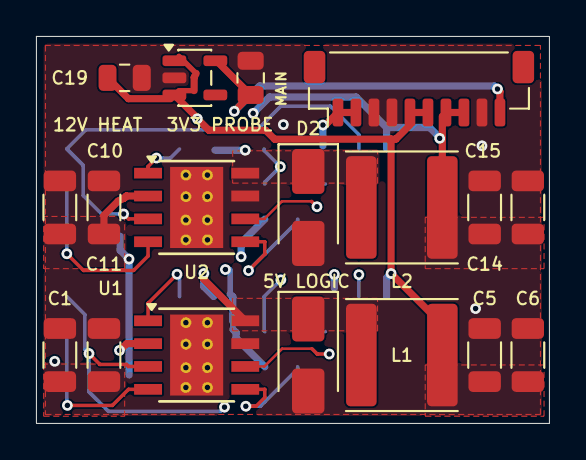
[picture p69: board power.kicad_pcb from above]

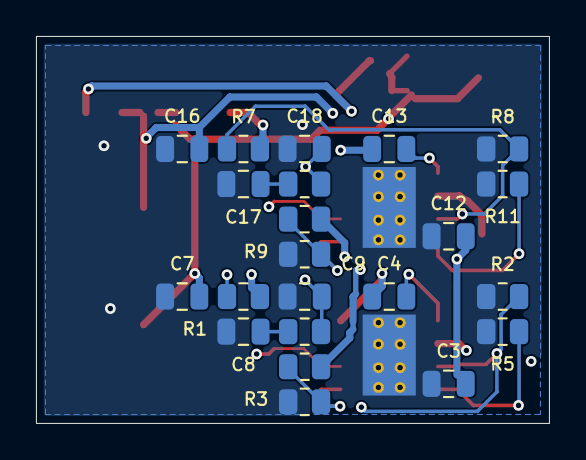
[picture p70: board power.kicad_pcb from below]

Board: 4 copper layers, 28.5 x 21.5 mm, 40 parts (22 on the bottom side), 19 nets.

Parts:
C1, C2, C10, C11: 2u2 100V; C_1206_3216Metric
C3, C12: 100n 100V; C_0805_2012Metric
C4, C7, C13, C16: 100n 50V; C_0805_2012Metric
C5, C6: 47u 10V; C_1206_3216Metric
C8: 33n 50V; C_0805_2012Metric
C9, C18: 68p C0G 50V; C_0805_2012Metric
C14, C15: 22u 25V; C_1206_3216Metric
C17: 18n 50V; C_0805_2012Metric
C19: 1u 50V; C_0805_2012Metric
C20: 10u 10V; C_0805_2012Metric
D1, D2: B360A; D_SMA
J1: Main board; JST_SH_BM10B-SRSS-TB_1x10-1MP_P1.00mm_Vertical
L1: 8.2uH; L_Sunlord_SWPA6045S
L2: 22uH; L_Sunlord_SWPA6045S
R1, R7: 511k; R_0805_2012Metric
R2, R8: 82k5; R_0805_2012Metric
R3: 53k6; R_0805_2012Metric
R4: 10k2; R_0805_2012Metric
R5, R11: 130k; R_0805_2012Metric
R6, R12: 6k49; R_0805_2012Metric
R9: 140k; R_0805_2012Metric
R10: 10k; R_0805_2012Metric
U1, U2: TPS54360DDAR; TI_SO-PowerPAD-8_ThermalVias
U3: AP2112K-3.3; SOT-23-5

Connections:
+3V3_PROBE: C20.1, J1.10, U3.5
+5V: C5.1, C6.1, C7.1, C19.1, J1.5, J1.6, L1.2, R3.1, U3.1, U3.3
+12V_HEAT: C14.1, C15.1, C16.1, J1.7, J1.8, L2.2, R9.1
GND: C1.2, C2.2, C3.2, C5.2, C6.2, C7.2, C8.2, C9.2, C10.2, C11.2, C12.2, C14.2, C15.2, C16.2, C17.2, C18.2, C19.2, C20.2, D1.2, D2.2, J1.3, J1.4, J1.9, R2.2, R4.2, R5.2, R8.2, R10.2, R11.2, U1.7, U1.9, U2.7, U2.9, U3.2
HEAT_BST: C13.1, U2.1
HEAT_CC: C17.1, R12.2
HEAT_COMP: C18.1, R12.1, U2.6
HEAT_EN: R7.2, R8.1, U2.3
HEAT_FB: R9.2, R10.1, U2.5
HEAT_RT: R11.1, U2.4
HEAT_SW: C13.2, D2.1, L2.1, U2.8
LOGIC_BST: C4.1, U1.1
LOGIC_CC: C8.1, R6.2
LOGIC_COMP: C9.1, R6.1, U1.6
LOGIC_EN: R1.2, R2.1, U1.3
LOGIC_FB: R3.2, R4.1, U1.5
LOGIC_RT: R5.1, U1.4
LOGIC_SW: C4.2, D1.1, L1.1, U1.8
VIN_PROT: C1.1, C2.1, C3.1, C10.1, C11.1, C12.1, J1.1, J1.2, R1.1, R7.1, U1.2, U2.2
