vbartusevicius/weather-station/hardware/layout/v1/dome/dome.kicad_pcb

## KiCad design hardware/layout/v1/dome/dome.kicad_pcb (2026-11-11)

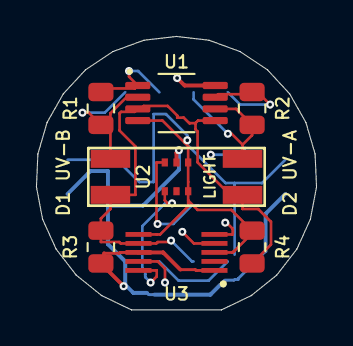
[picture p71: board dome.kicad_pcb from above]

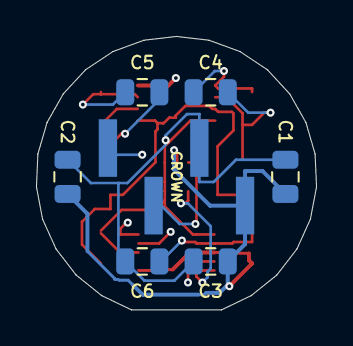
[picture p72: board dome.kicad_pcb from below]

Board: 4 copper layers, 15.6 x 15.2 mm, 16 parts (7 on the bottom side), 9 nets.

Parts:
C1, C2, C3: 100n 50V; C_0805_2012Metric
C4: 10n 50V; C_0805_2012Metric
C5: 22n 50V; C_0805_2012Metric
C6: 1u 50V; C_0805_2012Metric
D1: GUVB-C21SD; Genicom_COB2418
D2: GUVA-C22SD; Genicom_COB2418
J1: CROWN_RISER; HX_PZ2.54-1x4P-SMD
R1: 10M; R_0805_2012Metric
R2: 4M7; R_0805_2012Metric
R3: 100k; R_0805_2012Metric
R4: 10k; R_0805_2012Metric
U1: TLV9062IDGKR; TI_TLV9062_VSSOP-8
U2: TSL25911FN; AMS_TSL25911FN
U3: ADS1115IDGSR; TI_ADS1115_VSSOP-10

Connections:
+3V3: C1.1, C2.1, C3.1, J1.1, R3.1, U1.8, U2.5, U3.1, U3.8
GND: C1.2, C2.2, C3.2, C6.2, J1.2, R4.2, U1.4, U2.3, U2.4, U3.3, U3.6
I2C_SCL: J1.4, U2.1, U3.10
I2C_SDA: J1.3, U2.6, U3.9
UVA_IN: C5.1, D2.2, R2.1, U1.6
UVA_OUT: C5.2, R2.2, U1.7, U3.5
UVB_IN: C4.1, D1.2, R1.1, U1.2
UVB_OUT: C4.2, R1.2, U1.1, U3.4
UV_VB: C6.1, D1.1, D2.1, R3.2, R4.1, U1.3, U1.5, U3.7
