vbartusevicius/weather-station/station/tests/unit/test_station/test_main.cpp

#include <algorithm>
#include <cmath>
#include <cstdio>
#include <cstring>
#include <functional>
#include <string>
#include <vector>
#if __has_include(<unity.h>)
#include <unity.h>
#else
#include <cassert>
#define UNITY_BEGIN() 0
#define UNITY_END() 0
#define RUN_TEST(fn) fn()
#define TEST_ASSERT_TRUE(cond) assert(cond)
#define TEST_ASSERT_FALSE(cond) assert(!(cond))
#define TEST_ASSERT_NULL(ptr) assert((ptr) == nullptr)
#define TEST_ASSERT_NOT_NULL(ptr) assert((ptr) != nullptr)
#define TEST_ASSERT_EQUAL(exp, act) assert((exp) == (act))
#define TEST_ASSERT_EQUAL_INT(exp, act) assert((exp) == (act))
#define TEST_ASSERT_EQUAL_UINT8(exp, act) assert((exp) == (act))
#define TEST_ASSERT_EQUAL_UINT16(exp, act) assert((exp) == (act))
#define TEST_ASSERT_EQUAL_UINT32(exp, act) assert((exp) == (act))
#define TEST_ASSERT_EQUAL_STRING(exp, act) assert(std::strcmp((exp), (act)) == 0)
#define TEST_ASSERT_FLOAT_WITHIN(delta, exp, act) \
    do { const double a_ = (act), e_ = (exp); assert(a_ - e_ <= (delta) && e_ - a_ <= (delta)); } while (0)
#endif

#include <ArduinoJson.h>

#include "../../../src/airquality/AirQuality.hpp"
#include "../../../src/airquality/GasIndex.hpp"
#include "../../../src/astro/Astronomy.hpp"
#include "../../../src/calibration/Calibration.hpp"
#include "../../../src/conditioning/Conditioners.hpp"
#include "../../../src/core/Pipeline.hpp"
#include "../../../src/crown/CrownDecode.hpp"
#include "../../../src/crown/StmI2cBootloader.hpp"
#include "../../../src/environment/MetCalculations.hpp"
#include "../../../src/environment/UvPhotodiodes.hpp"
#include "../../../src/environment/Mmc5983.hpp"
#include "../../../src/firmware/ButtonController.hpp"
#include "../../../src/heater/DeIcingHeater.hpp"
#include "../../../src/history/Climate.hpp"
#include "../../../src/history/HistoryStore.hpp"
#include "../../../src/history/TieredHistory.hpp"
#include "../../../src/quality/Quality.hpp"
#include "../../../src/rain/HapticRain.hpp"
#include "../../../src/rs485/Rs485Protocol.hpp"
#include "../../../src/telemetry/HomeAssistantMqtt.hpp"
#include "../../../src/wind/UltrasonicWind.hpp"
#include "../../../src/wind/WindCalibration.hpp"

using station::airquality::AirQualityEvaluator;
using station::airquality::AirQualityInput;
using station::airquality::AqiLevel;
using station::astro::Astronomy;
using station::core::DerivedState;
using station::core::EventQueues;
using station::core::Pipeline;
using station::core::RawState;
using station::core::StationConfig;
using station::environment::EnvLongevityManager;
using station::environment::MetCalculator;
using station::heater::DeIcingHeaterController;
using station::heater::HeaterSensorInput;
using station::heater::HeaterState;
using station::history::Metric;
using station::history::Tier;
using station::history::TieredHistory;
using station::rain::HapticRainProcessor;
using station::rain::PrecipitationType;
using station::rain::RainImpactEvent;
using station::rs485::CommandType;
using station::rs485::Rs485Protocol;
using station::telemetry::TelemetryFormatter;
using station::telemetry::WifiInfo;
using station::wind::ImuCompassReading;
using station::wind::TofQuad;
using station::wind::UltrasonicWindSolver;
using station::wind::WmoWindAggregator;

void setUp(void) {}
void tearDown(void) {}

namespace {
// Vilnius, 2025-06-21 (EEST, UTC+3)
constexpr double kLat = 54.6872;
constexpr double kLon = 25.2797;
constexpr std::int64_t kSolsticeNoonUtc = 1750507200;  // 2025-06-21 12:00:00 UTC

StationConfig vilnius() {
    StationConfig c{};
    c.location_set = true;
    c.latitude_deg = kLat;
    c.longitude_deg = kLon;
    c.altitude_m = 112.0F;
    return c;
}

// Fill every sensor with a plausible steady value at monotonic time `now_ms`.
void fill_steady(RawState& r, std::uint32_t now_ms) {
    r.now_ms = now_ms;
    r.thermo.temp_c.set(20.0F, now_ms);
    r.thermo.rh_pct.set(50.0F, now_ms);
    r.baro.pressure_hpa.set(1000.0F, now_ms);
    r.baro.ripple_pa.set(0.1F, now_ms);
    station::core::WindSecond w{};
    w.v_east_m_s = 5.0F;   // air moving east => wind FROM the west (270)
    w.v_north_m_s = 0.0F;
    w.speed_mean_m_s = 5.0F;
    w.sound_speed_m_s = 343.4F;
    w.virtual_temp_c = 20.6F;
    w.samples = 4;
    r.wind.second.set(w, now_ms);
    r.air.pm1_ug_m3.set(3.0F, now_ms);
    r.air.pm25_ug_m3.set(6.0F, now_ms);
    r.air.pm10_ug_m3.set(12.0F, now_ms);
    r.air.sgp_sraw_voc.set(30000, now_ms);
    r.air.sgp_sraw_nox.set(16000, now_ms);
    r.air.co2_ppm.set(420.0F, now_ms);
    r.power.vin_v.set(24.0F, now_ms);
    r.power.reflector_c.set(18.0F, now_ms);
    r.power.rain_adc_ok = true;
    station::core::VibrationSecond v{};
    v.pga_mg = 0.5F;
    v.ppv_mm_s = 0.05F;
    v.dominant_hz = 18.0F;
    r.imu.vibration.set(v, now_ms);
}

JsonDocument parse(const std::string& s) {
    JsonDocument doc;
    deserializeJson(doc, s);
    return doc;
}
}  // namespace

void test_ultrasonic_zero_wind_and_virtual_temp(void) {
    // D=54 mm, H=48 mm => L_eff = 110.15 mm => calm ToF at 20 C (343.2 m/s) is 320.95 us
    const TofQuad calm{320.95F, 320.95F, 320.95F, 320.95F};
    const auto s = UltrasonicWindSolver::solve(calm);
    TEST_ASSERT_TRUE(s.valid);
    TEST_ASSERT_FLOAT_WITHIN(0.01F, 0.0F, s.speed_m_s);
    TEST_ASSERT_FLOAT_WITHIN(1.5F, 343.2F, s.sound_speed_m_s);
    TEST_ASSERT_FLOAT_WITHIN(2.0F, 20.0F, s.acoustic_temp_c);
}

void test_ultrasonic_soft_wind_and_cycle_slip_lock_up_to_60ms(void) {
    // 1. Soft wind: 0.08 m/s (Δt = 73 ns => t_NS = 320.9135 us, t_SN = 320.9865 us)
    const TofQuad soft_breeze{320.9135F, 320.9865F, 320.95F, 320.95F};
    const auto soft = UltrasonicWindSolver::solve(soft_breeze);
    TEST_ASSERT_TRUE(soft.valid);
    TEST_ASSERT_FLOAT_WITHIN(0.015F, 0.08F, soft.speed_m_s);
    TEST_ASSERT_FLOAT_WITHIN(1.0F, 0.0F, soft.direction_deg);

    // 2. Storm / Hurricane wind: ~45 m/s where Δt = 41.3 us (> 1.6x 25.0 us carrier period!)
    // Without U4B envelope lock, zero-crossing alone would slip by 25.0 us; with env_*_us it locks cleanly:
    TofQuad storm{};
    storm.t_ns_us = 301.5F + 25.0F;  // Slipped by +1 carrier period (25 us)
    storm.env_ns_us = 301.5F;        // Comparator B envelope gate identifies the true 301.5 us cycle
    storm.t_sn_us = 342.8F - 25.0F;  // Slipped by -1 carrier period (-25 us)
    storm.env_sn_us = 342.8F;        // Comparator B envelope gate identifies the true 342.8 us cycle
    storm.t_ew_us = 320.95F;
    storm.t_we_us = 320.95F;
    const auto locked = UltrasonicWindSolver::solve(storm);
    TEST_ASSERT_TRUE(locked.valid);
    TEST_ASSERT_FLOAT_WITHIN(1.5F, 44.8F, locked.speed_m_s);
    TEST_ASSERT_FLOAT_WITHIN(1.0F, 0.0F, locked.direction_deg);
}

void test_ultrasonic_cardinal_directions_and_sound_cancellation(void) {
    // Wind blowing FROM North TO South (v_north < 0 => t_NS shorter, t_SN longer)
    const TofQuad north_wind{301.0F, 309.0F, 305.0F, 305.0F};
    const auto n = UltrasonicWindSolver::solve(north_wind);
    TEST_ASSERT_TRUE(n.valid);
    TEST_ASSERT_TRUE(n.speed_m_s > 5.0F);
    TEST_ASSERT_FLOAT_WITHIN(1.0F, 0.0F, n.direction_deg);

    // Wind blowing FROM East TO West (v_east < 0 => t_EW shorter, t_WE longer)
    const TofQuad east_wind{305.0F, 305.0F, 302.0F, 308.0F};
    const auto e = UltrasonicWindSolver::solve(east_wind);
    TEST_ASSERT_TRUE(e.valid);
    TEST_ASSERT_FLOAT_WITHIN(1.0F, 90.0F, e.direction_deg);

    // Out-of-bounds ToF rejected as invalid
    const TofQuad invalid{50.0F, 305.0F, 305.0F, 305.0F};
    TEST_ASSERT_FALSE(UltrasonicWindSolver::solve(invalid).valid);
}

void test_ultrasonic_auto_north_and_tilt_compensation(void) {
    const TofQuad north_rel{301.0F, 309.0F, 305.0F, 305.0F};
    ImuCompassReading imu{};
    imu.mag_x_ut = 20.0F;
    imu.mag_y_ut = 0.0F;  // Rotated +90 deg East
    const auto s = UltrasonicWindSolver::solve(north_rel, imu);
    TEST_ASSERT_TRUE(s.valid);
    TEST_ASSERT_FLOAT_WITHIN(1.0F, 90.0F, s.north_offset_deg);
    TEST_ASSERT_FLOAT_WITHIN(1.5F, 90.0F, s.direction_deg);
}

void test_wmo_wind_3s_gust_10min_mean_and_direction_across_north(void) {
    WmoWindAggregator agg;
    // 10 minutes of steady 5 m/s from the north (air flows south: v_north = -5)
    for (int i = 0; i < 600; ++i) {
        agg.push_second(true, 0.0F, -5.0F, 5.0F);
    }
    // A single 1-s spike of 15 m/s: the WMO gust is the max 3-s MEAN, i.e. (15 + 5 + 5) / 3
    agg.push_second(true, 0.0F, -15.0F, 15.0F);
    agg.push_second(true, 0.0F, -5.0F, 5.0F);
    const auto s = agg.summary();
    TEST_ASSERT_TRUE(s.valid);
    TEST_ASSERT_FLOAT_WITHIN(0.05F, 8.33F, s.gust_m_s);
    TEST_ASSERT_FLOAT_WITHIN(0.05F, 5.0F, s.lull_m_s);
    TEST_ASSERT_FLOAT_WITHIN(0.05F, 5.02F, s.avg_10m_m_s);
    TEST_ASSERT_TRUE(s.dir_valid);
    TEST_ASSERT_TRUE(s.dir_10m_deg > 359.0F || s.dir_10m_deg < 1.0F);
    TEST_ASSERT_FLOAT_WITHIN(0.1F, 100.0F, s.rose_freq_pct[0]);

    // Vector mean across north: 355 / 5 / 358 deg must average near 0, not 180
    WmoWindAggregator n;
    const float dirs[3] = {355.0F, 5.0F, 358.0F};
    for (float d : dirs) {
        const float rad = d * 3.14159265F / 180.0F;
        n.push_second(true, -6.0F * std::sin(rad), -6.0F * std::cos(rad), 6.0F);
    }
    const auto ns = n.summary();
    TEST_ASSERT_TRUE(ns.dir_10m_deg > 355.0F || ns.dir_10m_deg < 5.0F);

    // A missing second breaks the 3-s mean: no "instantaneous" wind is published
    n.push_second(false, 0.0F, 0.0F, 0.0F);
    TEST_ASSERT_FALSE(n.summary().valid);

    // Moist-air acoustic virtual temperature correction (30 C / 85 % RH -> ~2.5 C lower)
    const float t_true = UltrasonicWindSolver::correct_acoustic_temp_for_humidity(30.0F, 85.0F, 1013.25F);
    TEST_ASSERT_TRUE(t_true < 28.2F && t_true > 26.0F);
}

void test_haptic_rain_rolling_rate_event_and_daily(void) {
    HapticRainProcessor rain;
    TEST_ASSERT_FLOAT_WITHIN(1e-6F, 0.0F, rain.process_impact(RainImpactEvent{120, 80, 200, 0.01F}));
    TEST_ASSERT_FLOAT_WITHIN(1e-6F, 0.0F, rain.process_impact(RainImpactEvent{450, 90, 950, 0.35F}));  // mast shake
    TEST_ASSERT_EQUAL_UINT32(1, rain.metrics().rejected_vibrations);

    // 20 drops per second for 60 s: the rate is the rolling 60-s depth x 60
    float depth = 0.0F;
    for (int s = 0; s < 60; ++s) {
        for (int i = 0; i < 20; ++i) {
            depth += rain.process_impact(RainImpactEvent{620, 180, 220, 0.02F});
        }
        rain.tick_second();
    }
    TEST_ASSERT_TRUE(rain.metrics().is_raining);
    TEST_ASSERT_FLOAT_WITHIN(0.001F, depth * 60.0F, rain.metrics().rate_mm_h);
    TEST_ASSERT_FLOAT_WITHIN(0.001F, depth, rain.metrics().daily_mm);
    TEST_ASSERT_EQUAL_UINT32(1200, rain.metrics().drop_count);

    // Hail: sharp high-amplitude impact
    rain.process_impact(RainImpactEvent{1850, 180, 110, 0.04F});
    rain.tick_second();
    TEST_ASSERT_EQUAL_UINT32(1, rain.metrics().hail_hits);
    TEST_ASSERT_EQUAL(PrecipitationType::Hail, rain.metrics().state);
    TEST_ASSERT_TRUE(rain.metrics().max_hail_diameter_mm >= 5.0F && rain.metrics().max_hail_diameter_mm <= 15.0F);

    // Rate decays to 0 after 60 dry seconds; the shower ends after 15 dry minutes
    for (int s = 0; s < 61; ++s) {
        rain.tick_second();
    }
    TEST_ASSERT_FLOAT_WITHIN(1e-6F, 0.0F, rain.metrics().rate_mm_h);
    TEST_ASSERT_EQUAL(PrecipitationType::None, rain.metrics().state);
    TEST_ASSERT_TRUE(rain.metrics().is_raining);
    for (int s = 0; s < 15 * 60; ++s) {
        rain.tick_second();
    }
    TEST_ASSERT_FALSE(rain.metrics().is_raining);
    TEST_ASSERT_FLOAT_WITHIN(1e-6F, 0.0F, rain.metrics().event_mm);
    TEST_ASSERT_TRUE(rain.metrics().daily_mm > 0.0F);
    rain.new_day();
    TEST_ASSERT_FLOAT_WITHIN(1e-6F, 0.0F, rain.metrics().daily_mm);

    // Wind-driven oblique impacts and a hot PZT dome both reduce the attributed depth
    HapticRainProcessor a, b, c, e;
    TEST_ASSERT_TRUE(a.process_impact(RainImpactEvent{600, 206, 200, 0.01F, 12.0F, 20.0F}) <
                     b.process_impact(RainImpactEvent{600, 206, 200, 0.01F, 0.0F, 20.0F}));
    TEST_ASSERT_TRUE(c.process_impact(RainImpactEvent{600, 206, 200, 0.01F, 0.0F, 45.0F}) <
                     e.process_impact(RainImpactEvent{600, 206, 200, 0.01F, 0.0F, 0.0F}));
}

void test_meteorological_formulas(void) {
    TEST_ASSERT_FLOAT_WITHIN(0.1F, 9.3F, MetCalculator::dew_point_c(20.0F, 50.0F));
    TEST_ASSERT_FLOAT_WITHIN(0.3F, 13.7F, MetCalculator::wet_bulb_c(20.0F, 50.0F));
    TEST_ASSERT_FLOAT_WITHIN(0.1F, 8.6F, MetCalculator::absolute_humidity_g_m3(20.0F, 50.0F));
    TEST_ASSERT_FLOAT_WITHIN(0.02F, 1.17F, MetCalculator::vapor_pressure_deficit_kpa(20.0F, 50.0F));
    TEST_ASSERT_FLOAT_WITHIN(5.0F, 1334.0F, MetCalculator::cloud_base_lcl_m(20.0F, 9.3F));
    TEST_ASSERT_FLOAT_WITHIN(0.01F, 1.20F, MetCalculator::moist_air_density_kg_m3(1013.25F, 20.0F, 50.0F));
    // Hypsometric QNH: 1000 hPa at 112 m, 15 C -> ~1013.3 hPa
    TEST_ASSERT_FLOAT_WITHIN(0.3F, 1013.3F, MetCalculator::sea_level_pressure_hpa(1000.0F, 15.0F, 112.0F));
    // Barometer port suction in a 25 m/s gale is compensated (+0.84 hPa with the 0.22 port coefficient)
    TEST_ASSERT_FLOAT_WITHIN(0.3F, 1000.84F, MetCalculator::compensate_wind_dynamic_pressure_hpa(1000.0F, 25.0F, 15.0F));
    TEST_ASSERT_TRUE(MetCalculator::wind_chill_c(-5.0F, 8.0F) < -10.0F);
    TEST_ASSERT_TRUE(MetCalculator::heat_index_c(33.0F, 75.0F) > 40.0F);
    // Feels-like: shade apparent temperature in the mild range (no unmeasured solar term)
    TEST_ASSERT_FLOAT_WITHIN(0.05F, 18.45F, MetCalculator::feels_like_c(20.0F, 50.0F, 2.0F));

    // Cloud cover against a real clear-sky reference
    TEST_ASSERT_FLOAT_WITHIN(1.0F, 0.0F, MetCalculator::estimate_cloud_cover_pct(880.0F, 880.0F));
    TEST_ASSERT_FLOAT_WITHIN(1.0F, 100.0F, MetCalculator::estimate_cloud_cover_pct(200.0F, 880.0F));
    TEST_ASSERT_TRUE(MetCalculator::estimate_cloud_cover_pct(600.0F, 880.0F) > 50.0F);

    // Night sky: 0.0008 lx -> ~21.6 mag/arcsec^2 (rural dark sky)
    const float sqm = MetCalculator::sky_quality_mpsas(0.0008F);
    TEST_ASSERT_FLOAT_WITHIN(0.1F, 21.57F, sqm);
    TEST_ASSERT_TRUE(MetCalculator::bortle_class_from_sqm(sqm) <= 3);

    TEST_ASSERT_TRUE(MetCalculator::sager_rain_probability_pct(992.0F, -4.2F, -25.0F, 92.0F, false) >
                     MetCalculator::sager_rain_probability_pct(1020.0F, 0.4F, 15.0F, 15.0F, false));
    TEST_ASSERT_FLOAT_WITHIN(0.01F, 5.78F, MetCalculator::thunder_distance_km(16.8F, 344.0F));
    TEST_ASSERT_EQUAL_STRING("Heavy Truck / Train", MetCalculator::classify_vibration_source(5.2F, 24.0F, 3.0F));
    TEST_ASSERT_EQUAL_STRING("Wind Sway", MetCalculator::classify_vibration_source(5.2F, 3.0F, 15.0F));
    TEST_ASSERT_EQUAL_STRING("MMI II-III", MetCalculator::mmi_from_pga(5.2F));

    // LTR-390 ALS conversion and TSL25911 -> LTR-390 handoff above 80 klx
    const float ltr_lux = MetCalculator::lux_from_ltr390_als(400000U, 3.0F, 100.0F);
    TEST_ASSERT_FLOAT_WITHIN(10.0F, 80000.0F, ltr_lux);
    TEST_ASSERT_FLOAT_WITHIN(10.0F, 80000.0F, MetCalculator::fuse_uv_hardened_lux(55000.0F, ltr_lux));

    station::environment::DomeOpticalScheduler sched{};
    const auto c1 = sched.tick_500ms(60000U);
    TEST_ASSERT_TRUE(c1.read_ltr390_uvs);
    TEST_ASSERT_EQUAL(station::environment::Tsl2591Gain::Low1x, c1.tsl2591_next_gain);

    TEST_ASSERT_EQUAL(station::environment::PressureTrend::FallingRapidly, MetCalculator::classify_pressure_trend(-3.8F));
    TEST_ASSERT_EQUAL_STRING("Showery, Becoming Unsettled",
                             MetCalculator::zambretti_forecast(1014.2F, station::environment::PressureTrend::Falling, 190.0F));
}

void test_air_quality_pm_only_aqi_nowcast_and_eaqi(void) {
    AirQualityInput clean{3.0F, 5.4F, 12.0F, 95, 2, 418, 50.0F, 1013.25F};
    const auto r_clean = AirQualityEvaluator::evaluate(clean);
    TEST_ASSERT_EQUAL(AqiLevel::Good, r_clean.level);
    TEST_ASSERT_EQUAL_UINT8(1, r_clean.eu_eaqi);

    // A high NOx index no longer inflates the EPA AQI (relative Sensirion index, not an EPA pollutant)
    AirQualityInput traffic{4.0F, 6.0F, 15.0F, 140, 180, 460, 55.0F, 1013.25F};
    const auto r_nox = AirQualityEvaluator::evaluate(traffic);
    TEST_ASSERT_EQUAL_STRING("PM2.5", r_nox.dominant_pollutant);
    TEST_ASSERT_EQUAL(AqiLevel::Good, r_nox.level);

    // Fog (92 % RH): hygroscopic water growth is removed from PM2.5
    AirQualityInput foggy{10.0F, 28.0F, 42.0F, 90, 2, 420, 92.0F, 980.0F};
    const auto r_fog = AirQualityEvaluator::evaluate(foggy);
    TEST_ASSERT_TRUE(r_fog.dry_pm2_5_ug_m3 < 8.5F);
    TEST_ASSERT_EQUAL_UINT16(420, r_fog.pressure_comp_co2_ppm);  // no double pressure correction

    // EPA NowCast: steady 12 h -> equals the hourly mean; a fresh spike is weighted toward recent hours
    float flat[12];
    bool all[12];
    for (int i = 0; i < 12; ++i) {
        flat[i] = 10.0F;
        all[i] = true;
    }
    float nc = 0.0F;
    TEST_ASSERT_TRUE(AirQualityEvaluator::nowcast(flat, all, 12, nc));
    TEST_ASSERT_FLOAT_WITHIN(0.01F, 10.0F, nc);
    float spike[12] = {40.0F, 10, 10, 10, 10, 10, 10, 10, 10, 10, 10, 10};
    TEST_ASSERT_TRUE(AirQualityEvaluator::nowcast(spike, all, 12, nc));
    TEST_ASSERT_TRUE(nc > 20.0F && nc < 40.0F);
    bool sparse[12] = {true, false, false};
    TEST_ASSERT_FALSE(AirQualityEvaluator::nowcast(flat, sparse, 12, nc));

    TEST_ASSERT_EQUAL_UINT8(1, AirQualityEvaluator::eaqi_band(5.0F, 15.0F));
    TEST_ASSERT_EQUAL_UINT8(4, AirQualityEvaluator::eaqi_band(30.0F, 15.0F));
    TEST_ASSERT_EQUAL_UINT8(5, AirQualityEvaluator::eaqi_band(5.0F, 120.0F));
}

void test_astronomy_sun_moon_and_clear_sky(void) {
    const int off = 3 * 3600;
    const auto rs = Astronomy::sun_rise_set(kSolsticeNoonUtc, off, kLat, kLon);
    TEST_ASSERT_TRUE(rs.has_rise && rs.has_set);
    TEST_ASSERT_FLOAT_WITHIN(3.0F, 4 * 60 + 42, rs.rise_min);   // 04:42 EEST
    TEST_ASSERT_FLOAT_WITHIN(3.0F, 22 * 60 + 0, rs.set_min);    // 22:00 EEST
    const auto noon = Astronomy::sun(kSolsticeNoonUtc - 6120, kLat, kLon);  // solar noon 10:18 UTC
    TEST_ASSERT_FLOAT_WITHIN(0.2F, 58.75F, noon.altitude_deg);
    TEST_ASSERT_FLOAT_WITHIN(3.0F, 180.0F, noon.azimuth_deg);

    const auto full = Astronomy::moon(1759808820, kLat, kLon);  // full moon 2025-10-07 03:47 UTC
    TEST_ASSERT_TRUE(full.illumination > 0.99F);
    TEST_ASSERT_EQUAL_STRING("Full Moon", Astronomy::moon_phase_name(full));
    const auto fq = Astronomy::moon(1761754860, kLat, kLon);   // first quarter 2025-10-29 16:21 UTC
    TEST_ASSERT_FLOAT_WITHIN(0.03F, 0.5F, fq.illumination);
    TEST_ASSERT_TRUE(fq.waxing);

    TEST_ASSERT_FLOAT_WITHIN(10.0F, 879.0F, Astronomy::clear_sky_ghi_w_m2(58.8F));
    TEST_ASSERT_FLOAT_WITHIN(0.01F, 0.0F, Astronomy::clear_sky_ghi_w_m2(-3.0F));
    // The S2 tide is ~0.3 hPa per 3 h at mid latitudes, smaller toward the poles
    TEST_ASSERT_TRUE(std::fabs(Astronomy::solar_tide_3h_hpa(kSolsticeNoonUtc, kLat, kLon)) < 0.5F);
    TEST_ASSERT_TRUE(std::fabs(Astronomy::solar_tide_3h_hpa(kSolsticeNoonUtc, 0.0, kLon)) >
                     std::fabs(Astronomy::solar_tide_3h_hpa(kSolsticeNoonUtc, 70.0, kLon)));
}

void test_tiered_history_rollup_gaps_and_persistence(void) {
    static_assert(sizeof(station::history::Slot) == 16, "slot layout");
    TieredHistory h;
    // Two hours of 1-s samples: temperature ramps 10 -> ~17.2 C, 0.01 mm of rain per second
    for (std::int64_t t = 0; t < 7200; ++t) {
        h.advance(t / 60, t / 3600, t / 86400);
        h.add(Metric::TempC, 10.0F + static_cast<float>(t) * 0.001F);
        h.add(Metric::RainMm, 0.01F);
    }
    float v = 0.0F;
    // Closed minutes hold 60 samples each; minute 119 is still running, newest closed = 7080..7139 s
    TEST_ASSERT_TRUE(h.slot(Metric::TempC, Tier::Minute, 59).value(station::history::Agg::Mean, v));
    TEST_ASSERT_FLOAT_WITHIN(0.002F, 10.0F + 7109.5F * 0.001F, v);
    TEST_ASSERT_EQUAL_UINT16(60, h.slot(Metric::TempC, Tier::Minute, 59).n);
    // The newest closed hour (0..3599 s) sums 3600 x 0.01 mm
    TEST_ASSERT_TRUE(h.slot(Metric::RainMm, Tier::Hour, 23).value(station::history::Agg::Sum, v));
    TEST_ASSERT_FLOAT_WITHIN(0.01F, 36.0F, v);
    // 24-h window min / max include the closed hours plus the running accumulator
    TEST_ASSERT_TRUE(h.window_min(Metric::TempC, Tier::Hour, 23, v));
    TEST_ASSERT_FLOAT_WITHIN(0.001F, 10.0F, v);
    TEST_ASSERT_TRUE(h.window_max(Metric::TempC, Tier::Hour, 23, v));
    TEST_ASSERT_FLOAT_WITHIN(0.002F, 17.199F, v);
    // Today's running accumulator = everything since the day started
    TEST_ASSERT_TRUE(h.current(Metric::RainMm, Tier::Day).value(station::history::Agg::Sum, v));
    TEST_ASSERT_FLOAT_WITHIN(0.05F, 72.0F, v);

    // A 10-minute outage leaves 10 empty minute slots (no fake data)
    h.advance(7200 / 60 + 10, 7200 / 3600, 0);
    TEST_ASSERT_EQUAL_UINT16(0, h.slot(Metric::TempC, Tier::Minute, 59).n);
    TEST_ASSERT_EQUAL_UINT16(0, h.slot(Metric::TempC, Tier::Minute, 51).n);
    TEST_ASSERT_EQUAL_UINT16(60, h.slot(Metric::TempC, Tier::Minute, 49).n);

    // Closed hours / days go to the flash store; after a reboot 3 hours later the 24-h RAM cache comes back from it
    station::history::MemFlash flash(0x60000);
    station::history::HistoryStore store;
    TEST_ASSERT_TRUE(store.begin(&flash));
    std::int64_t idx = 0;
    std::array<station::history::Slot, station::history::kMetricCount> slots{};
    TEST_ASSERT_TRUE(h.take_closed(Tier::Hour, idx, slots));   // hour 1 closed by the outage advance above
    TEST_ASSERT_EQUAL_INT64(1, idx);
    station::history::ClosedInterval rec{};
    rec.idx = idx;
    rec.slots = slots;
    TEST_ASSERT_TRUE(store.append(Tier::Hour, rec));
    TEST_ASSERT_FALSE(h.take_closed(Tier::Hour, idx, slots));  // handed out once
    TieredHistory r;
    r.advance(5 * 60, 5, 0);
    r.attach(&store);
    r.restore(store);
    TEST_ASSERT_TRUE(r.slot(Metric::RainMm, Tier::Hour, 20).value(station::history::Agg::Sum, v));   // 4 hours back
    TEST_ASSERT_FLOAT_WITHIN(0.01F, 36.0F, v);
    TEST_ASSERT_TRUE(r.current(Metric::RainMm, Tier::Day).value(station::history::Agg::Sum, v));      // today so far
    TEST_ASSERT_FLOAT_WITHIN(0.01F, 36.0F, v);
    station::history::Slot sl{};
    TEST_ASSERT_TRUE(r.long_slot(Metric::RainMm, Tier::Hour, 4, sl));
    TEST_ASSERT_FALSE(r.long_slot(Metric::RainMm, Tier::Hour, 30, sl));   // nothing stored that far back
    // RAM budget: 60 minutes + 24 h cache + accumulators for all metrics
    TEST_ASSERT_TRUE(TieredHistory::kBytes < 40 * 1024);
}

// Raw-flash history log: capacity, ring wrap, persistence across a reboot, torn writes, foreign data.
void test_history_store_ring_wrap_power_loss_and_format(void) {
    namespace hs = station::history;
    TEST_ASSERT_TRUE(hs::HistoryStore::kSectorsNeeded * hs::FlashDevice::kSector <= 0x60000);   // fits the partition
    hs::MemFlash flash(0x60000);
    std::memset(flash.raw().data(), 0x5A, flash.raw().size());   // old LittleFS contents
    hs::HistoryStore st;
    TEST_ASSERT_TRUE(st.begin(&flash));
    TEST_ASSERT_TRUE(st.formatted());
    auto rec = [](std::int64_t i) {
        hs::ClosedInterval r{};
        r.idx = i;
        r.slots[static_cast<std::size_t>(hs::Metric::TempC)].add(hs::Agg::Mean, static_cast<float>(i));
        r.rose.calm = static_cast<std::uint16_t>(i % 60);
        return r;
    };
    // 20 days of hours: the ring keeps at least 14 days, the oldest are overwritten
    for (std::int64_t i = 1000; i < 1000 + 20 * 24; ++i) TEST_ASSERT_TRUE(st.append(hs::Tier::Hour, rec(i)));
    TEST_ASSERT_TRUE(st.count(hs::Tier::Hour) >= hs::HistoryStore::kHourRecords);
    const std::int64_t newest = 1000 + 20 * 24 - 1;
    hs::Slot s{};
    float v = 0.0F;
    TEST_ASSERT_TRUE(st.read_slot(hs::Tier::Hour, newest - static_cast<std::int64_t>(hs::HistoryStore::kHourRecords) + 1, hs::Metric::TempC, s));
    TEST_ASSERT_FALSE(st.read_slot(hs::Tier::Hour, 1000, hs::Metric::TempC, s));   // overwritten
    for (std::int64_t d = 0; d < 200; ++d) st.append(hs::Tier::Day, rec(d));
    TEST_ASSERT_TRUE(st.count(hs::Tier::Day) >= hs::HistoryStore::kDayRecords);
    // reboot: the index is rebuilt from flash, appending continues after the newest record
    hs::HistoryStore st2;
    TEST_ASSERT_TRUE(st2.begin(&flash));
    TEST_ASSERT_FALSE(st2.formatted());
    TEST_ASSERT_TRUE(st2.read_slot(hs::Tier::Hour, newest, hs::Metric::TempC, s) && s.value(hs::Agg::Mean, v));
    TEST_ASSERT_FLOAT_WITHIN(1e-3F, static_cast<float>(newest), v);
    hs::WindRose::Bucket b{};
    TEST_ASSERT_TRUE(st2.read_rose(hs::Tier::Hour, newest, b));
    TEST_ASSERT_EQUAL_UINT16(newest % 60, b.calm);
    TEST_ASSERT_TRUE(st2.append(hs::Tier::Hour, rec(newest + 1)));
    // power cut while writing: a half-programmed record is ignored and the next write skips its slot
    hs::HistoryStore st3;
    TEST_ASSERT_TRUE(st3.begin(&flash));
    const std::uint32_t erases_before = flash.erases();
    std::vector<std::uint8_t> snapshot = flash.raw();
    TEST_ASSERT_TRUE(st3.append(hs::Tier::Hour, rec(newest + 2)));
    std::vector<std::uint8_t>& raw = flash.raw();
    std::size_t torn = 0;   // find the bytes the last write changed and undo the second half of them
    for (std::size_t i = 0; i < raw.size(); ++i) if (raw[i] != snapshot[i]) torn = i;
    for (std::size_t i = torn - 100; i <= torn; ++i) raw[i] = snapshot[i];
    (void)erases_before;
    hs::HistoryStore st4;
    TEST_ASSERT_TRUE(st4.begin(&flash));
    TEST_ASSERT_FALSE(st4.read_slot(hs::Tier::Hour, newest + 2, hs::Metric::TempC, s));   // torn record not used
    TEST_ASSERT_TRUE(st4.read_slot(hs::Tier::Hour, newest + 1, hs::Metric::TempC, s));    // older ones intact
    TEST_ASSERT_TRUE(st4.append(hs::Tier::Hour, rec(newest + 3)));
    hs::HistoryStore st5;
    TEST_ASSERT_TRUE(st5.begin(&flash));
    TEST_ASSERT_TRUE(st5.read_slot(hs::Tier::Hour, newest + 3, hs::Metric::TempC, s) && s.value(hs::Agg::Mean, v));
    TEST_ASSERT_FLOAT_WITHIN(1e-3F, static_cast<float>(newest + 3), v);
    // a day of 1-s samples overflows 16 bits: counts are 32-bit end to end
    hs::Slot day{};
    for (int i = 0; i < 86400; ++i) day.add(hs::Agg::Mean, 2.0F);
    TEST_ASSERT_TRUE(day.value(hs::Agg::Mean, v));
    TEST_ASSERT_FLOAT_WITHIN(1e-3F, 2.0F, v);
}

void test_conditioners_vibration_pressure_and_rain_pulses(void) {
    // 20 Hz, 10 mg vertical vibration: PGA ~10 mg, PPV = a / (2 pi f) = 0.098 m/s^2 / 125.7 = 0.78 mm/s
    station::conditioning::VibrationAnalyzer vib;
    station::core::Vec3 g{};
    station::core::VibrationSecond vs{};
    for (int sec = 0; sec < 3; ++sec) {
        for (int i = 0; i < 200; ++i) {
            const float t = static_cast<float>(sec * 200 + i) / 200.0F;
            vib.add({0.0F, 0.0F, 1.0F + 0.010F * std::sin(2.0F * 3.14159265F * 20.0F * t)});
        }
        vib.take_second(g, vs);
    }
    TEST_ASSERT_FLOAT_WITHIN(1.0F, 10.0F, vs.pga_mg);
    TEST_ASSERT_FLOAT_WITHIN(0.15F, 0.78F, vs.ppv_mm_s);
    TEST_ASSERT_FLOAT_WITHIN(1.5F, 20.0F, vs.dominant_hz);
    TEST_ASSERT_FLOAT_WITHIN(0.01F, 1.0F, g.z);

    // Barometer: quiet 100 Hz stream, then a 3 Pa thunder N-wave onset
    station::conditioning::PressureAnalyzer pa;
    station::core::ThunderArrival onset{};
    bool heard = false;
    std::uint32_t t_ms = 0;
    for (int i = 0; i < 3000; ++i, t_ms += 10) {
        const float noise = 0.05F * std::sin(static_cast<float>(i) * 1.7F);
        heard = heard || pa.add(100000.0F + noise, t_ms, onset);
    }
    TEST_ASSERT_FALSE(heard);
    for (int i = 0; i < 20; ++i, t_ms += 10) {
        heard = heard || pa.add(100000.0F + (i < 10 ? 3.0F : -3.0F), t_ms, onset);
    }
    TEST_ASSERT_TRUE(heard);
    TEST_ASSERT_TRUE(onset.peak_pa > 2.0F);
    float mean_hpa = 0.0F, ripple = 0.0F;
    TEST_ASSERT_TRUE(pa.take_second(mean_hpa, ripple));
    TEST_ASSERT_FLOAT_WITHIN(0.01F, 1000.0F, mean_hpa);
}

void test_pipeline_missing_sensors_publish_null_not_defaults(void) {
    Pipeline p;
    RawState raw{};
    EventQueues ev{};
    StationConfig cfg{};
    DerivedState d{};
    raw.now_ms = 5000;
    p.step(raw, ev, cfg, d);
    const auto doc = parse(TelemetryFormatter::build_state_json(d, "test", WifiInfo{}));
    TEST_ASSERT_TRUE(doc["environment"]["temp_c"].isNull());
    TEST_ASSERT_TRUE(doc["environment"]["qnh_hpa"].isNull());
    TEST_ASSERT_TRUE(doc["wind"]["speed_m_s"].isNull());
    TEST_ASSERT_TRUE(doc["air_quality"]["aqi"].isNull());
    TEST_ASSERT_TRUE(doc["solar"]["uv_index"].isNull());
    TEST_ASSERT_TRUE(doc["seismic"]["ppv_mm_s"].isNull());
    TEST_ASSERT_FALSE(doc["location_set"].as<bool>());
    TEST_ASSERT_EQUAL_STRING("—", doc["environment"]["forecast"].as<const char*>());
}

void test_pipeline_three_hour_run_trends_history_and_publishers(void) {
    Pipeline p;
    RawState raw{};
    EventQueues ev{};
    const StationConfig cfg = vilnius();
    DerivedState d{};
    // Start 2025-12-21 18:00 UTC (20:00 EET, deep night). Pressure falls 1 hPa/h, temperature rises 1 C/h.
    const std::int64_t t0 = 1766340000;
    const int seconds = 3 * 3600 + 6 * 60;
    for (int s = 0; s < seconds; ++s) {
        fill_steady(raw, static_cast<std::uint32_t>(s) * 1000U);
        raw.clock.valid = true;
        raw.clock.unix_s = t0 + s;
        raw.clock.utc_offset_s = 2 * 3600;
        raw.thermo.temp_c.set(15.0F + static_cast<float>(s) / 3600.0F, raw.now_ms);
        raw.baro.pressure_hpa.set(1000.0F - static_cast<float>(s) / 3600.0F, raw.now_ms);
        raw.optical.tsl_lux.set(0.0015F, raw.now_ms);   // dark rural sky
        raw.optical.ltr_uvi.set(0.0F, raw.now_ms);
        p.step(raw, ev, cfg, d);
    }
    // Wind: steady 5 m/s from the west
    TEST_ASSERT_FLOAT_WITHIN(0.01F, 5.0F, d.wind.avg_10m_m_s.v);
    TEST_ASSERT_FLOAT_WITHIN(0.5F, 270.0F, d.wind.dir_10m_deg.v);
    TEST_ASSERT_FLOAT_WITHIN(0.01F, 5.0F, d.wind.gust_m_s.v);
    TEST_ASSERT_TRUE(d.wind.load_kg_m2.ok);
    TEST_ASSERT_FLOAT_WITHIN(0.1F, 1.53F, d.wind.load_kg_m2.v);  // 1/2 rho v^2 / g
    TEST_ASSERT_FLOAT_WITHIN(0.5F, 0.0F, d.wind.dir_change_3h_deg.v);
    // Barometer: 3 h x -1 hPa/h = -3.0 hPa station change. QNH = station x 1.0134 (112 m), and the
    // 3 K warming of the reduction temperature lowers QNH by another ~0.14 hPa -> ~-3.18 hPa.
    TEST_ASSERT_TRUE(d.baro.change_3h_hpa.ok);
    TEST_ASSERT_FLOAT_WITHIN(0.06F, -3.18F, d.baro.change_3h_hpa.v);
    TEST_ASSERT_TRUE(d.baro.tide_3h_hpa.ok);
    TEST_ASSERT_FLOAT_WITHIN(0.001F, d.baro.change_3h_hpa.v - d.baro.tide_3h_hpa.v, d.baro.synoptic_3h_hpa.v);
    // Thermo: trend ~ +1 C/h, 24-h range from the hour tier, wind-chill/heat-index sensible
    TEST_ASSERT_TRUE(d.thermo.trend_c_per_h.ok);
    TEST_ASSERT_FLOAT_WITHIN(0.1F, 1.0F, d.thermo.trend_c_per_h.v);
    TEST_ASSERT_FLOAT_WITHIN(0.05F, 15.0F, d.thermo.temp_min_24h_c.v);
    TEST_ASSERT_FLOAT_WITHIN(0.05F, 18.1F, d.thermo.temp_max_24h_c.v);
    TEST_ASSERT_FLOAT_WITHIN(0.01F, 0.0F, d.thermo.solar_offset_c.v);  // night: no radiation error
    // Astronomy / night sky: location + clock known
    TEST_ASSERT_TRUE(d.astro.is_night);
    TEST_ASSERT_TRUE(d.solar.sqm_mag_arcsec2.ok);
    TEST_ASSERT_FALSE(d.solar.cloud_cover_pct.ok);  // no cloud estimate in the dark
    TEST_ASSERT_TRUE(d.astro.sunrise_min.ok && d.astro.moon_illum_pct.ok);
    // Air quality: NowCast AQI from PM2.5 6 ug/m3 (Good), EAQI band 1
    TEST_ASSERT_FLOAT_WITHIN(1.0F, 33.0F, d.air.aqi.v);
    TEST_ASSERT_FLOAT_WITHIN(0.1F, 1.0F, d.air.eaqi.v);

    // Publishers: lean state JSON (no 60-min arrays), minute charts with 60 bars, tiered export
    const std::string state = TelemetryFormatter::build_state_json(d, "test", WifiInfo{});
    TEST_ASSERT_NULL(std::strstr(state.c_str(), "_60m"));
    const auto doc = parse(state);
    TEST_ASSERT_FLOAT_WITHIN(0.06F, -3.18F, doc["environment"]["pressure_3h_delta_hpa"].as<float>());
    TEST_ASSERT_TRUE(doc["location_set"].as<bool>());
    const auto minutes = parse(TelemetryFormatter::build_minute_history_json(p.history()));
    TEST_ASSERT_EQUAL_INT(60, static_cast<int>(minutes["rain_mm_h"].size()));
    TEST_ASSERT_EQUAL_INT(60, static_cast<int>(minutes["strikes"].size()));
    const auto hours = parse(TelemetryFormatter::build_history_json(p.history(), Tier::Hour, "temp_c,qnh_hpa,bogus", t0 + seconds));
    TEST_ASSERT_EQUAL_INT(25, static_cast<int>(hours["series"]["temp_c"]["v"].size()));
    TEST_ASSERT_TRUE(hours["series"]["temp_c"]["v"][0].isNull());   // older than the run
    TEST_ASSERT_FALSE(hours["series"]["temp_c"]["v"][24].isNull());
    TEST_ASSERT_TRUE(hours["series"]["bogus"].isNull());

    // HA discovery + RS-485 frame read DerivedState only
    std::string topic, payload;
    TEST_ASSERT_TRUE(TelemetryFormatter::build_ha_discovery(0, "roof01", "homeassistant", topic, payload));
    TEST_ASSERT_EQUAL_STRING("homeassistant/sensor/aeromet_roof01/temperature/config", topic.c_str());
    TEST_ASSERT_NOT_NULL(std::strstr(payload.c_str(), "\"stat_cla\":\"measurement\""));
    TEST_ASSERT_FALSE(TelemetryFormatter::build_ha_discovery(TelemetryFormatter::ha_sensor_count(), "x", "y", topic, payload));
    const std::string frame = Rs485Protocol::encode_telemetry_frame(d);
    TEST_ASSERT_NOT_NULL(std::strstr(frame.c_str(), "$AM,"));
    TEST_ASSERT_NOT_NULL(std::strstr(frame.c_str(), ",5.00,270.0,"));
}

void test_pipeline_daytime_cloud_cover_rain_lightning_and_thunder(void) {
    Pipeline p;
    RawState raw{};
    EventQueues ev{};
    const StationConfig cfg = vilnius();
    DerivedState d{};
    const std::int64_t t0 = kSolsticeNoonUtc - 6120;  // solar noon, sun 58.8 deg
    const float clear = Astronomy::clear_sky_ghi_w_m2(58.75F);
    std::uint32_t strike_ms = 0;
    for (int s = 0; s < 700; ++s) {
        fill_steady(raw, 10000U + static_cast<std::uint32_t>(s) * 1000U);
        raw.clock.valid = true;
        raw.clock.unix_s = t0 + s;
        raw.clock.utc_offset_s = 3 * 3600;
        raw.optical.tsl_lux.set(clear * 0.6F * 122.0F, raw.now_ms);  // 60 % of clear-sky
        raw.optical.ltr_uvi.set(4.0F, raw.now_ms);
        if (s >= 600) {
            for (int k = 0; k < 10; ++k) {
                ev.rain.push({raw.now_ms, 626, 206, 220});
            }
        }
        if (s == 650) {
            strike_ms = raw.now_ms;
            ev.lightning.push({raw.now_ms, 6, 120000});
        }
        if (s == 660) {
            ev.thunder.push({strike_ms + 10000U, 3.0F});  // 10 s flash-to-bang
        }
        p.step(raw, ev, cfg, d);
    }
    TEST_ASSERT_FALSE(d.astro.is_night);
    TEST_ASSERT_TRUE(d.solar.cloud_cover_pct.ok);
    TEST_ASSERT_FLOAT_WITHIN(1.0F, 83.1F, d.solar.cloud_cover_pct.v);  // Kasten-Czeplak: 100 (0.4/0.75)^(1/3.4)
    TEST_ASSERT_FALSE(d.solar.sqm_mag_arcsec2.ok);
    TEST_ASSERT_TRUE(d.solar.burn_time_min.ok);
    TEST_ASSERT_FLOAT_WITHIN(1.0F, 41.7F, d.solar.burn_time_min.v);
    TEST_ASSERT_TRUE(d.thermo.solar_offset_c.v > 0.1F);  // shield radiation error removed in sun

    TEST_ASSERT_TRUE(d.rain.raining);
    TEST_ASSERT_TRUE(d.rain.rate_mm_h > 0.0F);
    TEST_ASSERT_FLOAT_WITHIN(0.02F, d.rain.today_mm, d.rain.last_hour_mm);

    TEST_ASSERT_EQUAL_UINT32(1, d.lightning.strikes_total);
    TEST_ASSERT_EQUAL_UINT32(1, d.lightning.strikes_1h);
    TEST_ASSERT_EQUAL_STRING("acoustic", d.lightning.method);
    TEST_ASSERT_FLOAT_WITHIN(0.01F, 3.434F, d.lightning.distance_km.v);  // 10 s x 343.4 m/s
    TEST_ASSERT_FLOAT_WITHIN(0.01F, 10.0F, d.lightning.thunder_delay_s.v);
    TEST_ASSERT_FLOAT_WITHIN(1.5F, 49.0F, d.lightning.last_strike_age_s.v);
}

void test_constant_wattage_heater_on_regulated_5v_rail(void) {
    // Freezing outdoor air (-4 C), reflector at 0 C (NTC ~32.6k -> ~2525 mV); heater on the +12V_HEAT rail
    // (lo = pass-through on a 12 V supply, nom = regulated 12 V, hi = regulator tolerance)
    HeaterSensorInput lo{10.4F, 2525, -4.0F, true};
    HeaterSensorInput nom{12.0F, 2525, -4.0F, true};
    HeaterSensorInput hi{12.3F, 2525, -4.0F, true};
    const auto out_lo = DeIcingHeaterController::update(lo);
    const auto out_nom = DeIcingHeaterController::update(nom);
    const auto out_hi = DeIcingHeaterController::update(hi);
    TEST_ASSERT_EQUAL(HeaterState::Heating, out_nom.state);
    // Constant 4.5 W across the rail range: 4x 120 ohm (30 ohm) gives 4.80 W at 12.0 V, 3.61 W at 10.4 V
    TEST_ASSERT_FLOAT_WITHIN(0.05F, 4.5F, out_nom.actual_power_w);
    TEST_ASSERT_FLOAT_WITHIN(0.05F, 4.5F, out_hi.actual_power_w);
    TEST_ASSERT_FLOAT_WITHIN(0.05F, 3.61F, out_lo.actual_power_w);   // 100 % duty: all the rail can give
    TEST_ASSERT_FLOAT_WITHIN(0.1F, 100.0F, out_lo.pwm_duty_percent);
    TEST_ASSERT_TRUE(out_hi.pwm_duty_percent < out_nom.pwm_duty_percent);
    // A sagging rail (input far below 12 V / buck overloaded) locks the heater out
    HeaterSensorInput sag{8.5F, 2525, -4.0F, true};
    TEST_ASSERT_EQUAL(HeaterState::UndervoltageLockout, DeIcingHeaterController::update(sag).state);
    // Service button press decoded when NTC_SENSE pulled below 150 mV
    HeaterSensorInput btn{12.0F, 40, 18.0F, false};
    TEST_ASSERT_TRUE(DeIcingHeaterController::update(btn).service_button_pressed);
    // An open reflector NTC (NTC_SENSE at the 3.3 V pull-up) must never heat blind, even in icing conditions
    HeaterSensorInput open_ntc{12.0F, 3300, -10.0F, true};
    const auto out_open = DeIcingHeaterController::update(open_ntc);
    TEST_ASSERT_EQUAL(HeaterState::SensorFault, out_open.state);
    TEST_ASSERT_EQUAL_FLOAT(0.0F, out_open.pwm_duty_percent);
    // -40 C (3220 mV) is still a valid reading and heats
    HeaterSensorInput deep_cold{12.0F, 3220, -40.0F, true};
    TEST_ASSERT_EQUAL(HeaterState::Heating, DeIcingHeaterController::update(deep_cold).state);
}

void test_longevity_sht45_bakeout_and_scd41_extreme_cold_guard(void) {
    EnvLongevityManager mgr;
    // 1. Extreme cold (-35 C) pauses SCD41 photoacoustic pulsing; hysteresis holds pause until >= -8 C
    TEST_ASSERT_TRUE(mgr.tick_second(-35.0F, 70.0F, false).scd41_extreme_cold_pause);
    TEST_ASSERT_TRUE(mgr.tick_second(-9.0F, 70.0F, false).scd41_extreme_cold_pause);
    TEST_ASSERT_FALSE(mgr.tick_second(-7.5F, 70.0F, false).scd41_extreme_cold_pause);

    // 2. 30 minutes of >=96% RH freezing fog triggers 1s SHT45 bake-out pulse + 15s thermal lockout
    for (int m = 0; m < 29; ++m) {
        const auto st = mgr.tick_second(1.5F, 98.0F, true);
        TEST_ASSERT_FALSE(st.sht45_bakeout_pulse);
        TEST_ASSERT_FALSE(st.sht45_reading_locked);
    }
    const auto trig = mgr.tick_second(1.5F, 98.0F, true);
    TEST_ASSERT_TRUE(trig.sht45_bakeout_pulse);
    TEST_ASSERT_TRUE(trig.sht45_reading_locked);
    TEST_ASSERT_EQUAL_UINT8(15, trig.cooldown_seconds);

    // Next 15 seconds count down thermal recovery lockout, then unlock SHT45 readings
    for (int s = 0; s < 14; ++s) {
        TEST_ASSERT_TRUE(mgr.tick_second(1.5F, 98.0F, false).sht45_reading_locked);
    }
    TEST_ASSERT_FALSE(mgr.tick_second(1.5F, 98.0F, false).sht45_reading_locked);
}

void test_reboot_and_factory_reset_button_controller(void) {
    station::firmware::ButtonController btn{};
    // 1. Short press (250 ms) -> triggers Reboot on release
    TEST_ASSERT_EQUAL(station::firmware::ButtonAction::None, btn.update(true, 1000));
    TEST_ASSERT_EQUAL(station::firmware::ButtonAction::None, btn.update(true, 1150));
    TEST_ASSERT_EQUAL(station::firmware::ButtonAction::Reboot, btn.update(false, 1250));

    // 2. Long press (>= 10,000 ms) -> triggers FactoryReset while held and does NOT re-trigger Reboot on release
    TEST_ASSERT_EQUAL(station::firmware::ButtonAction::None, btn.update(true, 5000));
    TEST_ASSERT_EQUAL(station::firmware::ButtonAction::None, btn.update(true, 14999));
    TEST_ASSERT_EQUAL(station::firmware::ButtonAction::FactoryReset, btn.update(true, 15000));
    TEST_ASSERT_EQUAL(station::firmware::ButtonAction::None, btn.update(false, 15500));
}

void test_rs485_command_parsing(void) {
    TEST_ASSERT_EQUAL(CommandType::Ping, Rs485Protocol::parse_command_frame("PING\r\n", 6));
    TEST_ASSERT_EQUAL(CommandType::RequestState, Rs485Protocol::parse_command_frame("STATE?\n", 7));
    TEST_ASSERT_EQUAL(CommandType::ResetDailyRain, Rs485Protocol::parse_command_frame("RESET_RAIN", 10));
    TEST_ASSERT_EQUAL(CommandType::None, Rs485Protocol::parse_command_frame("BAD", 3));
    // multi-drop addressing
    TEST_ASSERT_EQUAL(CommandType::RequestState, Rs485Protocol::parse_command("7:STATE?\r\n", 10, 7));
    TEST_ASSERT_EQUAL(CommandType::None, Rs485Protocol::parse_command("8:STATE?", 8, 7));
    TEST_ASSERT_EQUAL(CommandType::None, Rs485Protocol::parse_command("STATE?", 6, 7));   // bare: not for station 7
    TEST_ASSERT_EQUAL(CommandType::RequestState, Rs485Protocol::parse_command("0:STATE?", 8, 0));
    TEST_ASSERT_EQUAL(CommandType::None, Rs485Protocol::parse_command("7:STATE?", 8, 0));
    // PONG carries a real CRC-16/MODBUS and the station address
    const std::string pong = Rs485Protocol::encode_pong(7);
    TEST_ASSERT_EQUAL_STRING_LEN("$AM7,PONG*", pong.c_str(), 10);
    char want[8];
    std::snprintf(want, sizeof want, "%04X", static_cast<unsigned>(Rs485Protocol::crc16_modbus("$AM7,PONG", 9)));
    TEST_ASSERT_EQUAL_STRING_LEN(want, pong.c_str() + 10, 4);
    TEST_ASSERT_EQUAL_STRING("\r\n", pong.c_str() + 14);
    // Fields without a valid value are left empty rather than sending fake numbers
    DerivedState d{};
    d.uptime_s = 120;
    const std::string frame = Rs485Protocol::encode_telemetry_frame(d);
    TEST_ASSERT_NOT_NULL(std::strstr(frame.c_str(), "$AM,120,,,0.00,0.00,,,,,,,,,,,,,,,,0.00,0.0,,,,,,,0,,,,3*"));   // counters + health always present
}

void test_sgp41_gas_index_algorithm_blackout_baseline_event_and_state(void) {
    station::airquality::GasIndexPair g;
    float v = 0.0F;
    // First 10 s: SGP41 conditioning (VOC only), then 45 s algorithm blackout -> no index yet
    for (int s = 0; s < 40; ++s) {
        g.process(30000, s >= 10, 16000);
    }
    TEST_ASSERT_FALSE(g.voc(v));
    TEST_ASSERT_TRUE(g.learning());
    // Two hours of constant clean air: VOC settles at the 100 offset, NOx at its 1 baseline
    for (int s = 0; s < 2 * 3600; ++s) {
        g.process(30000, true, 16000);
    }
    TEST_ASSERT_TRUE(g.voc(v));
    TEST_ASSERT_FLOAT_WITHIN(3.0F, 100.0F, v);
    TEST_ASSERT_TRUE(g.nox(v));
    TEST_ASSERT_FLOAT_WITHIN(1.0F, 1.0F, v);
    // A VOC event lowers the MOx raw signal: the index rises well above typical air
    for (int s = 0; s < 120; ++s) {
        g.process(27000, true, 16000);
    }
    TEST_ASSERT_TRUE(g.voc(v));
    TEST_ASSERT_TRUE(v > 200.0F);
    // State persistence is only offered after >= 3 h of operation (Sensirion requirement)
    float s0 = 0.0F, s1 = 0.0F;
    TEST_ASSERT_FALSE(g.voc_state(s0, s1));
    for (int s = 0; s < 3600; ++s) {
        g.process(30000, true, 16000);
    }
    TEST_ASSERT_TRUE(g.voc_state(s0, s1));
    station::airquality::GasIndexPair r;
    r.restore_voc_state(s0, s1);
    for (int s = 0; s < 60; ++s) {
        r.process(30000, true, 16000);
    }
    TEST_ASSERT_TRUE(r.voc(v));  // resumes without the 45 s blackout / initial learning
    TEST_ASSERT_FLOAT_WITHIN(10.0F, 100.0F, v);
}

void test_pipeline_uv_fusion_and_sgp41_gas_indices(void) {
    // LTR-390 only
    Pipeline p;
    RawState raw{};
    EventQueues ev{};
    StationConfig cfg{};
    DerivedState d{};
    fill_steady(raw, 1000);
    raw.optical.ltr_uvi.set(3.0F, 1000);
    p.step(raw, ev, cfg, d);
    TEST_ASSERT_EQUAL_STRING("LTR-390", d.solar.uv_source);
    TEST_ASSERT_FLOAT_WITHIN(0.01F, 3.0F, d.solar.uv_index.v);
    // VOC / NOx: no index during the gas index algorithm's 45 s blackout, then the learned baseline
    TEST_ASSERT_FALSE(d.air.voc_index.ok);
    TEST_ASSERT_TRUE(d.air.gas_learning);
    for (int s = 0; s < 120; ++s) {
        const std::uint32_t t = 1000U + static_cast<std::uint32_t>(s) * 1000U;
        fill_steady(raw, t);
        p.step(raw, ev, cfg, d);
    }
    TEST_ASSERT_TRUE(d.air.voc_index.ok);
    TEST_ASSERT_FLOAT_WITHIN(5.0F, 100.0F, d.air.voc_index.v);
    TEST_ASSERT_TRUE(d.air.nox_index.ok);

    // UV: 80 % true UV-B sensor + 20 % LTR-390, both per-sensor values published
    fill_steady(raw, 122000);
    raw.optical.ltr_uvi.set(3.0F, 122000);
    raw.optical.guvb_uvi.set(5.0F, 122000);
    p.step(raw, ev, cfg, d);
    TEST_ASSERT_EQUAL_STRING("GUVB-C31SM + LTR-390", d.solar.uv_source);
    TEST_ASSERT_FLOAT_WITHIN(0.01F, 4.6F, d.solar.uv_index.v);
    TEST_ASSERT_FLOAT_WITHIN(0.01F, 5.0F, d.solar.uv_index_guvb.v);
    TEST_ASSERT_FLOAT_WITHIN(0.01F, 3.0F, d.solar.uv_index_ltr.v);
    const auto doc = parse(TelemetryFormatter::build_state_json(d, "t", WifiInfo{}));
    TEST_ASSERT_FLOAT_WITHIN(0.1F, 5.0F, doc["solar"]["uv_index_guvb"].as<float>());
    TEST_ASSERT_TRUE(doc["air_quality"]["pm4_0"].isNull());
    TEST_ASSERT_TRUE(doc["air_quality"]["gas_learning"].as<bool>());
}


void test_uv_photodiode_dome_conversions(void) {
    namespace pd = station::environment::uvpd;
    // 0.46 mV across the 10 MOhm UV-B gain = 46 pA (UV index 0.3 behind the PTFE dome)
    TEST_ASSERT_FLOAT_WITHIN(1e-4F, 0.046F, pd::na_from_volts(0.46e-3F, pd::kRfUvbOhm));
    // 1.4 nA per UV index in sunlight (datasheet), divided by the cover transmission
    TEST_ASSERT_FLOAT_WITHIN(0.01F, 0.3F, pd::uv_index(0.046F, 0.11F, 0.0F));
    TEST_ASSERT_FLOAT_WITHIN(0.01F, 2.0F, pd::uv_index(0.3F, 0.11F, 0.15F));   // field scale: nA behind the cover / UVI
    TEST_ASSERT_FLOAT_WITHIN(0.01F, 1.0F, pd::uvb_w_m2(7.1F, 1.0F));   // 71 nA per mW/cm^2
    TEST_ASSERT_FLOAT_WITHIN(0.01F, 50.0F, pd::uva_w_m2(565.0F, 1.0F));
    // PGA steps: up near the full scale, down when the reading fits the smaller range comfortably
    TEST_ASSERT_EQUAL_UINT8(1, pd::next_range(0, 0.24F));
    TEST_ASSERT_EQUAL_UINT8(0, pd::next_range(1, 0.05F));
    TEST_ASSERT_EQUAL_UINT8(3, pd::next_range(3, 2.0F));
    TEST_ASSERT_EQUAL_UINT8(1, pd::next_range(1, 0.3F));
    // dark offset learnt at night only, subtracted by day, never negative
    pd::DarkZero z;
    z.update(0.02F, false);
    TEST_ASSERT_FLOAT_WITHIN(1e-6F, 0.0F, z.offset_na());
    for (int i = 0; i < 400; ++i) z.update(0.02F, true);
    TEST_ASSERT_FLOAT_WITHIN(1e-4F, 0.02F, z.offset_na());
    TEST_ASSERT_FLOAT_WITHIN(1e-4F, 0.08F, z.apply(0.10F));
    TEST_ASSERT_FLOAT_WITHIN(1e-6F, 0.0F, z.apply(0.01F));
}

void test_pipeline_photodiode_dome_uv_and_lux_fallback(void) {
    Pipeline p;
    RawState raw{};
    EventQueues ev{};
    StationConfig cfg{};
    DerivedState d{};
    // bright unsaturated TSL25911 + UV-A: the pipeline learns lux per UV-A W/m^2 (50 klx / 40 W/m^2)
    for (int s = 0; s < 5; ++s) {
        const std::uint32_t t = 1000U + static_cast<std::uint32_t>(s) * 1000U;
        fill_steady(raw, t);
        raw.optical.tsl_lux.set(50000.0F, t);
        raw.optical.pd_uva_w_m2.set(40.0F, t);
        raw.optical.pd_uvb_w_m2.set(1.2F, t);
        raw.optical.guvb_uvi.set(6.0F, t);
        p.step(raw, ev, cfg, d);
    }
    TEST_ASSERT_EQUAL_STRING("GUVB-C21SD", d.solar.uv_source);
    TEST_ASSERT_FLOAT_WITHIN(0.01F, 6.0F, d.solar.uv_index.v);
    TEST_ASSERT_FLOAT_WITHIN(0.01F, 1.2F, d.solar.uvb_w_m2.v);   // measured, not estimated from the UV index
    TEST_ASSERT_FLOAT_WITHIN(0.01F, 40.0F, d.solar.uva_w_m2.v);
    // TSL saturated (no reading, no LTR-390): lux from the UV-A channel with the learnt ratio
    fill_steady(raw, 30000);   // the last TSL reading (5 s) is stale by now
    raw.optical.pd_uva_w_m2.set(48.0F, 30000);
    raw.optical.pd_uvb_w_m2.set(1.4F, 30000);
    raw.optical.guvb_uvi.set(7.0F, 30000);
    p.step(raw, ev, cfg, d);
    TEST_ASSERT_TRUE(d.solar.lux.ok);
    TEST_ASSERT_FLOAT_WITHIN(500.0F, 60000.0F, d.solar.lux.v);
}

void test_mmc5983_output_decoding(void) {
    // null field (131072 = 0x20000): every axis 0 uT
    const std::uint8_t null_field[7] = {0x80, 0x00, 0x80, 0x00, 0x80, 0x00, 0x00};
    auto f = station::environment::mmc5983_field_ut(null_field);
    TEST_ASSERT_FLOAT_WITHIN(1e-3F, 0.0F, f.x);
    TEST_ASSERT_FLOAT_WITHIN(1e-3F, 0.0F, f.z);
    // X = 131072 + 16384 (+1 G = 100 uT): 0x24000 -> 0x90, 0x00, low bits 00; Y = 131072 - 8192 (-50 uT) = 0x1E000;
    // Z = 131072 + 3 (low bits only, 3 counts = 0.0183 uT)
    const std::uint8_t b[7] = {0x90, 0x00, 0x78, 0x00, 0x80, 0x00, 0x0C};
    f = station::environment::mmc5983_field_ut(b);
    TEST_ASSERT_FLOAT_WITHIN(1e-3F, 100.0F, f.x);
    TEST_ASSERT_FLOAT_WITHIN(1e-3F, -50.0F, f.y);
    TEST_ASSERT_FLOAT_WITHIN(1e-4F, 3.0F / 16384.0F * 100.0F, f.z);
}

void test_heater_power_monitor_and_heat_check(void) {
    Pipeline p;
    RawState raw{};
    EventQueues ev{};
    StationConfig cfg{};
    DerivedState d{};
    auto feed = [&](std::uint32_t t, float refl_a, float probe_a, float scd_c) {
        fill_steady(raw, t);
        raw.power.refl_heater_a.set(refl_a, t);
        raw.power.probe_heater_a.set(probe_a, t);
        raw.power.rail_heat.set(12.0F, t);
        raw.power.rail_5v_logic.set(5.02F, t);
        raw.air.scd41_temp_c.set(scd_c, t);
        p.step(raw, ev, cfg, d);
    };
    // Probe heater on (35 mA from +12V_HEAT) holding the SCD41 zone at its +8 C setpoint
    feed(1000, 0.0F, 0.0353F, 8.1F);
    TEST_ASSERT_TRUE(d.heater.probe_on);
    TEST_ASSERT_FLOAT_WITHIN(0.01F, 0.4236F, d.heater.probe_w.v);
    TEST_ASSERT_EQUAL_STRING("heating", d.heater.probe_status);
    TEST_ASSERT_FLOAT_WITHIN(0.01F, 8.1F, d.heater.probe_c.v);
    // Cold zone but no current: the probe heater is not heating
    feed(2000, 0.0F, 0.0F, 2.0F);
    TEST_ASSERT_EQUAL_STRING("not-heating", d.heater.probe_status);
    // Reflector idle (warm, dry) and no current: ok; current without a duty: stuck-on
    TEST_ASSERT_EQUAL_STRING("ok", d.heater.reflector_status);
    feed(3000, 0.2F, 0.0F, 9.0F);
    TEST_ASSERT_EQUAL_STRING("stuck-on", d.heater.reflector_status);

    // HEAT_CHECK: 10 s fixed 2 W pulse; at 12.0 V the duty is 2 x 30 / 12^2 = 41.7 % -> 0.167 A mean current
    p.request_heater_check();
    std::uint32_t t = 4000;
    for (int s = 0; s < Pipeline::kHeaterCheckS; ++s, t += 1000) {
        feed(t, 0.1667F, 0.0F, 9.0F);
        TEST_ASSERT_TRUE(s == Pipeline::kHeaterCheckS - 1 || d.controls.heater_check);
    }
    TEST_ASSERT_FLOAT_WITHIN(0.1F, 41.7F, d.heater.duty_pct);
    TEST_ASSERT_FLOAT_WITHIN(0.05F, 2.0F, d.heater.reflector_w.v);
    TEST_ASSERT_EQUAL_STRING("check-pass", d.heater.reflector_status);
    // An open heater (no current during the pulse) fails the check
    p.request_heater_check();
    for (int s = 0; s < Pipeline::kHeaterCheckS; ++s, t += 1000) {
        feed(t, 0.0F, 0.0F, 9.0F);
    }
    TEST_ASSERT_EQUAL_STRING("check-fail", d.heater.reflector_status);
    const auto doc = parse(TelemetryFormatter::build_state_json(d, "t", WifiInfo{}));
    TEST_ASSERT_EQUAL_STRING("check-fail", doc["heater"]["reflector_status"].as<const char*>());
    TEST_ASSERT_FLOAT_WITHIN(0.01F, 9.0F, doc["heater"]["probe_c"].as<float>());
    TEST_ASSERT_FLOAT_WITHIN(0.01F, 5.02F, doc["heater"]["rail_logic_v"].as<float>());
    TEST_ASSERT_FLOAT_WITHIN(0.01F, 12.0F, doc["heater"]["rail_heat_v"].as<float>());
}

// ---------------------------------------------------------------- crown link (STM32 crown v2)
void test_crown_blocks_decode_into_pipeline_types(void) {
    crown::WindBlock w{};
    w.seq = 3;
    w.tof_ps[crown::kNS] = 281250000U;
    w.tof_ps[crown::kSN] = 283000000U;
    w.tof_ps[crown::kEW] = 282100000U;
    w.tof_ps[crown::kWE] = 282100000U;
    for (auto& s : w.snr_db) s = 34;
    w.corr_pct[0] = 97;
    w.corr_pct[1] = 92;
    crown::seal(w);
    std::uint8_t raw[sizeof(w)];
    std::memcpy(raw, &w, sizeof w);
    crown::WindBlock got{};
    TEST_ASSERT_TRUE(crown::decode(raw, sizeof raw, got));
    station::wind::TofQuad q{};
    station::crown_link::WindQuality wq{};
    TEST_ASSERT_TRUE(station::crown_link::to_tof_quad(got, q, wq));
    TEST_ASSERT_FLOAT_WITHIN(1e-3F, 281.25F, q.t_ns_us);
    TEST_ASSERT_FLOAT_WITHIN(1e-3F, 283.0F, q.t_sn_us);
    TEST_ASSERT_EQUAL_UINT8(92, wq.min_corr_pct);
    // one bad path -> the quad is not used (no bogus gust from a rain-splashed path)
    got.flags[crown::kEW] = crown::kPathLowCorr;
    TEST_ASSERT_FALSE(station::crown_link::to_tof_quad(got, q, wq));
    TEST_ASSERT_EQUAL_UINT8(1, wq.bad_paths);

    crown::RainEvent re{};
    re.age_ms = 40;
    re.peak_mv = 512;
    re.width_us = 900;
    const auto imp = station::crown_link::to_rain_impact(re, 10000, 1.5F);
    TEST_ASSERT_EQUAL_UINT32(9960, imp.t_ms);
    TEST_ASSERT_EQUAL_UINT16(768, imp.peak_mv);     // 512 mV x rain_impact_scale 1.5
    TEST_ASSERT_EQUAL_UINT16(0, imp.baseline_mv);   // no capacitive wetness channel on crown v2

    // HapticRain with crown impacts: dry until rain is detected, wet while the event runs, mast shake does not
    // reject ordinary short drop pulses
    HapticRainProcessor hr;
    TEST_ASSERT_FALSE(hr.metrics().surface_wet);
    station::rain::RainImpactEvent ev{};
    ev.peak_mv = 600;
    ev.baseline_mv = 0;
    ev.pulse_width_us = 300;
    ev.imu_vibration_g = 0.3F;   // windy mast
    TEST_ASSERT_TRUE(hr.process_impact(ev) > 0.0F);
    hr.tick_second();
    TEST_ASSERT_TRUE(hr.metrics().surface_wet);
    ev.pulse_width_us = 2000;     // long ring = mast knock, still rejected
    TEST_ASSERT_EQUAL_FLOAT(0.0F, hr.process_impact(ev));

    // boot-time auto-update decision
    const std::uint8_t img[3] = {0, 2, 0};
    const std::uint8_t same[4] = {crown::kProtocolVersion, 0, 2, 0};
    const std::uint8_t older[4] = {crown::kProtocolVersion, 0, 1, 0};
    const std::uint8_t old_proto[4] = {static_cast<std::uint8_t>(crown::kProtocolVersion - 1), 0, 2, 0};
    TEST_ASSERT_FALSE(station::crown_link::crown_needs_update(same, img, 32000));
    TEST_ASSERT_TRUE(station::crown_link::crown_needs_update(older, img, 32000));
    TEST_ASSERT_TRUE(station::crown_link::crown_needs_update(old_proto, img, 32000));
    TEST_ASSERT_TRUE(station::crown_link::crown_needs_update(nullptr, img, 32000));    // blank / absent crown
    TEST_ASSERT_FALSE(station::crown_link::crown_needs_update(nullptr, img, 0));       // nothing embedded

    crown::StrikeEvent se{};
    se.kind = 1;
    se.distance_km = 14;
    se.energy = 123456;
    se.age_ms = 300;
    station::core::LightningStrike ls{};
    TEST_ASSERT_TRUE(station::crown_link::to_strike(se, 5000, ls));
    TEST_ASSERT_EQUAL_UINT32(4700, ls.t_ms);
    TEST_ASSERT_EQUAL_UINT8(14, ls.distance_km);
    se.kind = 2;   // disturber
    TEST_ASSERT_FALSE(station::crown_link::to_strike(se, 5000, ls));
}

namespace {
// Minimal STM32 ROM bootloader model speaking AN4221 (no-stretch commands) at one I2C address.
class FakeRom : public station::crown_link::BootTransport {
public:
    std::uint8_t addr{crown::kBootloaderAddrB};
    bool boot0{false}, in_rom{false};
    std::vector<std::uint8_t> flash = std::vector<std::uint8_t>(128 * 1024, 0x00);
    std::vector<std::uint8_t> out;   // bytes the master will read
    int step{0};
    std::uint8_t cmd{0};
    std::uint32_t mem_addr{0};
    bool erased{false};
    int busy_polls{0};

    void ack() { out.push_back(0x79); }
    void nack() { out.push_back(0x1F); }
    static bool sum_ok(const std::uint8_t* d, std::size_t n) {
        std::uint8_t x = 0;
        for (std::size_t i = 0; i + 1 < n; ++i) x ^= d[i];
        return x == d[n - 1];
    }
    bool write(std::uint8_t a, const std::uint8_t* d, std::size_t n) override {
        if (!in_rom || a != addr) return false;
        if (step == 0) {
            if (n != 2 || d[1] != static_cast<std::uint8_t>(~d[0])) { nack(); return true; }
            cmd = d[0];
            ack();
            if (cmd == 0x00) { out.insert(out.end(), {3, 0x31, 0x00, 0x02, 0x11}); ack(); }
            else if (cmd == 0x02) { out.insert(out.end(), {1, 0x04, 0x68}); ack(); }
            else step = 1;
            return true;
        }
        if (cmd == 0x45) {   // erase NS
            if (n == 3 && d[0] == 0xFF && d[1] == 0xFF && sum_ok(d, 3)) {
                std::fill(flash.begin(), flash.end(), 0xFF);
                erased = true;
                busy_polls = 3;
            } else {
                nack();
            }
            step = 0;
            return true;
        }
        if (step == 1) {     // address
            if (n != 5 || !sum_ok(d, 5)) { nack(); step = 0; return true; }
            mem_addr = (std::uint32_t(d[0]) << 24) | (std::uint32_t(d[1]) << 16) | (std::uint32_t(d[2]) << 8) | d[3];
            ack();
            step = 2;
            return true;
        }
        if (cmd == 0x32) {   // write NS: N-1, data, checksum
            const std::size_t len = std::size_t(d[0]) + 1;
            if (n != len + 2 || !sum_ok(d, n) || !erased) { nack(); step = 0; return true; }
            for (std::size_t i = 0; i < len; ++i) flash[mem_addr - 0x08000000U + i] &= d[1 + i];
            ack();
            step = 0;
            return true;
        }
        if (cmd == 0x11) {   // read: N-1 + complement
            if (n != 2 || d[1] != static_cast<std::uint8_t>(~d[0])) { nack(); step = 0; return true; }
            ack();
            const std::size_t len = std::size_t(d[0]) + 1;
            for (std::size_t i = 0; i < len; ++i) out.push_back(flash[mem_addr - 0x08000000U + i]);
            step = 0;
            return true;
        }
        return false;
    }
    bool read(std::uint8_t a, std::uint8_t* d, std::size_t n) override {
        if (!in_rom || a != addr) return false;
        if (busy_polls > 0 && n == 1) {
            --busy_polls;
            d[0] = 0x76;
            if (busy_polls == 0) ack();
            return true;
        }
        if (out.size() < n) return false;
        std::copy(out.begin(), out.begin() + static_cast<long>(n), d);
        out.erase(out.begin(), out.begin() + static_cast<long>(n));
        return true;
    }
    void delay_ms(std::uint32_t) override {}
    void set_boot0(bool high) override { boot0 = high; }
    void reset_pulse() override {
        in_rom = boot0;
        step = 0;
        out.clear();
    }
};
}  // namespace

void test_crown_rom_bootloader_flashes_and_verifies(void) {
    FakeRom rom;
    station::crown_link::StmI2cBootloader bl(rom);
    std::vector<std::uint8_t> image(3001);
    for (std::size_t i = 0; i < image.size(); ++i) image[i] = static_cast<std::uint8_t>(i * 7 + 3);
    const auto r = bl.flash(image.data(), image.size());
    TEST_ASSERT_EQUAL(static_cast<int>(station::crown_link::StmI2cBootloader::Result::Ok), static_cast<int>(r));
    TEST_ASSERT_EQUAL_HEX8(crown::kBootloaderAddrB, bl.address());   // found at the second candidate address
    TEST_ASSERT_EQUAL_MEMORY(image.data(), rom.flash.data(), image.size());
    TEST_ASSERT_EQUAL_HEX8(0xFF, rom.flash[image.size()]);            // padding stays erased
    TEST_ASSERT_FALSE(rom.boot0);                                      // BOOT0 released: boots the application
    TEST_ASSERT_FALSE(rom.in_rom);

    FakeRom absent;
    absent.addr = 0x10;   // nothing answers at the bootloader addresses
    station::crown_link::StmI2cBootloader bl2(absent);
    TEST_ASSERT_EQUAL(static_cast<int>(station::crown_link::StmI2cBootloader::Result::NoBootloader),
                      static_cast<int>(bl2.flash(image.data(), image.size())));
    TEST_ASSERT_FALSE(absent.boot0);
}

void test_still_air_wind_calibration(void) {
    using station::wind::StillAirCalibrator;
    using station::wind::TofQuad;
    // 18 C, 60 % RH, 1005 hPa; true crown delay 57.3 us, reciprocal asymmetries +0.8 us (N-S) / -0.3 us (E-W)
    const float c = StillAirCalibrator::sound_speed_m_s(18.0F, 60.0F, 1005.0F);
    const float t0 = StillAirCalibrator::path_length_m() / c * 1e6F + 57.3F;
    StillAirCalibrator cal;
    for (int i = 0; i < 200; ++i) {
        const float jitter = 0.05F * std::sin(static_cast<float>(i) * 1.3F);   // still air: tiny scatter
        TofQuad q{};
        q.t_ns_us = t0 + 0.4F + jitter;
        q.t_sn_us = t0 - 0.4F - jitter;
        q.t_ew_us = t0 - 0.15F;
        q.t_we_us = t0 + 0.15F;
        cal.add(q);
    }
    const auto r = cal.result(18.0F, 60.0F, 1005.0F);
    TEST_ASSERT_TRUE(r.ok);
    TEST_ASSERT_FLOAT_WITHIN(0.02F, 57.3F, r.us_delay_us);
    TEST_ASSERT_FLOAT_WITHIN(0.01F, 0.8F, r.zero.dt_ns_offset_us);
    TEST_ASSERT_FLOAT_WITHIN(0.01F, -0.3F, r.zero.dt_ew_offset_us);
    // applying the result: still air reads 0 m/s and the acoustic temperature is the virtual temperature
    // (18 C, e = 12.4 hPa: Tv = 291.15 K x (1 + 0.32 x 12.4 / 1005) = 19.15 C)
    TofQuad q{};
    q.t_ns_us = t0 + 0.4F - r.us_delay_us;
    q.t_sn_us = t0 - 0.4F - r.us_delay_us;
    q.t_ew_us = t0 - 0.15F - r.us_delay_us;
    q.t_we_us = t0 + 0.15F - r.us_delay_us;
    const auto s = station::wind::UltrasonicWindSolver::solve(q, station::wind::ImuCompassReading{}, r.zero);
    TEST_ASSERT_TRUE(s.valid);
    TEST_ASSERT_FLOAT_WITHIN(0.06F, 0.0F, s.speed_m_s);
    TEST_ASSERT_FLOAT_WITHIN(0.1F, 19.15F, s.acoustic_temp_c);

    // moving air (reciprocal differences scattering by several us) is refused instead of calibrating a wind in
    StillAirCalibrator windy;
    for (int i = 0; i < 200; ++i) {
        TofQuad w{};
        const float gust = (i % 2 ? 3.0F : -3.0F);
        w.t_ns_us = t0 + gust;
        w.t_sn_us = t0 - gust;
        w.t_ew_us = w.t_we_us = t0;
        windy.add(w);
    }
    TEST_ASSERT_FALSE(windy.result(18.0F, 60.0F, 1005.0F).ok);
    StillAirCalibrator few;
    few.add(TofQuad{});
    TEST_ASSERT_FALSE(few.result(18.0F, 60.0F, 1005.0F).ok);
}

void test_optics_cover_transmission(void) {
    const StationConfig c{};
    TEST_ASSERT_FLOAT_WITHIN(1e-6F, 0.11F, c.optics_transmission);          // default cover: PTFE hemisphere
    TEST_ASSERT_FLOAT_WITHIN(1e-3F, 10.0F, station::core::cover_corrected(1.1F, 0.11F));   // UVI behind the diffuser
    TEST_ASSERT_FLOAT_WITHIN(1.0F, 108696.0F, station::core::cover_corrected(100000.0F, 0.92F));   // JGS1 window
    TEST_ASSERT_FLOAT_WITHIN(1e-3F, 50.0F, station::core::cover_corrected(1.0F, 0.0F));    // clamped to 0.02
    TEST_ASSERT_FLOAT_WITHIN(1e-6F, 3.0F, station::core::cover_corrected(3.0F, 1.5F));     // clamped to 1
}

// Home calibration (src/calibration): the math against known answers, and each session from start to Apply.
void test_home_calibration_math(void) {
    namespace cal = station::calibration;
    TEST_ASSERT_FLOAT_WITHIN(1e-4F, -10.0F, cal::wrap180(350.0F));
    TEST_ASSERT_FLOAT_WITHIN(1e-4F, 350.0F, cal::wrap360(-10.0F));
    const float across_north[] = {350.0F, 10.0F, 355.0F, 5.0F};
    TEST_ASSERT_FLOAT_WITHIN(0.01F, 0.0F, cal::wrap180(cal::circular_mean_deg(across_north, 4)));
    TEST_ASSERT_FLOAT_WITHIN(0.01F, 0.0F, cal::initial_bearing_deg(54.0, 25.0, 55.0, 25.0));
    TEST_ASSERT_FLOAT_WITHIN(0.01F, 90.0F, cal::initial_bearing_deg(0.0, 10.0, 0.0, 11.0));
    TEST_ASSERT_FLOAT_WITHIN(0.5F, 270.0F, cal::initial_bearing_deg(54.6872, 25.2797, 54.6872, 25.20));
    // the QNH inverse reproduces the pipeline reduction
    const float qnh = MetCalculator::sea_level_pressure_hpa(998.4F, 12.0F, 112.0F);
    TEST_ASSERT_FLOAT_WITHIN(0.2F, 112.0F, cal::elevation_from_qnh_m(998.4F, qnh, 12.0F));
    TEST_ASSERT_FLOAT_WITHIN(0.01F, 75.47F, cal::salt_rh_pct(20.0F));
    TEST_ASSERT_FLOAT_WITHIN(0.01F, 75.38F, cal::salt_rh_pct(22.5F));
    // drops: 2 mm terminal velocity ~6.5 m/s; a long fall reaches the HapticRain terminal-velocity amplitude
    TEST_ASSERT_FLOAT_WITHIN(0.1F, 6.55F, cal::drop_terminal_velocity_m_s(2.0F));
    TEST_ASSERT_FLOAT_WITHIN(5.0F, 1000.0F, cal::expected_drop_mv(18.5F, 40.0F));
    const float e15 = cal::expected_drop_mv(50.0F, 1.5F);   // 20 drops / ml from 1.5 m
    TEST_ASSERT_TRUE(e15 > 550.0F && e15 < 750.0F);
    TEST_ASSERT_TRUE(cal::expected_drop_mv(50.0F, 3.0F) > e15);
    // compass: shifted, squashed horizontal circle, two turns
    float x[180], y[180];
    for (int i = 0; i < 180; ++i) {
        const float a = 4.0F * 3.14159265F * static_cast<float>(i) / 180.0F;
        x[i] = 12.0F + 20.0F * std::cos(a);
        y[i] = -7.0F + 16.0F * std::sin(a);
    }
    const cal::CompassFit f = cal::fit_compass(x, y, 180);
    TEST_ASSERT_TRUE(f.ok);
    TEST_ASSERT_FLOAT_WITHIN(0.1F, 12.0F, f.offset_x);
    TEST_ASSERT_FLOAT_WITHIN(0.1F, -7.0F, f.offset_y);
    TEST_ASSERT_FLOAT_WITHIN(0.1F, 20.0F * f.scale_x, 16.0F * f.scale_y);
    TEST_ASSERT_EQUAL_INT(12, f.coverage_bins);
    TEST_ASSERT_FALSE(cal::fit_compass(x, y, 45).ok);   // a quarter turn per 45 samples: not enough directions
}

void test_home_calibration_sessions(void) {
    namespace cal = station::calibration;
    StationConfig cfg{};
    cal::Calibrator c;
    std::uint32_t t = 1000;
    auto feed = [&](int n, const std::function<void(cal::Sample&, int)>& fill) {
        for (int i = 0; i < n; ++i) {
            cal::Sample s{};
            s.t_ms = t;
            fill(s, i);
            c.add_sample(s, cfg);
            t += 1000;
        }
    };
    // compass spin -> offsets applied + date stamp
    c.start(cal::Kind::Compass, 0, 0, 0, cfg, t);
    feed(91, [](cal::Sample& s, int i) {
        const float a = 4.0F * 3.14159265F * static_cast<float>(i) / 90.0F;
        s.mag_ok = true;
        s.mag_ut = {30.0F + 18.0F * std::cos(a), 5.0F + 18.0F * std::sin(a), -45.0F};
    });
    TEST_ASSERT_TRUE(c.result_ok());
    TEST_ASSERT_TRUE(c.apply(cfg, 1700000000));
    TEST_ASSERT_FLOAT_WITHIN(0.2F, 30.0F, cfg.mag_offset_ut[0]);
    TEST_ASSERT_EQUAL_UINT32(1700000000U, cfg.cal_unix[static_cast<int>(cal::Kind::Compass)]);
    TEST_ASSERT_FALSE(c.apply(cfg, 1700000001));   // only once
    const station::core::Vec3 m = cal::corrected_mag({48.0F, 5.0F, -45.0F}, cfg);
    TEST_ASSERT_FLOAT_WITHIN(0.3F, 18.0F, m.x);

    // north reference: compass says 350, the N mark is at 10 -> +20 deg; fixed heading skips the magnetometer
    c.start(cal::Kind::Heading, 10.0F, 0, 0, cfg, t);
    feed(16, [](cal::Sample& s, int) { s.heading_ok = true; s.heading_deg = 350.0F; });
    TEST_ASSERT_TRUE(c.apply(cfg, 1));
    TEST_ASSERT_FLOAT_WITHIN(0.01F, 20.0F, cfg.heading_offset_deg);
    bool changed = false;
    const std::string st = c.handle(R"({"cmd":"start","kind":"heading","p1":123.5,"fixed":true})", cfg, 2, t, changed);
    TEST_ASSERT_TRUE(st.find("\"state\":\"done\"") != std::string::npos);
    c.handle(R"({"cmd":"apply"})", cfg, 2, t, changed);
    TEST_ASSERT_TRUE(changed);
    TEST_ASSERT_EQUAL_UINT8(1, cfg.heading_mode);
    TEST_ASSERT_FLOAT_WITHIN(0.01F, 123.5F, cfg.heading_fixed_deg);

    // car runs: 10 m/s GPS both ways, station 9 and 11 m/s (tail / head wind) -> gain 1.0 after two runs
    for (float station_raw : {9.0F, 11.0F}) {
        c.start(cal::Kind::CarRun, 0, 0, 0, cfg, t);
        feed(40, [station_raw](cal::Sample& s, int) { s.wind_ok = true; s.wind_raw_m_s = station_raw; });
        TEST_ASSERT_EQUAL(station_raw == 9.0F ? false : true, c.finish(10.0F, cfg, t));
    }
    TEST_ASSERT_TRUE(c.apply(cfg, 3));
    TEST_ASSERT_FLOAT_WITHIN(1e-3F, 1.0F, cfg.wind_speed_gain);

    // drop test: impacts at half the expected amplitude -> impact scale 2
    c.start(cal::Kind::DropTest, 20.0F, 1.5F, 0, cfg, t);
    const float expected = cal::expected_drop_mv(50.0F, 1.5F);
    for (int i = 0; i < 12; ++i) c.add_rain_peak(static_cast<std::uint16_t>(std::lround(expected / 2.0F + (i % 3) - 1)));
    TEST_ASSERT_TRUE(c.finish(0.0F, cfg, t));
    TEST_ASSERT_TRUE(c.apply(cfg, 4));
    TEST_ASSERT_FLOAT_WITHIN(0.02F, 2.0F, cfg.rain_impact_scale);

    // rain gauge: the station counted 4 mm (with one reset in between), the container 5 mm -> gain x1.25
    c.start(cal::Kind::RainGauge, 0, 0, 0, cfg, t);
    feed(60, [](cal::Sample& s, int i) {
        s.rain_ok = true;
        s.rain_total_mm = i < 30 ? 0.1F * static_cast<float>(i) : 0.1F * static_cast<float>(i - 30);
    });
    TEST_ASSERT_TRUE(c.finish(5.0F, cfg, t));
    TEST_ASSERT_TRUE(c.apply(cfg, 5));
    TEST_ASSERT_FLOAT_WITHIN(0.02F, 5.0F / 5.8F, cfg.rain_gain);

    // airport QNH -> elevation
    const float p_stn = 1000.0F;
    const float q = MetCalculator::sea_level_pressure_hpa(p_stn, 10.0F, 250.0F);
    c.start(cal::Kind::Pressure, q, 0, 0, cfg, t);
    feed(61, [p_stn](cal::Sample& s, int) { s.pressure_ok = s.temp_ok = true; s.station_hpa = p_stn; s.temp_c = 10.0F; });
    TEST_ASSERT_TRUE(c.apply(cfg, 6));
    TEST_ASSERT_FLOAT_WITHIN(0.3F, 250.0F, cfg.altitude_m);

    // known elevation: map ground 101.5 m + 9 m mast/roof, no measurement needed
    c.start(cal::Kind::Pressure, 101.5F, 1.0F, 9.0F, cfg, t);
    TEST_ASSERT_TRUE(c.apply(cfg, 6));
    TEST_ASSERT_FLOAT_WITHIN(1e-3F, 110.5F, cfg.altitude_m);

    // clear sky at 40 deg sun with an 0.13 cover; clouds (light varying) are refused
    const float clear_lux = station::astro::Astronomy::clear_sky_ghi_w_m2(40.0F) * cal::kLuxPerWm2;
    c.start(cal::Kind::ClearSky, 0, 0, 0, cfg, t);
    feed(121, [clear_lux](cal::Sample& s, int) { s.lux_ok = s.sun_ok = true; s.lux_raw = 0.13F * clear_lux; s.sun_alt_deg = 40.0F; });
    TEST_ASSERT_TRUE(c.apply(cfg, 7));
    TEST_ASSERT_FLOAT_WITHIN(1e-3F, 0.13F, cfg.optics_transmission);
    c.start(cal::Kind::ClearSky, 0, 0, 0, cfg, t);
    feed(121, [clear_lux](cal::Sample& s, int i) { s.lux_ok = s.sun_ok = true; s.lux_raw = (i % 20 < 10 ? 0.13F : 0.06F) * clear_lux; s.sun_alt_deg = 40.0F; });
    TEST_ASSERT_FALSE(c.result_ok());

    // UV self-reference: LTR-390 sees 0.65 UVI behind the 0.13 cover = UVI 5; GUVB 40 counts -> 8 counts per UVI
    c.start(cal::Kind::UvReference, 0, 1.0F, 0, cfg, t);
    feed(61, [](cal::Sample& s, int) { s.guvb_ok = s.ltr_uvi_ok = true; s.guvb_counts = 40.0F; s.ltr_uvi_raw = 0.65F; });
    TEST_ASSERT_TRUE(c.apply(cfg, 8));
    TEST_ASSERT_FLOAT_WITHIN(1e-3F, 8.0F, cfg.guvb_counts_per_uvi);

    // salt jar 73.5 % at 20 C -> +1.97 %, applied on top of the sensor reading; still-drifting RH is refused
    c.start(cal::Kind::SaltRh, 0, 0, 0, cfg, t);
    feed(601, [](cal::Sample& s, int) { s.rh_ok = s.temp_ok = true; s.rh_pct = 73.5F; s.temp_c = 20.0F; });
    TEST_ASSERT_TRUE(c.apply(cfg, 8));
    TEST_ASSERT_FLOAT_WITHIN(0.01F, 1.97F, cfg.rh_offset_pct);
    c.start(cal::Kind::SaltRh, 0, 0, 0, cfg, t);
    feed(601, [](cal::Sample& s, int i) { s.rh_ok = s.temp_ok = true; s.rh_pct = 70.0F + 0.01F * i; s.temp_c = 20.0F; });
    TEST_ASSERT_FALSE(c.result_ok());

    // ice point 0.3 C -> -0.3 C
    c.start(cal::Kind::IcePoint, 0, 0, 0, cfg, t);
    feed(301, [](cal::Sample& s, int) { s.temp_ok = true; s.temp_c = 0.3F; });
    TEST_ASSERT_TRUE(c.apply(cfg, 9));
    TEST_ASSERT_FLOAT_WITHIN(1e-4F, -0.3F, cfg.temp_offset_c);

    // fresh air: Apply hands a 425 ppm FRC to the firmware once
    c.start(cal::Kind::Co2FreshAir, 0, 0, 0, cfg, t);
    feed(181, [](cal::Sample& s, int i) { s.co2_ok = true; s.co2_ppm = 440.0F + static_cast<float>(i % 5); });
    float ppm = 0.0F;
    TEST_ASSERT_FALSE(c.take_frc_request(ppm));
    TEST_ASSERT_TRUE(c.apply(cfg, 10));
    TEST_ASSERT_TRUE(c.take_frc_request(ppm));
    TEST_ASSERT_FLOAT_WITHIN(1e-3F, 425.0F, ppm);
    TEST_ASSERT_FALSE(c.take_frc_request(ppm));

    // invalid input is refused without starting; status JSON is well-formed
    const std::string bad = c.handle(R"({"cmd":"start","kind":"pressure","p1":29.9})", cfg, 11, t, changed);
    JsonDocument doc;
    TEST_ASSERT_TRUE(deserializeJson(doc, bad) == DeserializationError::Ok);
    TEST_ASSERT_EQUAL_STRING("done", doc["state"].as<const char*>());
    TEST_ASSERT_FALSE(doc["ok"].as<bool>());
    TEST_ASSERT_TRUE(doc["stamps"]["compass"].as<std::uint32_t>() == 1700000000U);
}

void test_home_calibration_sample_undoes_corrections(void) {
    namespace cal = station::calibration;
    StationConfig cfg{};
    cfg.temp_offset_c = 0.5F;
    cfg.rh_offset_pct = -2.0F;
    cfg.optics_transmission = 0.1F;
    cfg.wind_speed_gain = 1.25F;
    station::core::RawState raw{};
    raw.now_ms = 5000;
    raw.thermo.temp_c.set(20.5F, 5000);
    raw.thermo.rh_pct.set(48.0F, 5000);
    raw.optical.tsl_lux.set(50000.0F, 5000);
    station::core::WindSecond w{};
    w.speed_mean_m_s = 5.0F;
    raw.wind.second.set(w, 5000);
    station::core::DerivedState d{};
    const station::core::Vec3 mag{10.0F, 0.0F, -40.0F};
    const cal::Sample s = cal::make_sample(raw, d, cfg, &mag);
    TEST_ASSERT_FLOAT_WITHIN(1e-4F, 20.0F, s.temp_c);
    TEST_ASSERT_FLOAT_WITHIN(1e-4F, 50.0F, s.rh_pct);
    TEST_ASSERT_FLOAT_WITHIN(1e-2F, 5000.0F, s.lux_raw);
    TEST_ASSERT_FLOAT_WITHIN(1e-4F, 4.0F, s.wind_raw_m_s);
    TEST_ASSERT_TRUE(s.heading_ok);
    TEST_ASSERT_FLOAT_WITHIN(0.5F, 90.0F, s.heading_deg);   // field along +x: same convention as the wind solver
}

// Data quality (src/quality): range / step / persistence / consistency flags and the station health list.
void test_quality_flags_and_station_health(void) {
    using station::core::QcFlag;
    using station::core::QcMetric;
    using station::core::HealthStatus;
    station::quality::QualityControl qc;
    StationConfig cfg{};
    station::core::RawState raw{};
    auto flag = [](const station::core::DerivedState& d, QcMetric m) { return d.quality.qc[static_cast<int>(m)].flag; };
    auto run = [&](int seconds, const std::function<void(station::core::DerivedState&, int)>& fill) {
        station::core::DerivedState d{};
        for (int i = 0; i < seconds; ++i) {
            d = station::core::DerivedState{};
            raw.now_ms += 1000;
            fill(d, i);
            qc.step(raw, cfg, d);
        }
        return d;
    };
    // missing -> missing; out of range -> fail
    auto d = run(1, [](station::core::DerivedState&, int) {});
    TEST_ASSERT_TRUE(flag(d, QcMetric::TempC) == QcFlag::Missing);
    d = run(1, [](station::core::DerivedState& x, int) { x.thermo.temp_c.set(80.0F); });
    TEST_ASSERT_TRUE(flag(d, QcMetric::TempC) == QcFlag::Fail);
    // a 5 K jump within a minute is a spike, held suspect for 10 min, then good again
    d = run(130, [](station::core::DerivedState& x, int i) { x.thermo.temp_c.set(i < 70 ? 10.0F + 0.001F * i : 15.0F); });
    TEST_ASSERT_TRUE(flag(d, QcMetric::TempC) == QcFlag::Suspect);
    d = run(700, [](station::core::DerivedState& x, int i) { x.thermo.temp_c.set(15.0F + 0.001F * (i % 50)); });
    TEST_ASSERT_TRUE(flag(d, QcMetric::TempC) == QcFlag::Good);
    // station pressure frozen for 3 h -> stuck; a slow real drift stays good
    d = run(3 * 3600 + 5, [](station::core::DerivedState& x, int) { x.baro.station_hpa.set(1001.30F); });
    TEST_ASSERT_TRUE(flag(d, QcMetric::PressureHpa) == QcFlag::Suspect);
    TEST_ASSERT_EQUAL_STRING("no change for hours (stuck)", d.quality.qc[static_cast<int>(QcMetric::PressureHpa)].reason);
    d = run(3 * 3600 + 5, [](station::core::DerivedState& x, int i) { x.baro.station_hpa.set(1001.30F + 0.0001F * i); });
    TEST_ASSERT_TRUE(flag(d, QcMetric::PressureHpa) == QcFlag::Good);
    // consistency: sunlight at night, irradiance far above clear sky, rain at 30 % RH, CO2 below background
    d = run(2, [](station::core::DerivedState& x, int) {
        x.astro.location_set = true;
        x.astro.sun_alt_deg.set(-12.0F);
        x.solar.irradiance_w_m2.set(80.0F);
        x.solar.clear_sky_w_m2.set(0.0F);
        x.rain.sensor_ok = true;
        x.rain.rate_mm_h = 3.0F;
        x.thermo.rh_pct.set(30.0F);
        x.air.co2_ppm.set(320.0F);
    });
    TEST_ASSERT_TRUE(flag(d, QcMetric::Irradiance) == QcFlag::Suspect);
    TEST_ASSERT_TRUE(flag(d, QcMetric::RainRate) == QcFlag::Suspect);
    TEST_ASSERT_TRUE(flag(d, QcMetric::Co2) == QcFlag::Suspect);
    d = run(1, [](station::core::DerivedState& x, int) {
        x.solar.irradiance_w_m2.set(1400.0F);
        x.solar.clear_sky_w_m2.set(700.0F);
    });
    TEST_ASSERT_TRUE(flag(d, QcMetric::Irradiance) == QcFlag::Suspect);

    // health: nothing connected -> failures; a healthy supply and rails -> ok entries
    auto entry = [](const station::core::DerivedState& x, const char* id) -> const station::core::HealthEntry* {
        for (int i = 0; i < x.quality.n_health; ++i) {
            if (std::strcmp(x.quality.health[i].id, id) == 0) return &x.quality.health[i];
        }
        return nullptr;
    };
    d = run(1, [](station::core::DerivedState&, int) {});
    TEST_ASSERT_TRUE(d.quality.summary == HealthStatus::Fail);
    TEST_ASSERT_NOT_NULL(entry(d, "wind"));
    TEST_ASSERT_TRUE(entry(d, "wind")->status == HealthStatus::Fail);
    d = run(1, [](station::core::DerivedState& x, int) {
        x.heater.vin_v.set(11.2F);
        x.heater.rail_logic_v.set(5.02F);
        x.heater.rail_heat_v.set(10.1F);
    });
    TEST_ASSERT_TRUE(entry(d, "supply")->status == HealthStatus::Warn);
    TEST_ASSERT_EQUAL_STRING("low input voltage", entry(d, "supply")->detail);
    TEST_ASSERT_EQUAL_STRING("", entry(d, "rail_5v")->detail);
    TEST_ASSERT_TRUE(entry(d, "rail_5v")->status == HealthStatus::Ok);
    TEST_ASSERT_TRUE(entry(d, "rail_heat")->status == HealthStatus::Ok);   // input minus ~1 V below 13.5 V
    cfg.heading_mode = 1;
    d = run(1, [](station::core::DerivedState&, int) {});
    TEST_ASSERT_TRUE(entry(d, "compass")->status == HealthStatus::Off);

    // published: quality flags, health list incl. Wi-Fi, summary
    station::telemetry::WifiInfo wifi{};
    wifi.connected = true;
    wifi.rssi_dbm = -84;
    JsonDocument doc;
    TEST_ASSERT_TRUE(deserializeJson(doc, TelemetryFormatter::build_state_json(d, "t", wifi)) == DeserializationError::Ok);
    TEST_ASSERT_EQUAL_STRING("missing", doc["quality"]["temp_c"]["flag"].as<const char*>());
    TEST_ASSERT_EQUAL_STRING("fail", doc["health_summary"].as<const char*>());
    bool wifi_seen = false;
    for (JsonObject o : doc["health"].as<JsonArray>()) {
        if (std::strcmp(o["id"] | "", "wifi") == 0) {
            wifi_seen = true;
            TEST_ASSERT_EQUAL_STRING("fail", o["status"].as<const char*>());
        }
    }
    TEST_ASSERT_TRUE(wifi_seen);
}

void test_lightning_seismic_health_rs485_decode_and_mqtt_topic(void) {
    using station::core::HealthStatus;
    station::quality::QualityControl qc;
    StationConfig cfg{};
    station::core::RawState raw{};
    station::core::DerivedState d{};
    auto entry = [&d](const char* id) -> const station::core::HealthEntry* {
        for (int i = 0; i < d.quality.n_health; ++i) {
            if (std::strcmp(d.quality.health[i].id, id) == 0) return &d.quality.health[i];
        }
        return nullptr;
    };
    auto tick = [&](int n) {
        for (int i = 0; i < n; ++i) {
            raw.now_ms += 1000;
            if (raw.crown.as3935_lco_hz.valid) raw.crown.as3935_lco_hz.set(raw.crown.as3935_lco_hz.value, raw.now_ms);
            d = station::core::DerivedState{};
            qc.step(raw, cfg, d);
        }
    };
    tick(1);
    TEST_ASSERT_TRUE(entry("lightning")->status == HealthStatus::Fail);    // no crown diagnostics
    TEST_ASSERT_TRUE(entry("seismic")->status == HealthStatus::Fail);
    raw.crown.as3935_lco_hz.set(500300U, raw.now_ms);
    station::core::VibrationSecond vs{};
    raw.imu.vibration.set(vs, raw.now_ms + 1000);
    tick(1);
    TEST_ASSERT_TRUE(entry("lightning")->status == HealthStatus::Ok);
    TEST_ASSERT_FLOAT_WITHIN(0.01F, 500.3F, d.quality.as3935_antenna_khz.v);
    TEST_ASSERT_TRUE(entry("seismic")->status == HealthStatus::Ok);
    raw.crown.as3935_lco_hz.set(470000U, raw.now_ms);
    tick(1);
    TEST_ASSERT_TRUE(entry("lightning")->status == HealthStatus::Warn);   // antenna tuning off
    raw.crown.as3935_lco_hz.set(500000U, raw.now_ms);
    raw.crown.disturbers = 80;   // interference burst within one 10-min window
    tick(601);
    TEST_ASSERT_TRUE(entry("lightning")->status == HealthStatus::Warn);
    TEST_ASSERT_FLOAT_WITHIN(0.5F, 80.0F, d.quality.disturbers_10min.v);
    tick(601);   // quiet window
    TEST_ASSERT_TRUE(entry("lightning")->status == HealthStatus::Ok);

    // RS-485: the documented field list matches the frame, and bus activity is counted
    station::core::DerivedState f{};
    const std::string frame = station::rs485::Rs485Protocol::encode_telemetry_frame(f, 7);
    const std::size_t commas = static_cast<std::size_t>(std::count(frame.begin(), frame.end(), ','));
    TEST_ASSERT_EQUAL_UINT32(station::rs485::Rs485Protocol::kFrameFieldCount, commas);
    station::rs485::BusStats bus{};
    bus.note(station::rs485::CommandType::RequestState, "7:STATE?\r", 9, 1234);
    bus.note(station::rs485::CommandType::None, "3:STATE?", 8, 1300);
    TEST_ASSERT_EQUAL_UINT32(2, bus.lines);
    TEST_ASSERT_EQUAL_UINT32(1, bus.states);
    TEST_ASSERT_EQUAL_UINT32(1, bus.ignored);
    TEST_ASSERT_EQUAL_STRING("7:STATE?", bus.last_cmd);
    TEST_ASSERT_EQUAL_UINT32(1234, bus.last_ms);

    // MQTT: configured base topic, used by the Home Assistant discovery too
    TEST_ASSERT_EQUAL_STRING("aeromet/abc123/state", TelemetryFormatter::ha_state_topic("abc123").c_str());
    TEST_ASSERT_EQUAL_STRING("home/roof/state", TelemetryFormatter::ha_state_topic("abc123", "home/roof/").c_str());
    std::string topic, payload;
    TEST_ASSERT_TRUE(TelemetryFormatter::build_ha_discovery(0, "abc123", "homeassistant", topic, payload, "home/roof/state"));
    TEST_ASSERT_TRUE(payload.find("\"stat_t\":\"home/roof/state\"") != std::string::npos);
}

// Trends: records (today / yesterday / month / all time), speed-binned wind rose, persistence, CSV + JSON publishers.
void test_trends_records_windrose_and_exports(void) {
    namespace h = station::history;
    int y = 0;
    unsigned mo = 0, dd = 0;
    h::civil_from_days(20000, y, mo, dd);   // 2024-10-04
    TEST_ASSERT_EQUAL_INT(2024, y);
    TEST_ASSERT_EQUAL_UINT32(10, mo);
    TEST_ASSERT_EQUAL_UINT32(4, dd);

    h::Climate c;
    h::RecordInputs in{};
    in.temp_ok = true;
    const std::int64_t day0 = 20000;            // 2024-10-04 (local days)
    const std::int64_t t0 = day0 * 86400;
    in.temp_c = 12.0F;
    c.records().update(in, t0 + 3600, day0);
    in.temp_c = 18.5F;
    c.records().update(in, t0 + 50000, day0);
    in.temp_c = 9.0F;
    c.records().update(in, t0 + 86400 + 100, day0 + 1);   // next day: today -> yesterday
    const auto get = [&c](h::Period p, h::Rec r) { return c.records().get(p, r); };
    TEST_ASSERT_FLOAT_WITHIN(1e-4F, 18.5F, get(h::Period::Yesterday, h::Rec::TempMax).v);
    TEST_ASSERT_FLOAT_WITHIN(1e-4F, 9.0F, get(h::Period::Today, h::Rec::TempMax).v);
    TEST_ASSERT_FLOAT_WITHIN(1e-4F, 18.5F, get(h::Period::Month, h::Rec::TempMax).v);
    TEST_ASSERT_FLOAT_WITHIN(1e-4F, 9.0F, get(h::Period::AllTime, h::Rec::TempMin).v);
    TEST_ASSERT_TRUE(get(h::Period::AllTime, h::Rec::TempMax).unix_s == t0 + 50000);
    in.temp_c = 25.0F;
    c.records().update(in, (day0 + 30) * 86400, day0 + 30);   // November: month resets, all time keeps
    TEST_ASSERT_FLOAT_WITHIN(1e-4F, 25.0F, get(h::Period::Month, h::Rec::TempMin).v);
    TEST_ASSERT_FLOAT_WITHIN(1e-4F, 9.0F, get(h::Period::AllTime, h::Rec::TempMin).v);
    TEST_ASSERT_TRUE(get(h::Period::Yesterday, h::Rec::TempMax).unix_s == 0);   // a gap is not "yesterday"

    // wind rose: hour 1000 = 30 min from N at 3 m/s + 30 min from E at 9 m/s (closed -> stored), hour 1001 = 60 calm
    h::MemFlash fl(0x60000);
    h::HistoryStore st;
    TEST_ASSERT_TRUE(st.begin(&fl));
    station::history::TieredHistory tw;
    tw.attach(&st);
    tw.advance(1001 * 60, 1001, 41);
    h::WindRose& r = c.rose();
    r.advance(1000, 41);
    for (int i = 0; i < 30; ++i) r.add_minute(3.0F, 359.0F);
    for (int i = 0; i < 30; ++i) r.add_minute(9.0F, 92.0F);
    r.advance(1001, 41);
    std::int64_t ridx = 0;
    h::WindRose::Bucket bucket{};
    TEST_ASSERT_TRUE(r.take_closed(false, ridx, bucket));
    TEST_ASSERT_EQUAL_INT64(1000, ridx);
    TEST_ASSERT_FALSE(r.take_closed(true, ridx, bucket));   // the day has not closed
    h::ClosedInterval ci{};
    ci.idx = 1000;
    ci.rose = bucket;
    TEST_ASSERT_TRUE(st.append(h::Tier::Hour, ci));
    for (int i = 0; i < 60; ++i) r.add_minute(0.2F, 0.0F);
    JsonDocument doc;
    TEST_ASSERT_TRUE(deserializeJson(doc, TelemetryFormatter::build_windrose_json(tw, c, "24h")) == DeserializationError::Ok);
    TEST_ASSERT_EQUAL_UINT32(120, doc["minutes"].as<std::uint32_t>());
    TEST_ASSERT_FLOAT_WITHIN(0.01F, 50.0F, doc["calm_pct"].as<float>());
    TEST_ASSERT_FLOAT_WITHIN(0.01F, 25.0F, doc["pct"][0][1].as<float>());   // N, 2-4 m/s
    TEST_ASSERT_FLOAT_WITHIN(0.01F, 25.0F, doc["pct"][4][4].as<float>());   // E, 8-11 m/s
    float sum = doc["calm_pct"].as<float>();
    for (JsonArray row : doc["pct"].as<JsonArray>()) for (float v : row) sum += v;
    TEST_ASSERT_FLOAT_WITHIN(0.2F, 100.0F, sum);
    // > 24 h later (next day): the 24-h rose is empty, the 31-day rose sums the stored day
    r.advance(1030, 42);
    TEST_ASSERT_TRUE(r.take_closed(true, ridx, bucket));
    ci = h::ClosedInterval{};
    ci.idx = ridx;
    ci.rose = bucket;
    TEST_ASSERT_TRUE(st.append(h::Tier::Day, ci));
    tw.advance(1030 * 60, 1030, 42);
    TEST_ASSERT_TRUE(deserializeJson(doc, TelemetryFormatter::build_windrose_json(tw, c, "24h")) == DeserializationError::Ok);
    TEST_ASSERT_EQUAL_UINT32(0, doc["minutes"].as<std::uint32_t>());
    TEST_ASSERT_TRUE(deserializeJson(doc, TelemetryFormatter::build_windrose_json(tw, c, "31d")) == DeserializationError::Ok);
    TEST_ASSERT_EQUAL_UINT32(120, doc["minutes"].as<std::uint32_t>());

    // records persistence round trip (NVS blob)
    std::vector<std::uint8_t> buf(c.serialized_size());
    TEST_ASSERT_EQUAL_UINT32(buf.size(), c.serialize(buf.data(), buf.size()));
    h::Climate back;
    TEST_ASSERT_TRUE(back.deserialize(buf.data(), buf.size()));
    TEST_ASSERT_FLOAT_WITHIN(1e-4F, 9.0F, back.records().get(h::Period::AllTime, h::Rec::TempMin).v);
    buf[0] ^= 0xFF;
    TEST_ASSERT_FALSE(back.deserialize(buf.data(), buf.size()));

    // publishers
    station::history::TieredHistory th;
    th.advance(100, 10, 1);
    th.add(station::history::Metric::TempC, 10.0F);
    th.add(station::history::Metric::RainMm, 0.4F);
    th.advance(101, 10, 1);
    th.add(station::history::Metric::RainMm, 0.2F);
    station::core::DerivedState d{};
    d.thermo.temp_c.set(11.0F);
    TEST_ASSERT_TRUE(deserializeJson(doc, TelemetryFormatter::build_records_json(c, th, d)) == DeserializationError::Ok);
    TEST_ASSERT_FLOAT_WITHIN(1e-3F, 25.0F, doc["records"]["temp_max"]["today"]["v"].as<float>());
    TEST_ASSERT_TRUE(doc["records"]["gust_max"]["today"].isNull());
    TEST_ASSERT_TRUE(deserializeJson(doc, TelemetryFormatter::build_history_json(th, station::history::Tier::Minute, "rain_mm", 0)) ==
                     DeserializationError::Ok);
    JsonArray cum = doc["series"]["rain_mm"]["cum"].as<JsonArray>();
    TEST_ASSERT_FLOAT_WITHIN(1e-3F, 0.6F, cum[cum.size() - 1].as<float>());
    const std::string csv = TelemetryFormatter::build_history_csv(th, station::history::Tier::Minute, "temp_c,rain_mm", 7200);
    TEST_ASSERT_TRUE(csv.rfind("time,temp_c_mean,temp_c_min,temp_c_max,rain_mm\n", 0) == 0);
    TEST_ASSERT_EQUAL_UINT32(1 + 61, static_cast<std::uint32_t>(std::count(csv.begin(), csv.end(), '\n')));
    TEST_ASSERT_TRUE(csv.find("1970-01-01 03:40,10.00,10.00,10.00,0.40\n") != std::string::npos);   // minute 100 + 2 h
}

int main(void) {
    UNITY_BEGIN();
    RUN_TEST(test_ultrasonic_zero_wind_and_virtual_temp);
    RUN_TEST(test_ultrasonic_soft_wind_and_cycle_slip_lock_up_to_60ms);
    RUN_TEST(test_ultrasonic_cardinal_directions_and_sound_cancellation);
    RUN_TEST(test_ultrasonic_auto_north_and_tilt_compensation);
    RUN_TEST(test_wmo_wind_3s_gust_10min_mean_and_direction_across_north);
    RUN_TEST(test_haptic_rain_rolling_rate_event_and_daily);
    RUN_TEST(test_meteorological_formulas);
    RUN_TEST(test_air_quality_pm_only_aqi_nowcast_and_eaqi);
    RUN_TEST(test_constant_wattage_heater_on_regulated_5v_rail);
    RUN_TEST(test_longevity_sht45_bakeout_and_scd41_extreme_cold_guard);
    RUN_TEST(test_rs485_command_parsing);
    RUN_TEST(test_reboot_and_factory_reset_button_controller);
    RUN_TEST(test_astronomy_sun_moon_and_clear_sky);
    RUN_TEST(test_tiered_history_rollup_gaps_and_persistence);
    RUN_TEST(test_history_store_ring_wrap_power_loss_and_format);
    RUN_TEST(test_conditioners_vibration_pressure_and_rain_pulses);
    RUN_TEST(test_pipeline_missing_sensors_publish_null_not_defaults);
    RUN_TEST(test_pipeline_three_hour_run_trends_history_and_publishers);
    RUN_TEST(test_pipeline_daytime_cloud_cover_rain_lightning_and_thunder);
    RUN_TEST(test_sgp41_gas_index_algorithm_blackout_baseline_event_and_state);
    RUN_TEST(test_pipeline_uv_fusion_and_sgp41_gas_indices);
    RUN_TEST(test_uv_photodiode_dome_conversions);
    RUN_TEST(test_mmc5983_output_decoding);
    RUN_TEST(test_pipeline_photodiode_dome_uv_and_lux_fallback);
    RUN_TEST(test_heater_power_monitor_and_heat_check);
    RUN_TEST(test_crown_blocks_decode_into_pipeline_types);
    RUN_TEST(test_crown_rom_bootloader_flashes_and_verifies);
    RUN_TEST(test_still_air_wind_calibration);
    RUN_TEST(test_optics_cover_transmission);
    RUN_TEST(test_home_calibration_math);
    RUN_TEST(test_home_calibration_sessions);
    RUN_TEST(test_home_calibration_sample_undoes_corrections);
    RUN_TEST(test_quality_flags_and_station_health);
    RUN_TEST(test_lightning_seismic_health_rs485_decode_and_mqtt_topic);
    RUN_TEST(test_trends_records_windrose_and_exports);
    return UNITY_END();
}
