vbartusevicius/weather-station/hardware/scripts/gen_circuits.py

"""Generate KiCad netlists and schematics for the active variant's boards.

Runs inside the `eda` container:
    python3 hardware/scripts/gen_circuits.py
"""

import builtins
import importlib
import io
import json
import os
import sys
from contextlib import redirect_stderr, redirect_stdout
from pathlib import Path

import yaml

sys.path.insert(0, str(Path(__file__).resolve().parents[1] / "circuits"))
(Path(__file__).resolve().parents[1] / "build").mkdir(exist_ok=True)
os.chdir(Path(__file__).resolve().parents[1] / "build")

import common
from product_spec import load_spec
from skidl import (
    ERC,
    KICAD9,
    generate_netlist,
    reset,
    set_default_tool,
)

BUILD = common.REPO_ROOT / "hardware" / "build"
SPEC = common.SPEC_PATH
DERIVED_BEGIN = "# --- BEGIN GENERATED (hardware/scripts/gen_circuits.py) ---"
DERIVED_END = "# --- END GENERATED ---"


def generate_board(variant, name, build_fn, net_classes):
    reset()
    set_default_tool(KICAD9)
    bdir = BUILD / variant / name
    bdir.mkdir(parents=True, exist_ok=True)
    import skidl as skidl_mod
    skidl_mod.config.backup_lib_file_name = str(BUILD / "gen_circuits_sklib.py")
    import logging
    buf = io.StringIO()
    handler = logging.StreamHandler(buf)
    handler.setFormatter(logging.Formatter("%(levelname)s %(message)s"))
    skidl_logger = logging.getLogger("skidl")
    skidl_logger.addHandler(handler)
    with redirect_stdout(buf), redirect_stderr(buf):
        build_fn()
        ERC()
        generate_netlist(file_=str(bdir / f"{name}.net"))
    skidl_logger.removeHandler(handler)
    out = buf.getvalue()
    bdir.mkdir(parents=True, exist_ok=True)
    (bdir / "skidl_log.txt").write_text(out)
    parts = [
        {
            "ref": p.ref,
            "value": p.value,
            "footprint": p.footprint,
            "place": p.fields.get("Place", "misc"),
            "lcsc": p.fields.get("LCSC", ""),
            "mpn": p.fields.get("Manufacturer_Part_Number", ""),
            "mfr": p.fields.get("Manufacturer", ""),
            "assembly": p.fields.get("Assembly", "jlc"),
            "source": p.fields.get("Source", ""),
            "footprint_ref": p.fields.get("Footprint_Reference", ""),
            "stock_optional": p.fields.get("Stock_Optional", "") == "yes",
            "pins": {str(pin.num): pin.name for pin in p.pins},
        }
        for p in builtins.default_circuit.parts if not p.ref.startswith("#")
    ]
    (bdir / "parts.json").write_text(json.dumps(parts, indent=1))
    return out


def write_derived(net_classes_by_board):
    from blocks import mcu_xiao
    text = SPEC.read_text()
    derived = {
        "mcu_pins": mcu_xiao.MCU_PINS,
        "net_classes": net_classes_by_board,
    }
    block = DERIVED_BEGIN + "\n" + yaml.safe_dump(
        {"derived": derived}, sort_keys=False) + DERIVED_END + "\n"
    if DERIVED_BEGIN in text and DERIVED_END in text:
        pre = text[: text.index(DERIVED_BEGIN)]
        text = pre + block
    else:
        if not text.endswith("\n"):
            text += "\n"
        text += "\n" + block
    SPEC.write_text(text)


def collect_assembly_parts(variant, spec):
    """Automatically build the off-board + hand-fitted assembly_parts list from
    parts.json of every board in `variant` and `spec.yaml`."""
    boards = spec["variants"][variant]["boards"]
    hand_by_mpn = {}
    for b in boards:
        for p in json.loads((BUILD / variant / b / "parts.json").read_text()):
            if p["assembly"] == "hand":
                entry = hand_by_mpn.setdefault(p["mpn"], {"p": p, "locs": []})
                entry["locs"].append(f"{b} {p['ref']}")

    items = []
    if "102010636" in hand_by_mpn:
        locs = ", ".join(hand_by_mpn["102010636"]["locs"])
        items.append({
            "item": "MCU module (hand-fitted into sockets)",
            "qty": len(hand_by_mpn["102010636"]["locs"]),
            "part": "Seeed Studio XIAO ESP32C6 Pre-Soldered (SKU 102010636)",
            "description": f"ESP32-C6 module with pre-soldered 2x7 pin headers; plugs into two 5.0 mm female sockets ({locs})",
            "source": "Digi-Key 1597-102010636-ND (17 in stock, checked 2026-10-29) / Seeed Studio",
        })
        items.append({
            "item": "XIAO sockets (hand-soldered)",
            "qty": 2 * len(hand_by_mpn["102010636"]["locs"]),
            "part": "Samtec CES-107-02-G-S (1x7 2.54 mm closed-entry low-profile socket, 5.08 mm tall, gold)",
            "description": f"1x7 female header, 2.54 mm, 5.0 mm tall, soldered into {locs}; XIAO stays detachable",
            "source": "Mouser 200-CES10702GS (95 in stock, checked 2026-10-29)",
        })
    if "LTR-390UV-01" in hand_by_mpn:
        locs = ", ".join(hand_by_mpn["LTR-390UV-01"]["locs"])
        items.append({
            "item": "UV-A/UV-B Index & High-Noon ALS sensor IC (hand-reflowed)",
            "qty": len(hand_by_mpn["LTR-390UV-01"]["locs"]),
            "part": "Lite-On LTR-390UV-01 (LCSC C492374)",
            "description": f"2x2 mm 6-pin optical UV-A/UV-B + 157k lux ALS sensor ({locs}) under the PTFE dome diffuser",
            "source": "Digi-Key / Mouser / LCSC",
        })
    if "GUVB-C31SM" in hand_by_mpn:
        locs = ", ".join(hand_by_mpn["GUVB-C31SM"]["locs"])
        items.append({
            "item": "AlGaN True UV-B Sensor IC (hand-reflowed)",
            "qty": len(hand_by_mpn["GUVB-C31SM"]["locs"]),
            "part": "Genicom / GenUV GUVB-C31SM (2.0x2.3 mm 4-pin OLGA I2C 0x39)",
            "description": f"Intrinsic wide-bandgap AlGaN UV-B (240-320 nm) digital I2C sensor on dome PCB ({locs}); primary UV-index source, fused 80/20 with U1",
            "source": "GenUV / Digi-Key / Mouser",
        })
    for mpn, band, data, dk in (
            ("GUVB-C21SD", "UV-B", "AlGaN, 240-320 nm, 0.11 A/W at 300 nm", "2096-GUVB-C21SDCT-ND (5863 in stock, checked 2026-10-29)"),
            ("GUVA-C22SD", "UV-A", "GaN, 240-370 nm, 0.14 A/W at 350 nm", "2096-GUVA-C22SDCT-ND (2717 in stock, checked 2026-10-29)")):
        if mpn in hand_by_mpn:
            locs = ", ".join(hand_by_mpn[mpn]["locs"])
            items.append({
                "item": f"{band} photodiode (hand-reflowed)",
                "qty": len(hand_by_mpn[mpn]["locs"]),
                "part": f"Genicom {mpn} (COB2418 1.8 x 2.4 x 1.0 mm, pad 1 = anode)",
                "description": f"{data} Schottky photodiode, zero-bias into the TLV9062 transimpedance stage ({locs}); "
                               "not stocked at LCSC / JLCPCB",
                "source": f"Digi-Key {dk}",
            })
    if "AS3935-BQFT" in hand_by_mpn:
        locs = ", ".join(hand_by_mpn["AS3935-BQFT"]["locs"])
        items.append({
            "item": "Franklin Lightning Sensor IC (hand-reflowed)",
            "qty": len(hand_by_mpn["AS3935-BQFT"]["locs"]),
            "part": "ScioSense AS3935-BQFT (LCSC C3178344)",
            "description": f"4x4 mm MLPQ-16 lightning strike distance & energy detector ({locs})",
            "source": "Digi-Key / Mouser / LCSC",
        })
    if "MA5532-AE" in hand_by_mpn:
        locs = ", ".join(hand_by_mpn["MA5532-AE"]["locs"])
        items.append({
            "item": "AS3935 lightning antenna (hand-soldered)",
            "qty": len(hand_by_mpn["MA5532-AE"]["locs"]),
            "part": "Coilcraft MA5532-AED (100 uH +/-2 %, 11.7 x 3.5 mm open ferrite rod) or Premo SDTR1103-HF1-0100J (100 uH, 11.8 x 3.6 mm, same pads; then R26 = 6.8k)",
            "description": f"ScioSense AS3935-AN04 recommended antenna ({locs}); tuned with 2x 470 pF C0G + the AS3935 internal 0..120 pF array",
            "source": "Coilcraft direct (coilcraft.com, MA5532-AEB cut tape / MA5532-AED reel: 1738 in stock, 1.18 EUR, checked 2026-10-30) / Mouser 994-MA5532-AE (restricted: not sold to the EU / LT region); not at Digi-Key or LCSC. alternative on the same pads: Premo SDTR1103-HF1-0100J (grupopremo.com; not at Digi-Key)",
        })

    # Off-board sensors & transducers
    items.append({
        "item": "Waterproof 40 kHz Ultrasonic Transceivers (IP68) + 2-Pin JST-SH Pigtails",
        "qty": 4,
        "part": "Same Sky CUSA-TR65-065-2200-TH68 (Ø 14 x 9 mm aluminium, IP68, transceiver, 40 kHz, 150 Vp-p, -40..+80 C, 2200 pF, beam 120 x 65 deg at -6 dB: mount all four with the same pin orientation so the narrow 65 deg axis lies the same way) straight in the Ø 14.6 mm barrels + 4x 2-pin JST-SH pigtails (pin 1 = A, pin 2 = B; driven differentially). Not suitable: PUI UTR-1440K-TT-R (IP65 only); 10 mm EU10AIF40H07T/R (split transmitter / receiver pair, no drive or temperature rating)",
        "description": "4 inward-angled (29.0 deg V-beam) transceivers seated in the N/E/S/W covered barrels of crown_base.stl, locked from the back by the 4 slotted press-fit rings in transducer_adapters.stl, plugged into crown J2..J5 (BM02B-SRSS-TB, LCSC C160388). Drive is ~22 Vp-p H-bridge bursts from +12V_HEAT (15 % of the 150 Vp-p rating). All four must be the same type; re-run the still-air calibration (us_delay_us) after changing it",
        "source": "Digi-Key 2223-CUSA-TR65-065-2200-TH68-ND (350 in stock, checked 2026-10-29)",
    })
    items.append({
        "item": "20 mm Piezoelectric Haptic Rain Discs (4-Quadrant Symmetric Array)",
        "qty": 4,
        "part": "Same Sky CEB-20D64 (Ø 20 x 0.43 mm brass/ceramic piezo diaphragm, 6.5 kHz, 13 nF, wire leads; replaces the Murata 7BB-20-6L0, whose 7BB series Murata discontinued: last order 31 Mar 2026)",
        "description": "4 discs bonded (brass face only, using thin rigid cyanoacrylate Loctite 401) to the 4 coplanar Ø 20.4 mm ceiling pockets of crown.stl (NE, NW, SW, SE at r=26.8 mm) and plugged into crown J6..J9",
        "source": "Digi-Key 102-1126-ND / Farnell 4893404 (Same Sky)",
    })
    items.append({
        "item": "Flanged PTFE dome diffuser (default UV / light cover, turned part)",
        "qty": 1,
        "part": "Turned virgin (unfilled, non-porous) white PTFE dome with a Ø 20.4 x 1.5 mm flange, flat on both faces, 0.8 mm wall, in one of two shapes: LATHE version (default: Ø 17.8 mm cylinder, flat top, 2 mm edge radius, 7.5 mm tall; plain turning + boring from Ø 22-25 mm rod; enclosure/ptfe_dome_lathe.step + drawings/ptfe_dome_lathe.svg) or CNC version (Ø 17.8 mm hemisphere on the flange; enclosure/ptfe_dome_cnc.step + drawings/ptfe_dome_cnc.svg). No stock part: order from PCBWay CNC turning (material PTFE, white), an AliExpress custom-PTFE turning shop, or a lathe",
        "description": "Default cover over the dome board sensors in the `crown` top: low flush collar (lid trimmed 1.0 mm under the sensor tops), so the sensors see the sky down to slightly below the horizon. An 18 x 1.0 mm O-ring is squeezed 25 % flat between the flange top and the collar lip; the printed M22x1.5 dome nut (struts.stl) pushes the flat flange bottom, hand-tight. ~10-12 % diffuse transmission, spectrally flat 250-2500 nm (UV-B passes like visible light): firmware optics_transmission 0.11, calibrate per CALIBRATION.md step 8. Keep the PTFE white and matte: it is a diffuser, not a window (PTFE cannot be made transparent; polishing only changes the surface). Re-tighten the nut after the first week (PTFE creep)",
        "source": "PCBWay CNC (PTFE) / AliExpress custom turning / local lathe (~$2-10 per part)",
    })
    items.append({
        "item": "JGS1 Fused Silica UV Window Ø 20 x 2 mm (uncoated, backup cover)",
        "qty": 0,
        "part": "Stock JGS1 UV-grade fused-silica round window Ø 20 x 2 mm, both faces polished, uncoated (AliExpress \"Various Sizes JGS1 UV Grade Fused Silica Window Quartz Glass Polished Disk\", 20 x 2 mm; a fiber-laser protective window 20x2 only if it is uncoated - 1064 nm AR coatings cut UV-B). See enclosure/drawings/jgs1_window.svg",
        "description": "Backup cover for the `crown_window` top (same print plate as `crown`): fitted from below, a thin 17 x 1.0 mm O-ring between its top face and the 1.2 mm lid lip (seal lid <-> glass), pushed up hand-tight by the printed window nut (struts.stl). Fits diameter 19.8-20.1 mm, thickness 1.8-2.2 mm. More signal than PTFE (optics_transmission ~0.92) but the lip hides the sky below ~19-34 deg solar elevation",
        "source": "AliExpress / Taobao (JGS1 UV fused silica window 20 x 2 mm, ~$6-10)",
    })
    items.append({
        "item": "Particulate Matter Sensor Module (PM1.0/2.5/10)",
        "qty": 1,
        "part": "Plantower PMSA003I (I2C 0x12, 38.0x35.0x11.8 mm, inlet and fan exhaust on the same face, e.g. Adafruit 4505)",
        "description": "Lies face-down on the left half of the base.stl bay beside main, openings edge outward (fan toward the rear): the inlet/fan face seals onto two duct chambers whose floor slits draw and exhaust outside air only; held by two snap hooks",
        "source": "Mouser 485-4505 (Adafruit 4505 = bare Plantower PMSA003I; 4 in stock, checked 2026-10-29; the 4632 breakout does not fit the duct bed)",
    })
    items.append({
        "item": "PMSA003I harness + duct gasket",
        "qty": 1,
        "part": "Samtec FFSD-05-D-05.91-01-N (2x5 1.27 mm Tiger Eye IDC ribbon, 150 mm, 30 AWG; cut off one end) + JST ZHR-6 at the main J4 end; 1.5 mm closed-cell EPDM foam strip (1.2 mm wide, on the duct chamber wall tops)",
        "description": "Harness: keep the IDC socket on the module, cut the other end and crimp four ribbon wires into the ZHR-6 (JST SZH-003T-P0.5, 28-32 AWG): J4 pin 1 +5V -> wire 1 (VCC), pin 2 GND -> wire 3 (GND), pin 3 SDA -> wire 9, pin 4 SCL -> wire 7; cut wires 2, 4, 5, 6, 8, 10 back (module pins 1/2 and 3/4 are the same supply pins; 5/10 RESET/SET and 6/8 stay open: internal pull-ups)",
        "source": "Mouser 200-FFSD05D059101N (127 in stock, checked 2026-10-29) / LCSC (ZHR-6, crimps) / foam: local hardware",
    })
    items.append({
        "item": "Crown cable (12-pin JST-SH) + probe jumper (10-pin JST-SH)",
        "qty": 2,
        "part": "260 mm 12-conductor 30 AWG cable, OD <= 3.2 mm (or 12 loose 30 AWG wires with insulation OD <= 0.6 mm, UL10064 / UL1571, in a thin PTFE sleeve; common pre-crimped 28 AWG SH leads are 0.8-1.0 mm OD and bundle to ~4 mm, which does NOT fit), SHR-12V-S-B plug on both ends wired pin 1 <-> pin 1 (main J2 <-> crown J1, ~202 mm routed path + service loop) + 60 mm 10-wire SHR-10V-S-B jumper, pin 1 <-> pin 1 (main J3 <-> probe J1). Crimping the crown end after threading needs SSH-003T-P0.2 contacts and an SH-capable crimper (JST WC-240, or an Engineer PA-09 / IWISS SN-01BM class tool)",
        "description": "main J2 and crown J1 are 12-pin BM12B-SRSS-TB. The crown cable passes the 13x11 mm umbrella cutout, the 4.1 mm deep rear conduit of probe_sleeve_back (tested with a Ø 3.2 mm cable on a 10 mm bend radius; a Ø 4.2 mm cable does NOT fit) and the 45-deg NE split-C strut; crimp one end after threading it through the strut nut",
        "source": "Digi-Key / Mouser / LCSC / AliExpress",
    })
    for item, qty, part in (
            ("JST SH 12-pin housing (crown cable, both ends)", 2, "JST SHR-12V-S-B(LF)(SN) (LCSC C265336)"),
            ("JST SH 10-pin housing (probe jumper, both ends)", 2, "JST SHR-10V-S-B (LCSC C394370)"),
            ("JST SH 2-pin housing (4 transducer + 4 piezo pigtails)", 8, "JST SHR-02V-S-B (LCSC C246754)"),
            ("JST SH crimp contacts, 28-32 AWG (24 crown cable + 20 probe jumper + 16 pigtails)", 60, "JST SSH-003T-P0.2 (LCSC C160231)"),
            ("JST ZH 6-pin housing (PMSA003I harness, main J4 end)", 1, "JST ZHR-6 (LCSC C160379)"),
            ("JST ZH crimp contacts, 28-32 AWG (PMSA003I harness, 30 AWG ribbon wires)", 4, "JST SZH-003T-P0.5 (LCSC C263766)")):
        items.append({"item": item, "qty": qty, "part": part,
                      "description": "Connector parts for the harnesses above (crimp with an SH / ZH-capable tool)",
                      "source": "LCSC"})
    items.append({
        "item": "Stainless Steel M6 Fastener Set (Pagoda Through-Bolts & Mast Clamp Bolts)",
        "qty": 1,
        "part": "4x M6x55 DIN 7984 LOW-HEAD socket cap screws (head 10 x 3.5 mm; a standard ISO 4762 head hits the reflector board) + 4x ISO 4032 M6 nuts (pagoda stack) + 6x M6x35 hex bolts + 12x M6 washers (ISO 7089, Ø 12 mm: the 3 bolt rows are only 13 mm apart) + 6x M6 locknuts (40 mm tall mast clamp, 31 mm pole engagement)",
        "description": "A4-70 / 316 stainless steel fasteners clamping the 5-plate pagoda stack (through the Ø 6.2 mm column bores) and clamping the mast saddle: direct grip on Ø 32-34 mm poles, Ø 24-32 mm poles with the printed mast_shims (4 sizes, 31 mm tall)",
        "source": "Local hardware / McMaster-Carr / Mouser",
    })
    items.append({
        "item": "Elastomeric O-Ring Seal Set (5 Rings)",
        "qty": 1,
        "part": "3x 88 x 2.0 mm EPDM/NBR 70A O-rings (base<->pagoda, pagoda<->wind_tunnel, crown_base<->crown: glands sized for 2.0 mm, a 1.5 mm ring does not seal) + 1x 21 x 1.5 mm O-ring (probe_sleeve bottom) + 1x 18 x 1.0 mm O-ring (PTFE dome flange, default crown top) or 1x 17 x 1.0 mm O-ring (UV window, backup crown_window top)",
        "description": "Standard metric EPDM/nitrile O-rings (or 3D-printed in TPU 95A from orings.stl) sealing all 3 bayonet joints, the bottom pagoda bulkhead, and the UV cover (PTFE dome flange or JGS1 window)",
        "source": "Local hardware / McMaster-Carr / TPU 95A print",
    })
    items.append({
        "item": "Silicone-free thermal gap filler (reflector heater -> wind_tunnel deck)",
        "qty": 1,
        "part": "Silicone-free (acrylic / non-silicone) thermal gap putty or 0.25-0.5 mm soft thermal pad, >= 1 W/mK, 24 x 24 mm",
        "description": "Fills the nominal 0.08 mm (stack-up +/-0.3 mm) gap between the 4 reflector heater resistors and the underside of the wind_tunnel deck so the de-icing heat reaches the cone regardless of print tolerance. Must be silicone-free: siloxane vapour permanently poisons the SGP41 gas sensor",
        "source": "Mouser / Digi-Key / Farnell (non-silicone gap filler)",
    })
    items.append({
        "item": "IP68 Waterproof Compression Cable Gland (M12x1.5 / PG7)",
        "qty": 1,
        "part": "LAPP SKINTOP SLR-M 12x1.5 BK with locknut (S2607; IP68, cable Ø 3.5-7 mm, black)",
        "description": "Mounts in the single center Ø 12.2 mm bulkhead hole of base.stl (locknut seats in the 15.4 mm internal hex recess; knurled compression dome sits inside the Ø 26 mm protected upper mast chamber above the pole stop). The dome nut reaches below the pole stop into the mast: the mast must be a hollow tube with >= 18 mm inside diameter (e.g. 33.7 x 3.2 mm steel pipe, ID 27.3 mm) and the supply / RS-485 cable runs down inside it",
        "source": "Mouser 58-S2607 (100 in stock, checked 2026-10-29)",
    })
    items.append({
        "item": "2.4 GHz U.FL (IPEX-1) Flexible PCB Dipole Antenna (dual-band parts also fit; the ESP32-C6 uses 2.4 GHz only)",
        "qty": 1,
        "part": "Molex 1461530100 (LCSC C152350; 2.4 / 5 GHz flexible dipole, 100 mm U.FL coax; alternative Taoglas FXP830)",
        "description": "Plugs into XIAO ESP32-C6 U.FL jack (activated via GPIO3=LOW, GPIO14=HIGH); stick it (its own adhesive) horizontally on the inner bay wall above the umbrella, away from the main board (V1 has no printed cradle)",
        "source": "Mouser / Digi-Key / LCSC",
    })
    items.append({
        "item": "3D-printed roof enclosure parts (13 parts on 8 print plates)",
        "qty": 8,
        "part": "enclosure/print/<plate>.stl: base, orings, pagoda, wind_tunnel, probe_sleeve (front + back), mast_clamp (+ mast_shims), struts (+ transducer_adapters), crown (+ crown_window + crown_base) — assembled-position references in enclosure/{base,mast_clamp,orings,probe_sleeve_back,probe_sleeve_front,pagoda,wind_tunnel,struts,crown_base,crown,crown_window,mast_shims,transducer_adapters}.stl",
        "description": "Order/print the 8 enclosure/print/<plate>.stl files: all bodies laid out >= 6 mm apart, so captive and stacked bodies (umbrella, reset button, louver plates, strut halves, nuts, shims) are never printed fused. MJF PA12 or UV-stabilised ASA (TPU 95A only if printing orings); clamped to the mast with 6x M6x35 bolts",
        "source": "printed",
    })
    items.append({
        "item": "Non-siloxane polyurethane conformal coating & potting resin",
        "qty": 1,
        "part": "Electrolube URC / Humiseal 1A33 polyurethane coating (-65..+130 C) + 2-part polyurethane resin",
        "description": "Mask the silkscreened NO-COAT sensor windows (SHT40, SCD41, SGP41, BMP585, dome optics) with Kapton tape; coat both sides of main/crown/probe and pot the probe J1 connector cofferdam cup (NEVER use RTV silicone near the SGP41: its vapours poison the MOx gas sensor)",
        "source": "Mouser / Digi-Key / TME",
    })
    for it in items:
        it["category"] = ("printed" if it["source"] == "printed" else
                          "utility" if it["item"].startswith(UTILITY_ITEMS) else "electronics")
    return items


# General-purpose hardware and materials (bought locally / anywhere): listed in assembly_parts.csv only, never in the
# order files. Everything else off-board is electronics: LCSC order when it names an LCSC number, else order_elsewhere.
UTILITY_ITEMS = ("Stainless Steel M6", "Elastomeric O-Ring", "Silicone-free thermal", "IP68 Waterproof Compression Cable Gland",
                 "Non-siloxane", "Flanged PTFE dome", "JGS1 Fused Silica", "Crown cable")


def sync_assembly_parts(variant, spec):
    target = (common.REPO_ROOT / "hardware/product/assembly_parts.yaml"
              if variant == "v1" else common.REPO_ROOT / f"hardware/circuits/variants/{variant}/assembly_parts.yaml")
    header = ("# Automatically generated by hardware/scripts/gen_circuits.py from parts.json + spec.yaml.\n"
              "# Copied by hardware/scripts/release.py into the release as assembly_parts.csv.\n")
    target.write_text(header + yaml.safe_dump(collect_assembly_parts(variant, spec), sort_keys=False))


def main():
    spec = load_spec()
    variant = spec["active_variant"]
    BUILD.mkdir(parents=True, exist_ok=True)

    pkg = f"variants.{variant}"
    modules = {name: importlib.import_module(f"{pkg}.{name}")
               for name in (*spec["variants"][variant]["boards"], *spec["variants"][variant].get("legacy_boards", ()))}
    logs = {name: generate_board(variant, name, module.build, module.NET_CLASSES)
            for name, module in modules.items()}
    write_derived({name: module.NET_CLASSES for name, module in modules.items()})
    sync_assembly_parts(variant, spec)

    erc_errors = 0
    netlist_errors = 0
    for name, log in logs.items():
        print(f"=== {name} ===")
        for line in log.splitlines():
            if "ERC" in line or "error" in line.lower():
                print(" ", line)
        erc_errors += sum(1 for line in log.splitlines() if "ERC ERROR" in line)
        netlist_errors += sum(
            1 for line in log.splitlines()
            if line.startswith(("ERROR", "CRITICAL"))
            and "ERC" not in line
            and not ("No footprint for" in line and "/#" in line))
    (BUILD / "skidl_erc.txt").write_text(
        "\n\n".join(f"=== {n} ===\n{l}" for n, l in logs.items()))
    print(f"SKiDL ERC errors: {erc_errors}, non-waived netlist errors: {netlist_errors}")
    return 1 if (erc_errors or netlist_errors) else 0


if __name__ == "__main__":
    sys.exit(main())
