vbartusevicius/weather-station/hardware/scripts/jlc_parts.py

"""Check every JLC-assembled part against what JLCPCB will actually place.

CI reads the versioned supplier reference in hardware/product/jlc_reference.json,
without contacting JLCPCB or EasyEDA. Release checks use live=True to fetch fresh
part records, footprints and stock (raw responses cached in hardware/build/jlc/).
Refresh the reference with `python3 hardware/scripts/jlc_parts.py snapshot`;
`--cached` captures existing downloads without networking.
"""

import json
import math
import re
import time
import urllib.error
import urllib.request
from dataclasses import dataclass, field
from pathlib import Path

REPO = Path(__file__).resolve().parents[2]
CACHE = REPO / "hardware/build/jlc"
EASYEDA_UNIT_MM = 0.254
ORDER_BOARDS = 5
JLC_URL = "https://cart.jlcpcb.com/shoppingCart/smtGood/getComponentDetail?componentCode={}"
EASYEDA_URL = "https://lceda.cn/api/products/{}/components?version=6.5.40"
HEADERS = {"User-Agent": "Mozilla/5.0 (Macintosh; Intel Mac OS X 10_15_7) AppleWebKit/537.36 "
                         "(KHTML, like Gecko) Chrome/130.0 Safari/537.36",
           "Accept": "application/json"}

_FRESH = set()


def fetch(url, path, attempts=6, *, refresh=False):
    fresh = path.parent == CACHE and path.exists()
    if (refresh and url not in _FRESH and not fresh) or not path.exists():
        path.parent.mkdir(parents=True, exist_ok=True)
        for attempt in range(attempts):
            try:
                with urllib.request.urlopen(urllib.request.Request(url, headers=HEADERS), timeout=30) as response:
                    path.write_bytes(response.read())
                break
            except urllib.error.HTTPError as error:
                if error.code != 403 or attempt == attempts - 1:
                    raise
                time.sleep(15 * (attempt + 1))
        _FRESH.add(url)
        time.sleep(1)
    return json.loads(path.read_text())


def jlc_record(lcsc, *, refresh=False):
    return fetch(JLC_URL.format(lcsc), CACHE / f"{lcsc}.jlc.json", refresh=refresh)["data"]


def easyeda_pin_names(lcsc, *, refresh=False):
    """Pin number -> pin name of JLCPCB's (EasyEDA) symbol for the part."""
    res = fetch(EASYEDA_URL.format(lcsc), CACHE / f"{lcsc}.easyeda.json", refresh=refresh)["result"]
    shapes = list(res["dataStr"].get("shape", []))
    for sub in res.get("subparts", []):
        shapes.extend(sub.get("dataStr", {}).get("shape", []))
    names = {}
    for shape in shapes:
        if shape.startswith("P~"):
            segments = shape.split("^^")
            # field 3 is the SPICE pin order; the pin-number label (segment 4) is the pad number when present
            # (they differ e.g. for the XC6206 SOT-23 symbol: SPICE pin 2 = Vin on pad 3)
            label = segments[4].split("~")[4] if len(segments) > 4 and len(segments[4].split("~")) > 4 else ""
            number = label if re.fullmatch(r"[A-Z]?\d+", label) else segments[0].split("~")[3]
            names[number] = segments[3].split("~")[4] if len(segments) > 3 else ""
    return names
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
