vbartusevicius/weather-station/(commit log)

2026-10-17 Update project documentation and refactor crown sensor board circuit implementation
    [assembly.step, assembly_parts.csv, base.step, base.stl, crown.kicad_pcb, crown.step, crown.stl, crown_assembly_check.csv]
2026-10-17 Update documentation to reflect hardware specification changes and component substitutions
    [assembly.step, base.step, base.stl, crown.kicad_pcb, crown.step, crown.stl, crown_assembly_check.csv, crown_bom_jlc.csv]
2026-10-18 Redesign crown PCB
    [assembly.step, assembly_parts.csv, base.step, base.stl, crown.kicad_pcb, crown.step, crown.stl, crown_base.step]
2026-10-18 Move all 10 connectors to top layer and reorganize component placement for improved assembly
    [assembly.step, base.step, crown.kicad_pcb, crown.step, crown_assembly_check.csv, crown_base.step, crown_base.stl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]
2026-10-18 Regenerate v1 release files with updated timestamps
    [assembly.step, base.step, base.stl, crown.step, crown_base.step, dome.step, main.step, mast_clamp.step]
2026-10-18 Add silkscreen connector labels to all PCB variants for improved assembly identification
    [assembly.step, assembly_parts.csv, base.step, base.stl, crown.kicad_pcb, crown.step, crown_base.step, dome.kicad_pcb]
2026-10-19 Redesign UI with comprehensive dark/light theme system and enhanced visual components
    [Board.hpp, ButtonController.hpp, DeIcingHeater.cpp, DeIcingHeater.hpp, EspIdfHostStubs.hpp]
2026-10-20 Upgrade dome PCB with enhanced light sensing capabilities: add TSL25911FN visible/NIR sensor and optional GUVB-C31SM UV-B sensor
    [assembly.step, assembly_parts.csv, base.step, crown.kicad_pcb, crown.step, crown_base.step, dome.kicad_pcb, dome.step]
2026-10-20 add locking guides to enclosure assembly
    [assembly.step, base.step, base.stl, crown.step, crown.stl, crown_base.step, crown_base.stl, mast_clamp.step]
2026-10-20 Redesign UI with enhanced visualizations
    [MetCalculations.cpp, MetCalculations.hpp, test_main.cpp]
2026-10-20 implement cpp code
    [partitions.csv]
2026-10-21 Update enclosure dimensions, add power board, upgrade sensors, and redesign base bay for PMSA003I particulate module
    [assembly.step, assembly_parts.csv, base.step, base.stl, crown.kicad_pcb, crown.step, crown.stl, crown_assembly_check.csv]
2026-10-21 Remove ultrasonic wind sensor driver implementation
2026-10-21 Update documentation for 60V power system, STM32 crown board, 12V heaters, and expanded enclosure design
    [assembly.step, assembly_parts.csv, base.step, base.stl, crown.kicad_pcb, crown.step, crown.stl, crown_assembly_check.csv]
2026-10-22 Update RS-485 to poll/response mode with multi-drop addressing, add crown protocol v2 with CRC-protected status, implement wind calibration and rain scaling, fix UCC27524 enable pull-down, add transd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
    [assembly.step, assembly_parts.csv, base.step, crown.kicad_pcb, crown.step, crown_assembly_check.csv, crown_base.step, crown_base.stl]
2026-10-22 Update documentation for column-packed breakaway panel, probe LDO rail, mast clamp dimensions, transducer adapter redesign, crown SWD/auto-flash workflow, and enclosure print plate organization
    [assembly.step, assembly_parts.csv, base.step, base.stl, crown.kicad_pcb, crown.step, crown.stl, crown_base.step]
2026-10-23 Update enclosure dimensions to 236 mm height, replace JGS1 hemisphere with stock Ø 20×2 mm window, add optional crown_dome variant for horizon view, update all PCB thickness to 1.6 mm, and revise UV 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
    [assembly.step, assembly_parts.csv, base.step, base.stl, crown.kicad_pcb, crown.step, crown.stl, crown_base.step]
2026-10-23 Update AGENTS.md, CALIBRATION.md, and README.md for PTFE dome diffuser, probe heater setpoint change to −7.6 °C, crown preamp bias mode, RS-485 fail-safe bias note, and enclosure seal test
    [assembly.step, assembly_parts.csv, base.step, crown.kicad_pcb, crown.step, crown.stl, crown_assembly_check.csv, crown_base.step]
2026-10-23 Update silkscreen with large N↑ orientation marker on crown NE corner, revise AGENTS.md for data quality/health system and calibration workflow, expand CALIBRATION.md section 0 with 14-step home cali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
    [crown.kicad_pcb, crown.step, dome.kicad_pcb, dome.step, main.kicad_pcb, main.step, panel.kicad_pcb, power.kicad_pcb]
2026-10-23 Update AGENTS.md for firmware release workflow, Web UI deep links and smoke test, history storage on raw flash partition, and first-flash USB procedure in CALIBRATION.md; add CI badge and reorganize 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
2026-10-27 Update release package with ODB++ for AISLER assembly, generic MPN BOM/CPL for PCBWay/Eurocircuits
    [crown.step, crown_bom.csv, dome.step, dome_bom.csv, main.step, main_bom.csv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]
2026-10-27 Update AGENTS.md with JLC_LIVE=0 CI mode using committed jlc_reference.json snapshot, and regenerate release files with empty stock column in assembly check CSVs
    [crown.step, crown_assembly_check.csv, dome.step, dome_assembly_check.csv, main.step, main_assembly_check.csv, panel.kicad_pcb, power.step]
2026-10-29 Update dome PCB to Genicom GUVB-C21SD/GUVA-C22SD photodiodes with TLV9062 transimpedance and ADS1115 ADC, increase diameter to Ø 15.6 mm
    [assembly.step, assembly_parts.csv, base.step, crown.kicad_pcb, crown.step, crown_assembly_check.csv, crown_base.step, crown_bom.csv]
2026-10-29 Update dome PCB layout with manual reference and label placement, add Stock_Optional field for LTR-390UV-01 sensor to allow JLC assembly when in stock without failing release on shortage
    [assembly_parts.csv, crown.kicad_pcb, crown.step, dome.kicad_pcb, dome.step, dome_legacy.kicad_pcb, dome_legacy.step, dome_legacy_assembly_check.csv]
2026-10-30 Update AS3935 lightning antenna to dual land pattern supporting Coilcraft MA5532-AE or Premo SDTR1103-HF1-0100J with adjusted Q damping resistor notes, and reorganize self-assembly order files to LCS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
    [assembly_parts.csv, crown.kicad_pcb, crown.step, crown_bom.csv, crown_hand_fit.csv, dome.kicad_pcb, dome.step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]
2026-11-09 Update J1 height for the KF250-3.5 connector and revise crown PCB component placement, including replacing D8 with the JST SH 12-pin main-board connector; document PA12/SLS/MJF print design rules and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
    [assembly.step, base.step, base.stl, crown.kicad_pcb, crown.step, crown.stl, crown_base.step, crown_base.stl]
2026-11-11 Standardize hand-solderable passives on 0805 footprints and sourcing, replace the crown compass with an MMC5983MA LGA-16 and add its SET/RESET reservoir capacitor, switch the crown HSE crystal to a h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
    [assembly.step, base.step, base.stl, crown.kicad_pcb, crown.step, crown_assembly_check.csv, crown_bom.csv, crown_bom_jlc.csv]
2026-11-11 Regenerate v1 hardware release outputs for the crown, dome, legacy dome, main board, panel, and enclosure; update panel DRC data to reflect revised mouse-bite pad positions
    [crown.step, crown_base.step, crown_window.step, dome.step, dome_legacy.step, main.step, mast_clamp.step, mast_shims.step]
